wpdnr3723-a11y/WORKMODE/house/drawings/house_drawings.pdf

공 사 명 | 경산 진량 단독주택 신축공사
도 면 명 | 표지·건축개요·법규검토
도면번호 | A-000 | 축 척 | NONE

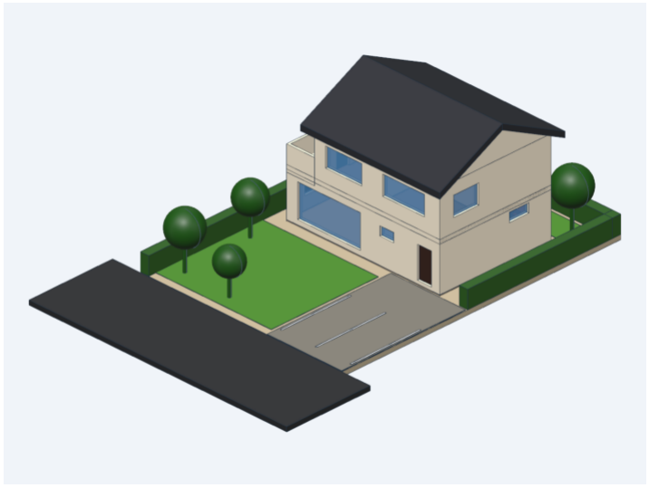
[picture p5: figure]

일 자 | 2026. 11. | 설 계 | 건축사 (미정) ※ 인허가·실시설계 검토용 초안입니다. 건축사·구조기술사의 검토와 날인 전에는 시공·제출에 쓰지 않습니다. 치수 단위 mm, 레벨 기준 GL±0 (설계 지반고).

# 경산 진량 단독주택 신축공사

# 인허가·실시설계 도서 (초안)

# 건축개요

구분 | 내용
대지위치 | 경상북도 경산시 진량읍 신제리·다문리 일원
| 경산4일반산업단지 단독주택용지 (필지번호 미정)
지역·지구 | 제1종일반주거지역, 경산4일반산업단지 지구단위계획구역
용도 | 단독주택 (제1종 근린생활시설 없음)
구조 | 철근콘크리트 벽식구조 (일부 보), 박공지붕
대지면적 | 290.00㎡
건축면적 | 82.39㎡
연면적 | 149.38㎡ (1층 82.39 / 2층 66.99)
건폐율 / 용적률 | 28.41% / 51.51%
규모 / 높이 | 지상 2층 / 8.68 m (층고 3.0 m)
주차 / 조경 | 2대 / 87.90㎡
단열 (계획 U, W/㎡K) | 외벽 0.188 / 지붕 0.120 / 바닥 0.195 / 창 1.0 이하

# 도면 목록

번호 | 도면명 | 축척
A-000 | 표지·건축개요·법규검토 | -
A-001 | 면적표·창호일람표·실내재료마감표 | -
A-101 | 배치도 | 1/100
A-201 | 1층 평면도 | 1/50
A-202 | 2층 평면도 | 1/50
A-203 | 지붕 평면도 | 1/50
A-301 | 남측 입면도 | 1/50
A-302 | 북측 입면도 | 1/50
A-303 | 동측 입면도 | 1/50
A-304 | 서측 입면도 | 1/50
A-401 | 단면도 A-A' | 1/50
A-402 | 단면도 B-B' | 1/50
A-501 | 구조단면 상세 | 1/20
S-001 | 구조 일반사항·부재일람표 | -
S-101 | 구조 평면도 | 1/100

# 법규 검토

항목 | 계획 | 기준 | 판정
건폐율 | 82.39 / 290 = 28.41% | 60% 이하 | 적합
용적률 | 149.38 / 290 = 51.51% | 180% 이하 | 적합
층수·높이 | 지상 2층, 최고높이 8.68 m | 3층 이하 | 적합
정북 일조 | 정북 인접대지경계선에서 3.0 m | 높이 10 m 이하 부분 1.5 m 이상 | 적합
접도 | 폭 6 m 도로에 14.5 m 접함 | 4 m 이상 도로에 2 m 이상 | 적합
주차 | 2대 (2.5 x 5.0 m 일반형) | 1대 이상 | 적합
조경 | 87.9 ㎡ (30%) | 경산시 건축조례 기준 | 적합
계단 | 단높이 176.5 / 단너비 260 / 너비 1000 mm | 200 이하 / 240 이상 / 600 이상 | 적합
난간 | 테라스·계단 개구부 1200 mm | 1,200 mm 이상 | 적합
인접 이격 | 서 1.5 m, 동 2.0 m, 북 3.0 m, 남 9.0 m | 0.5 m 이상 | 적합
처마 | 내밀기 0.5 m | 1 m 미만 → 건축면적 불산입 | 적합
내진 | 지상 2층 → 구조안전 확인 대상 | 내진설계 적용 | 적합
허용용도 | 단독주택 (다중주택 아님) | 단독주택·점포주택 | 적합
건축한계선 | 전면 도로 6 m (소로), 도로 이격 9.0 m | 대로 2 m / 중로 1 m | 적합
담장 | 생울타리 H1,200 | 1.2 m 이하 투시형 또는 생울타리 | 적합
옥상 설비 | 실외기 지상 설치, 지붕 위 설비 없음 | 도로에서 보이지 않게 | 적합

대지 290.00 ㎡ · 건축면적 82.39 ㎡ · 연면적 149.38 ㎡ (1층 82.39, 2층 66.99) · 층고 3.0 m

※ 기준값은 공개 자료 기준이며 해당 필지의 지구단위계획 결정도서로 확인이 필요합니다.

공 사 명 | 경산 진량 단독주택 신축공사
도 면 명 | 면적표·창호일람표·실내재료마감표
도면번호 | A-001 | 축 척 | NONE

# 면적표

층 | 바닥면적(㎡) | 용도
1층 | 82.39 | 단독주택
2층 | 66.99 | 단독주택
합계 | 149.38
층 | 실명 | 면적(㎡)
1층 | 거실 | 21.09
1층 | 주방·식당 | 21.09
1층 | 화장실 | 5.06
1층 | 현관 | 4.62
1층 | 홀 | 10.18
1층 | 다용도실 | 5.52
1층 | 계단실 | 6.47
2층 | 안방 | 15.91
2층 | 드레스룸 | 5.01
2층 | 욕실 | 5.46
2층 | 방2 | 14.10
2층 | 홀 | 11.95
2층 | 테라스 | 14.25

※ 바닥면적: 외벽 중심선 (외단열 포함 벽두께의 중심)

※ 실면적: 마감면 기준 안목치수

# 창호일람표

기호 | 층 | 위치 | 규격 W x H | 하단 | 형식·사양
W1 | 1F | 거실 | 4,500 x 2,200 | FL+100 | PVC 시스템 슬라이딩도어, 43mm 삼중 로이유리
W2 | 1F | 화장실 | 1,000 x 600 | FL+1,500 | PVC 시스템창호, 24mm 삼중 로이유리 (불투명)
D1 | 1F | 현관 | 1,000 x 2,100 | FL+0 | 단열 현관문 (방화·방범), 열관류율 1.4 이하
W3 | 1F | 주방 | 2,400 x 1,100 | FL+1,000 | PVC 시스템창호, 24mm 삼중 로이유리
W4 | 1F | 다용도실 | 1,000 x 900 | FL+1,200 | PVC 시스템창호, 24mm 삼중 로이유리
W5 | 1F | 거실 | 2,500 x 1,300 | FL+900 | PVC 시스템창호, 24mm 삼중 로이유리
W6 | 1F | 식당 | 2,000 x 1,300 | FL+900 | PVC 시스템창호, 24mm 삼중 로이유리
W7 | 1F | 계단실 | 1,400 x 600 | FL+2,000 | PVC 시스템창호, 24mm 삼중 로이유리
W8 | 2F | 안방 | 2,600 x 1,300 | FL+900 | PVC 시스템창호, 24mm 삼중 로이유리
W9 | 2F | 방2 | 3,000 x 1,300 | FL+900 | PVC 시스템창호, 24mm 삼중 로이유리
W10 | 2F | 욕실 | 1,000 x 600 | FL+1,500 | PVC 시스템창호, 24mm 삼중 로이유리 (불투명)
W11 | 2F | 홀 | 1,800 x 1,200 | FL+900 | PVC 시스템창호, 24mm 삼중 로이유리
D2 | 2F | 안방 | 900 x 2,100 | FL+0 | PVC 시스템 여닫이문, 24mm 삼중 로이유리
W12 | 2F | 안방 | 1,600 x 1,300 | FL+900 | PVC 시스템창호, 24mm 삼중 로이유리
W13 | 2F | 방2 | 1,800 x 1,300 | FL+900 | PVC 시스템창호, 24mm 삼중 로이유리
AD1 | 1·2F | 3개소 | 900 x 2,100 | FL | ABS 도어 + 목재 문틀
AD2 | 1·2F | 4개소 | 800 x 2,100 | FL | ABS 도어 (욕실·다용도: 방수형)
AD3 | 1·2F | 1개소 | 900 x 2,100 | FL | 현관 중문 (강화유리 + 알루미늄 프레임)

# 실내재료마감표

층 | 실명 | 바닥 | 걸레받이 | 벽 | 천장 | 반자높이
1F | 거실 | 강마루 THK10 | PVC 걸레받이 H80 | 실크벽지 | 석고보드 9.5 2겹 위 수성페인트 | 2,400
1F | 주방·식당 | 강마루 THK10 | PVC 걸레받이 H80 | 실크벽지 | 석고보드 9.5 2겹 위 수성페인트 | 2,400
1F | 화장실 | 포세린타일 300x300 (논슬립) | - | 포세린타일 300x600 | SMC 천장재 | 2,400
1F | 현관 | 포세린타일 600x600 | 타일 걸레받이 H100 | 실크벽지 | 석고보드 9.5 2겹 위 수성페인트 | 2,400
1F | 홀 | 강마루 THK10 | PVC 걸레받이 H80 | 실크벽지 | 석고보드 9.5 2겹 위 수성페인트 | 2,400
1F | 다용도실 | 포세린타일 300x300 | 타일 걸레받이 H100 | 수성페인트 | 석고보드 9.5 2겹 위 수성페인트 | 2,400
1F | 계단실 | 강마루 계단재 | - | 실크벽지 | 석고보드 위 수성페인트 | 2,400
2F | 안방 | 강마루 THK10 | PVC 걸레받이 H80 | 실크벽지 | 석고보드 9.5 2겹 위 수성페인트 | 2,400
2F | 드레스룸 | 강마루 THK10 | PVC 걸레받이 H80 | 실크벽지 | 석고보드 9.5 2겹 위 수성페인트 | 2,400
2F | 욕실 | 포세린타일 300x300 (논슬립) | - | 포세린타일 300x600 | SMC 천장재 | 2,400
2F | 방2 | 강마루 THK10 | PVC 걸레받이 H80 | 실크벽지 | 석고보드 9.5 2겹 위 수성페인트 | 2,400
2F | 홀 | 강마루 THK10 | PVC 걸레받이 H80 | 실크벽지 | 석고보드 9.5 2겹 위 수성페인트 | 2,400
2F | 테라스 | 합성목재 데크 (우레탄 도막방수 위) | - | 스터코 (외벽) | - | -

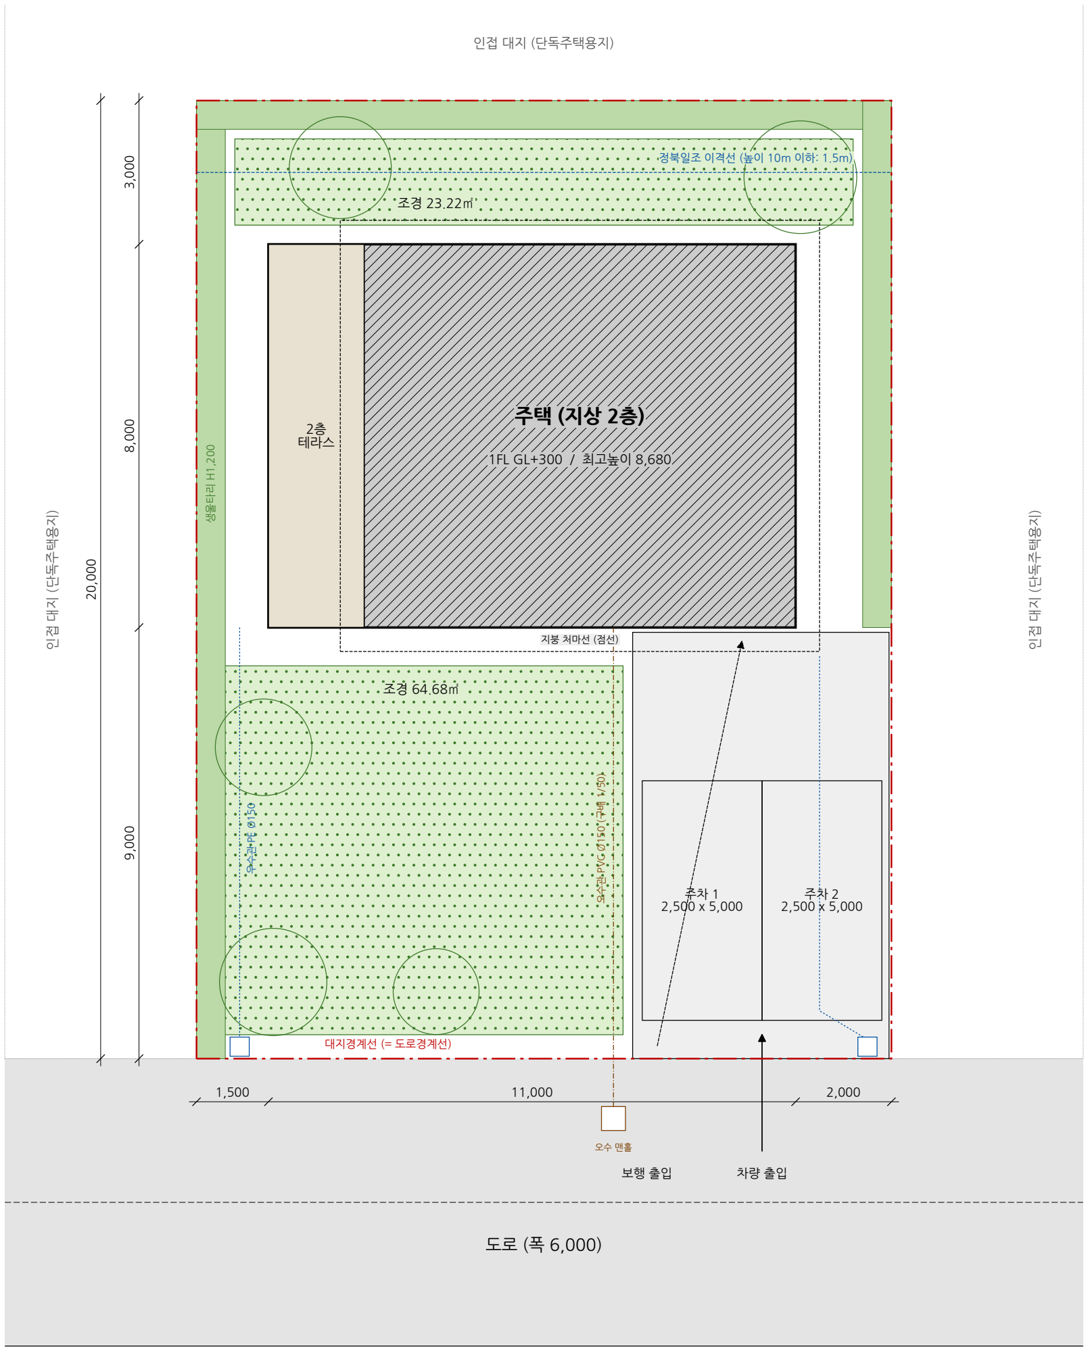
[picture p6: figure]
인접 대지 (단독주택용지); 1FL GL+300 / 최고높이 8,680; 2층 테라스; 지붕 처마선 (점선); 대지경계선 (= 도로경계선); 정북일조 이격선 (높이 10m 이하: 1.5m); 오수관 PVC Ø150 (구배 1/50); 우수관 PE Ø150; 생울타리 H1,200

14,500

공 사 명 | 경산 진량 단독주택 신축공사
도 면 명 | 배치도
도면번호 | A-101 | 축 척 | 1/100

# 배치도

SCALE 1/100
N
항목 | 내용
대지위치 | 경상북도 경산시 진량읍 신제리·다문리 일원
| 경산4일반산업단지 단독주택용지 (필지번호 미정)
지역·지구 | 제1종일반주거지역, 지구단위계획구역
대지면적 | 290.00㎡ (14,500 x 20,000)
건축면적 | 82.39㎡ (건폐율 28.41% / 60%)
연면적 | 149.38㎡ (용적률 51.51% / 180%)
규모·높이 | 지상 2층, 최고높이 8.68m
주차 | 2대 (법정 1대), 일반형 2.5 x 5.0 m
조경 | 87.90㎡ (30.3%)
이격거리 | 정북 3.0m, 서 1.5m, 동 2.0m, 남 9.0m

※ 필지 확정 후 지적측량 성과도로 대지 형상·면적·도로 폭을 다시 확인합니다.

※ 오수: 분류식 공공하수관 직접 연결 (정화조 없음, 지구 하수계획 확인).

※ 설계 지반고 GL±0 = 도로 경계 보도 상단 +150 (현황측량 후 확정).

※ 우수: 선홈통 → 우수관 → 도로측 우수 맨홀 (빗물 침투 화단 병행 검토).

# 1층 평면도

N

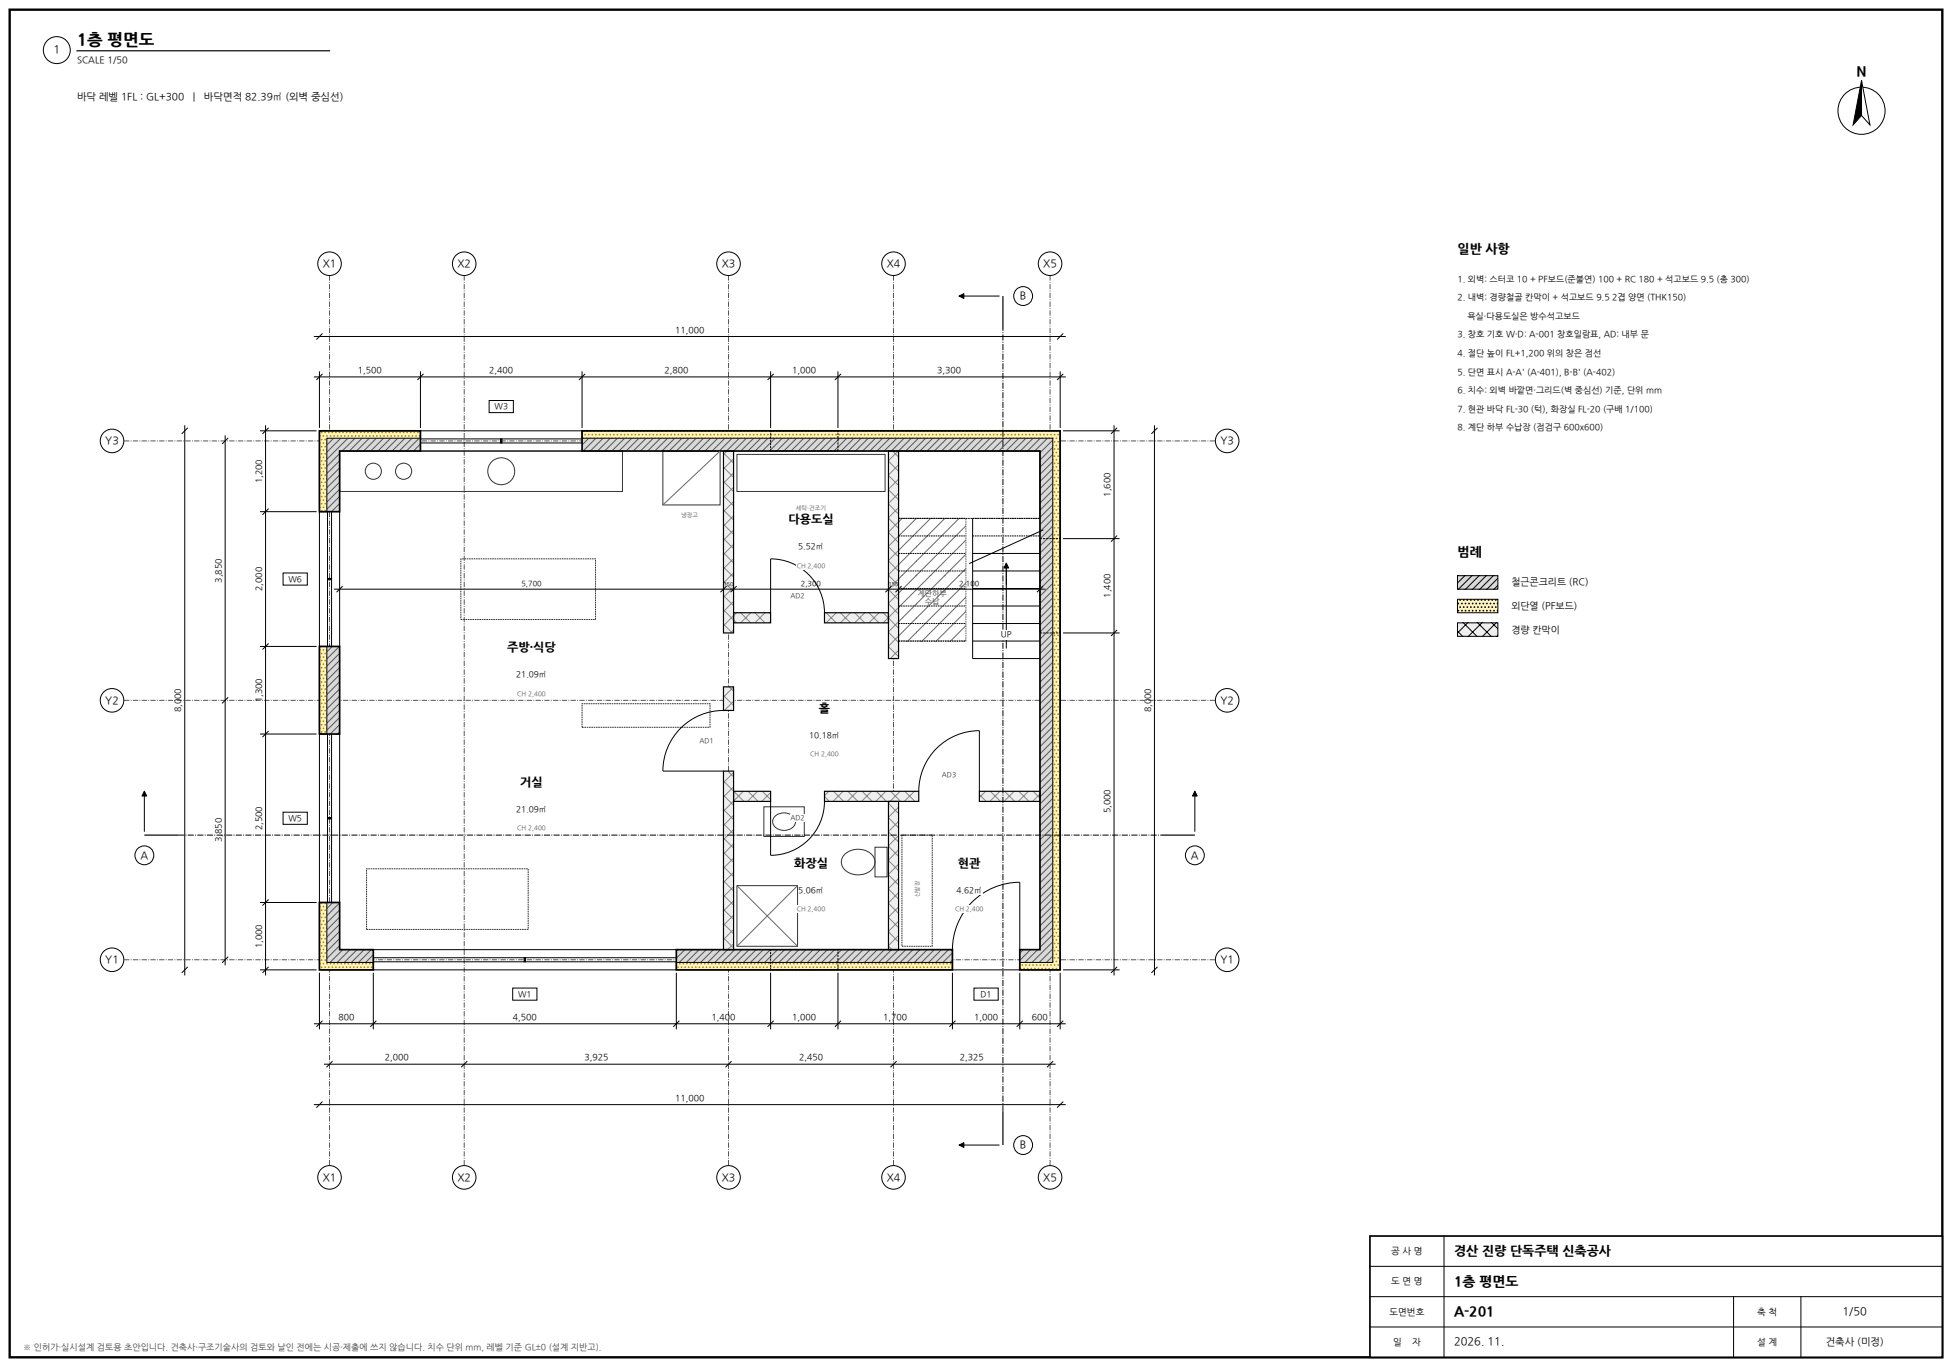
[picture p7: page 4]
계단하부; 냉장고; 세탁·건조기; 신발장; 화장실; 다용도실; 경산 진량 단독주택 신축공사; 1층 평면도; 도면번호; 철근콘크리트 (RC); 외단열 (PF보드); 경량 칸막이

바닥 레벨 1FL : GL+300 | 바닥면적 82.39㎡ (외벽 중심선)

1. 외벽: 스터코 10 + PF보드(준불연) 100 + RC 180 + 석고보드 9.5 (총 300)

2. 내벽: 경량철골 칸막이 + 석고보드 9.5 2겹 양면 (THK150)

욕실·다용도실은 방수석고보드

3. 창호 기호 W·D: A-001 창호일람표, AD: 내부 문

6. 치수: 외벽 바깥면·그리드(벽 중심선) 기준, 단위 mm

7. 현관 바닥 FL-30 (턱), 화장실 FL-20 (구배 1/100)

8. 계단 하부 수납장 (점검구 600x600)

# 2층 평면도

N

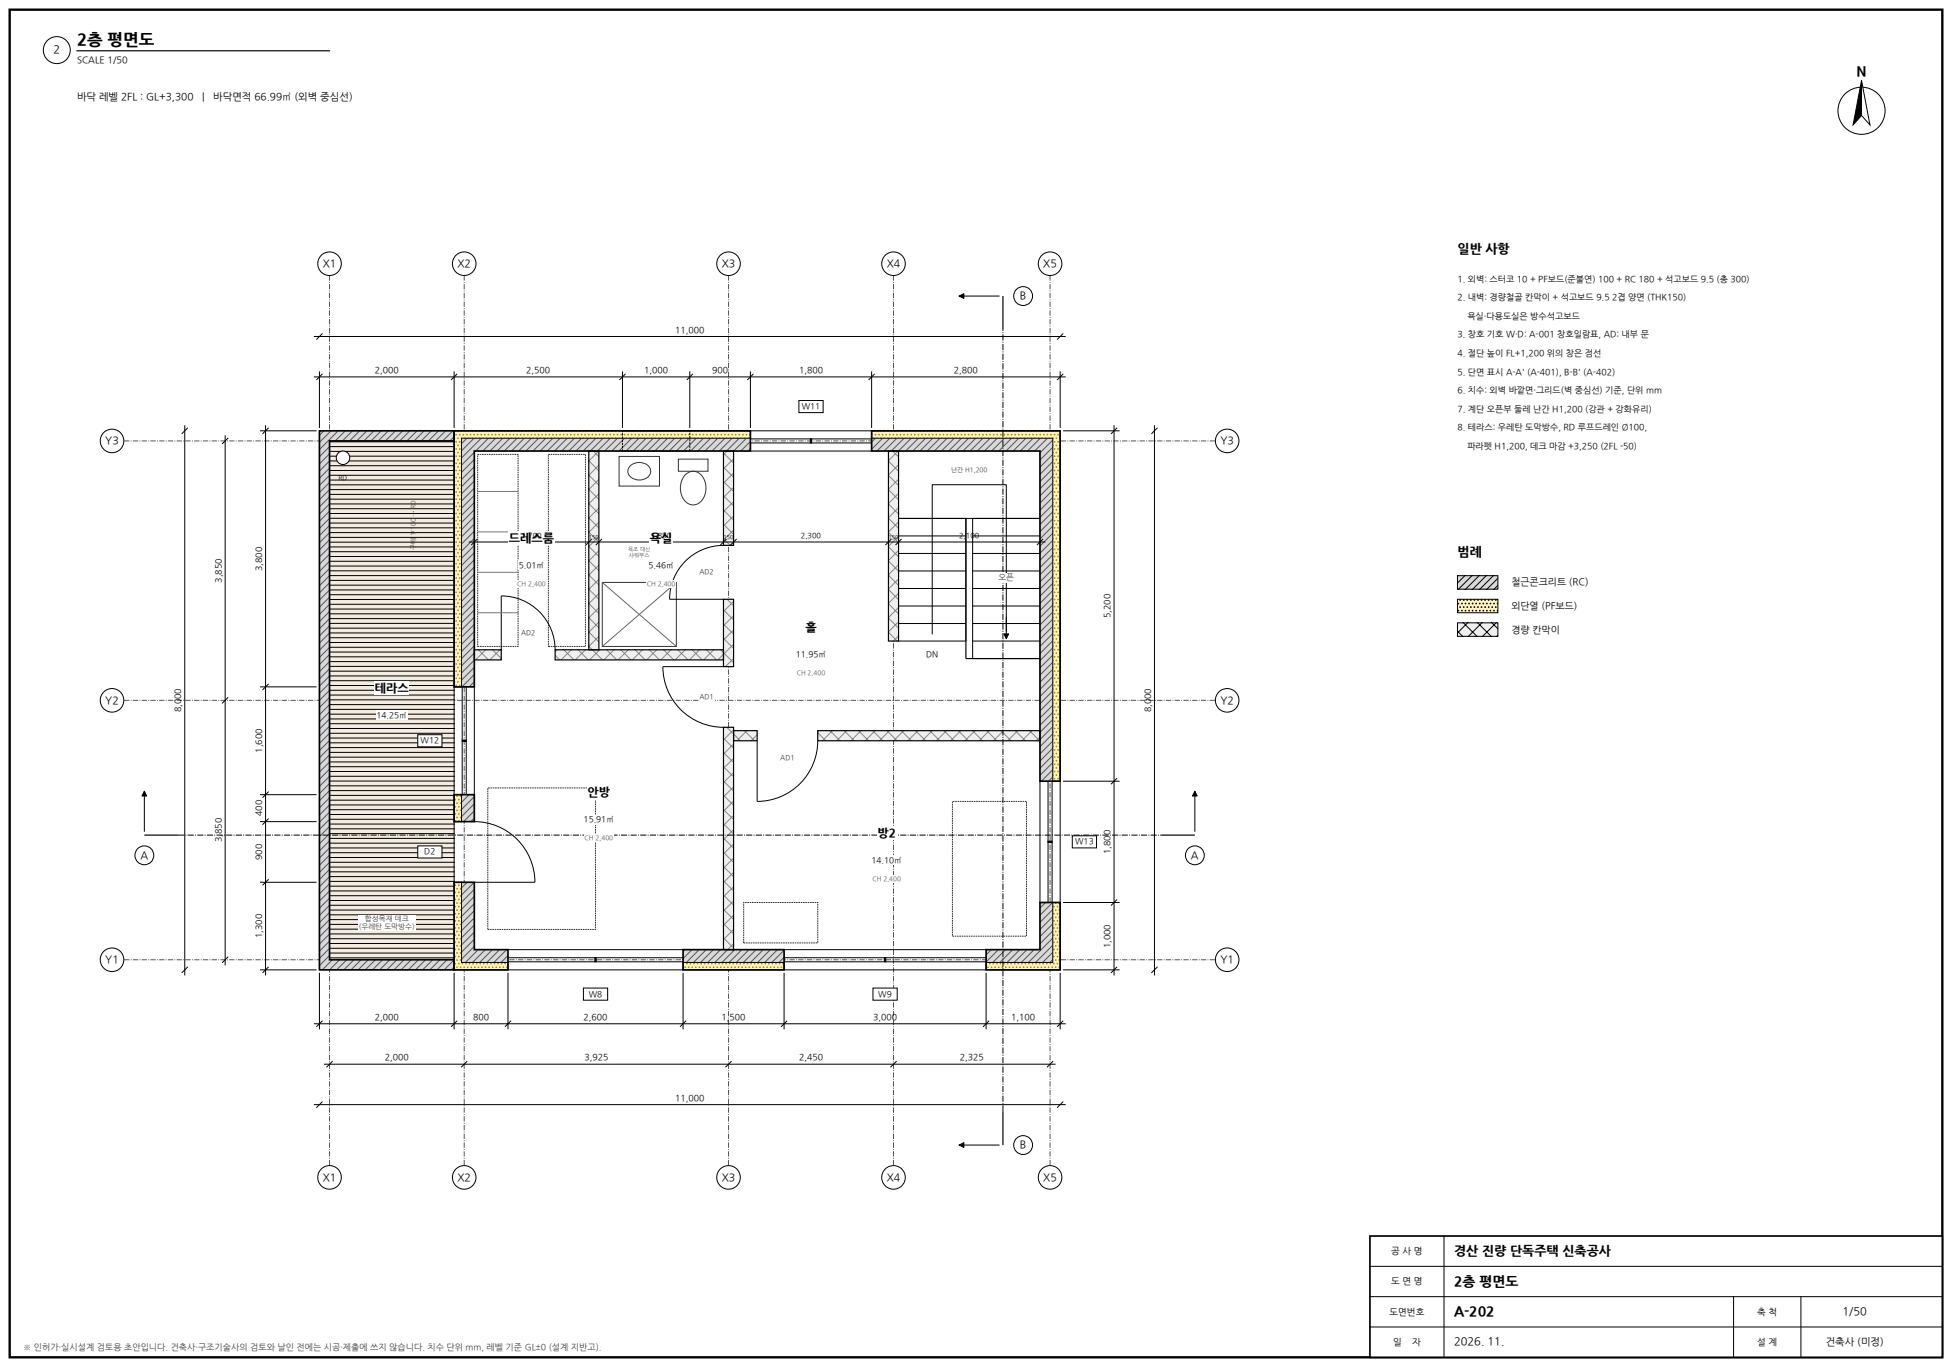
[picture p8: page 5]
합성목재 데크 (우레탄 도막방수); 욕조 대신 샤워부스; 테라스; 경산 진량 단독주택 신축공사; 2층 평면도; 도면번호; 철근콘크리트 (RC); 외단열 (PF보드); 경량 칸막이

바닥 레벨 2FL : GL+3,300 | 바닥면적 66.99㎡ (외벽 중심선)

1. 외벽: 스터코 10 + PF보드(준불연) 100 + RC 180 + 석고보드 9.5 (총 300)

2. 내벽: 경량철골 칸막이 + 석고보드 9.5 2겹 양면 (THK150)

욕실·다용도실은 방수석고보드

3. 창호 기호 W·D: A-001 창호일람표, AD: 내부 문

6. 치수: 외벽 바깥면·그리드(벽 중심선) 기준, 단위 mm

7. 계단 오픈부 둘레 난간 H1,200 (강관 + 강화유리)

8. 테라스: 우레탄 도막방수, RD 루프드레인 Ø100,

파라펫 H1,200, 데크 마감 +3,250 (2FL -50)

드레스룸 욕실 | | 난간 H1,200

# 지붕 평면도

N

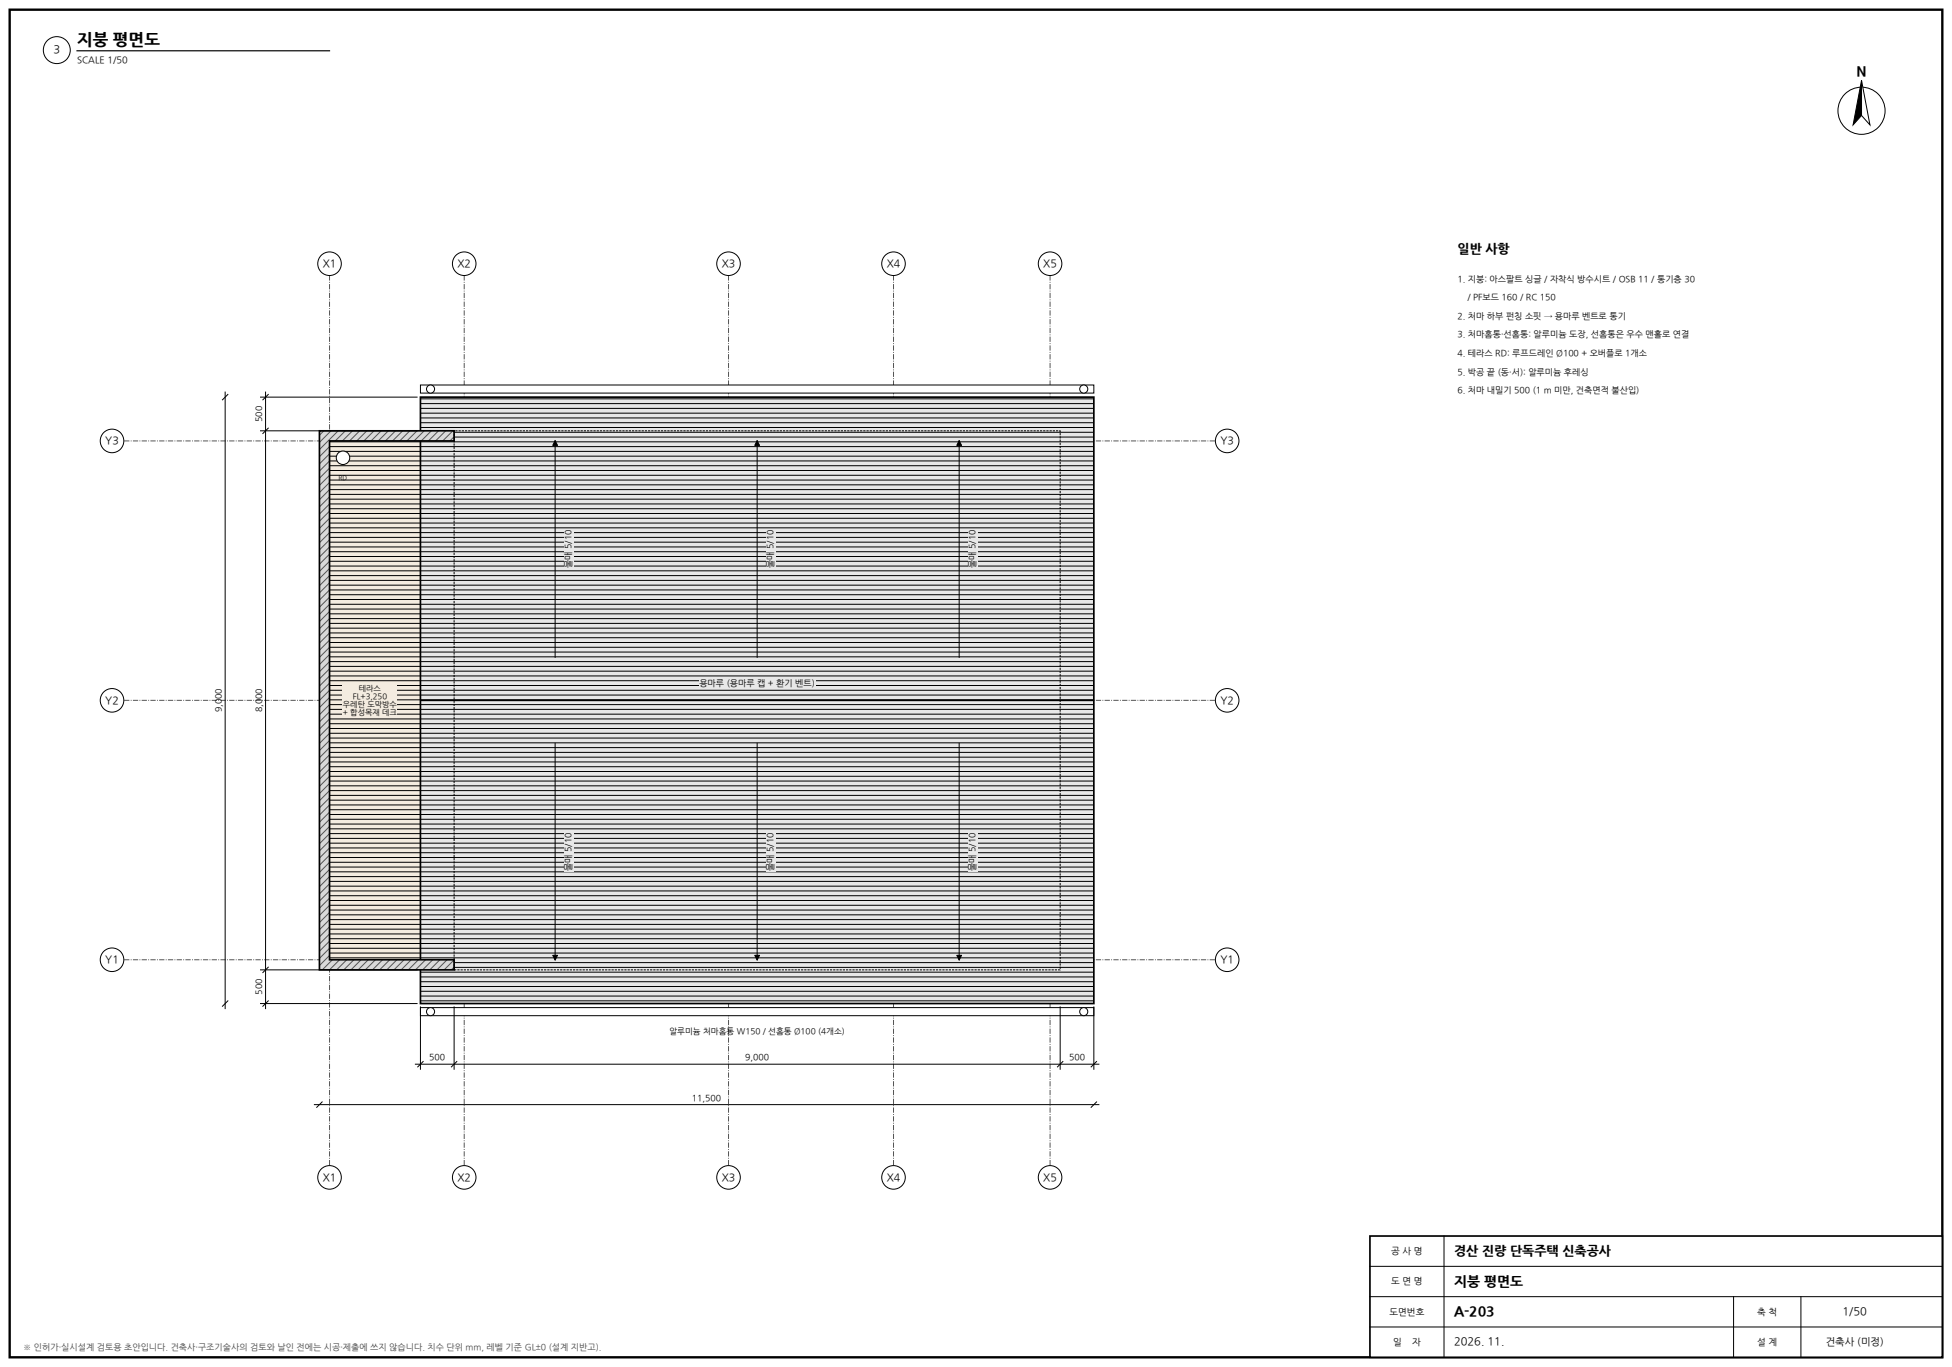
[picture p9: page 6]
테라스 FL+3,250 우레탄 도막방수 + 합성목재 데크; 경산 진량 단독주택 신축공사; 지붕 평면도; 도면번호; / PF보드 160 / RC 150

1. 지붕: 아스팔트 싱글 / 자착식 방수시트 / OSB 11 / 통기층 30

2. 처마 하부 펀칭 소핏 → 용마루 벤트로 통기

3. 처마홈통·선홈통: 알루미늄 도장, 선홈통은 우수 맨홀로 연결

4. 테라스 RD: 루프드레인 Ø100 + 오버플로 1개소

5. 박공 끝 (동·서): 알루미늄 후레싱

6. 처마 내밀기 500 (1 m 미만, 건축면적 불산입)

용마루 (용마루 캡 + 환기 벤트)

알루미늄 처마홈통 W150 / 선홈통 Ø100 (4개소)

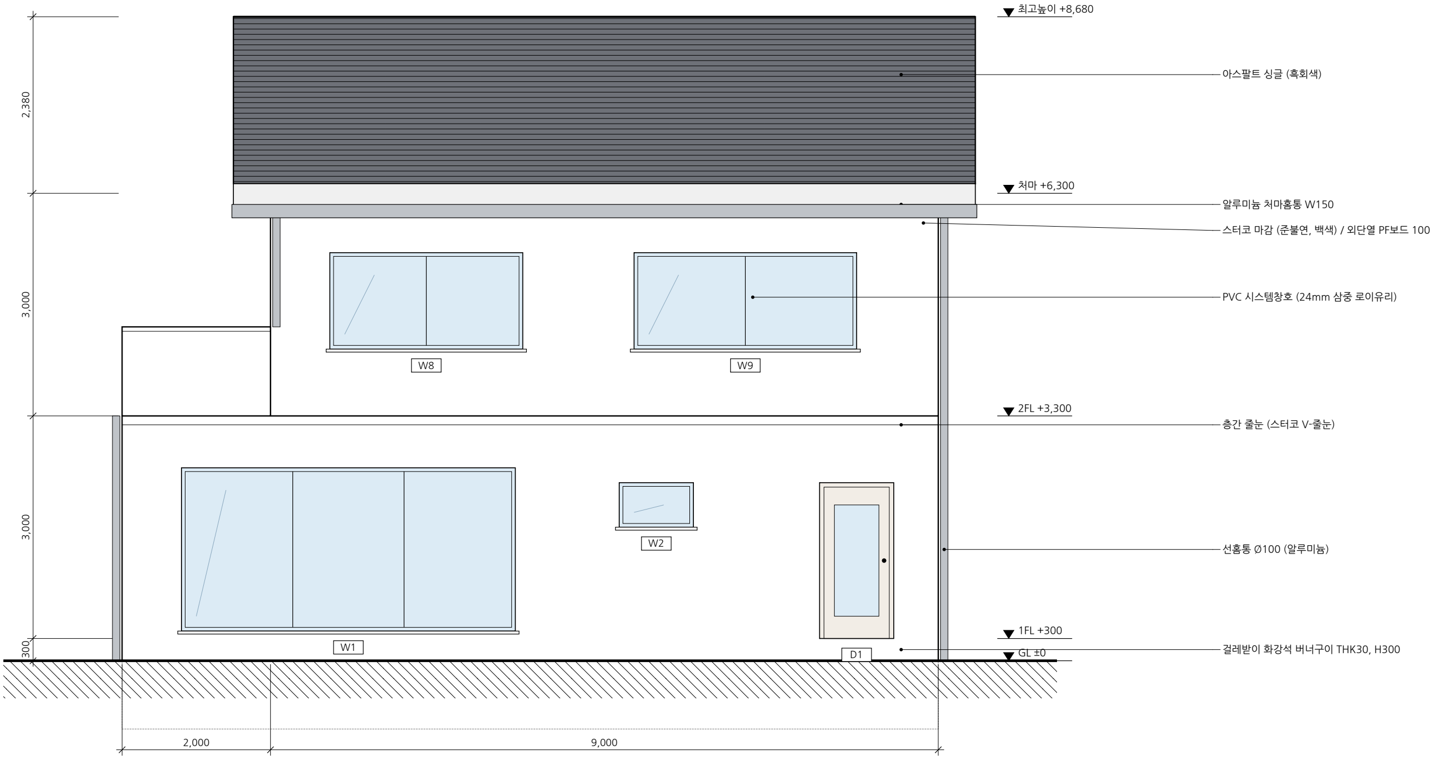
[picture p10: figure]
최고높이 +8,680; 아스팔트 싱글 (흑회색); 알루미늄 처마홈통 W150; 스터코 마감 (준불연, 백색) / 외단열 PF보드 100; PVC 시스템창호 (24mm 삼중 로이유리); 층간 줄눈 (스터코 V-줄눈); 선홈통 Ø100 (알루미늄); 걸레받이 화강석 버너구이 THK30, H300

8,680

공 사 명 | 경산 진량 단독주택 신축공사
도 면 명 | 남측 입면도
도면번호 | A-301 | 축 척 | 1/50

# 남측 입면도

## 외부 마감 사항

1. 외벽: 스터코(준불연) 백색, 하부 걸레받이 화강석 THK30 H300
2. 지붕: 아스팔트 싱글 (흑회색), 처마 하부 알루미늄 소핏
3. 창호: PVC 시스템창호 (회색 래핑), 24mm 삼중 로이유리
4. 홈통: 알루미늄 처마홈통 W150, 선홈통 Ø100
5. 테라스 파라펫: RC + 외단열, 상부 알루미늄 두겁

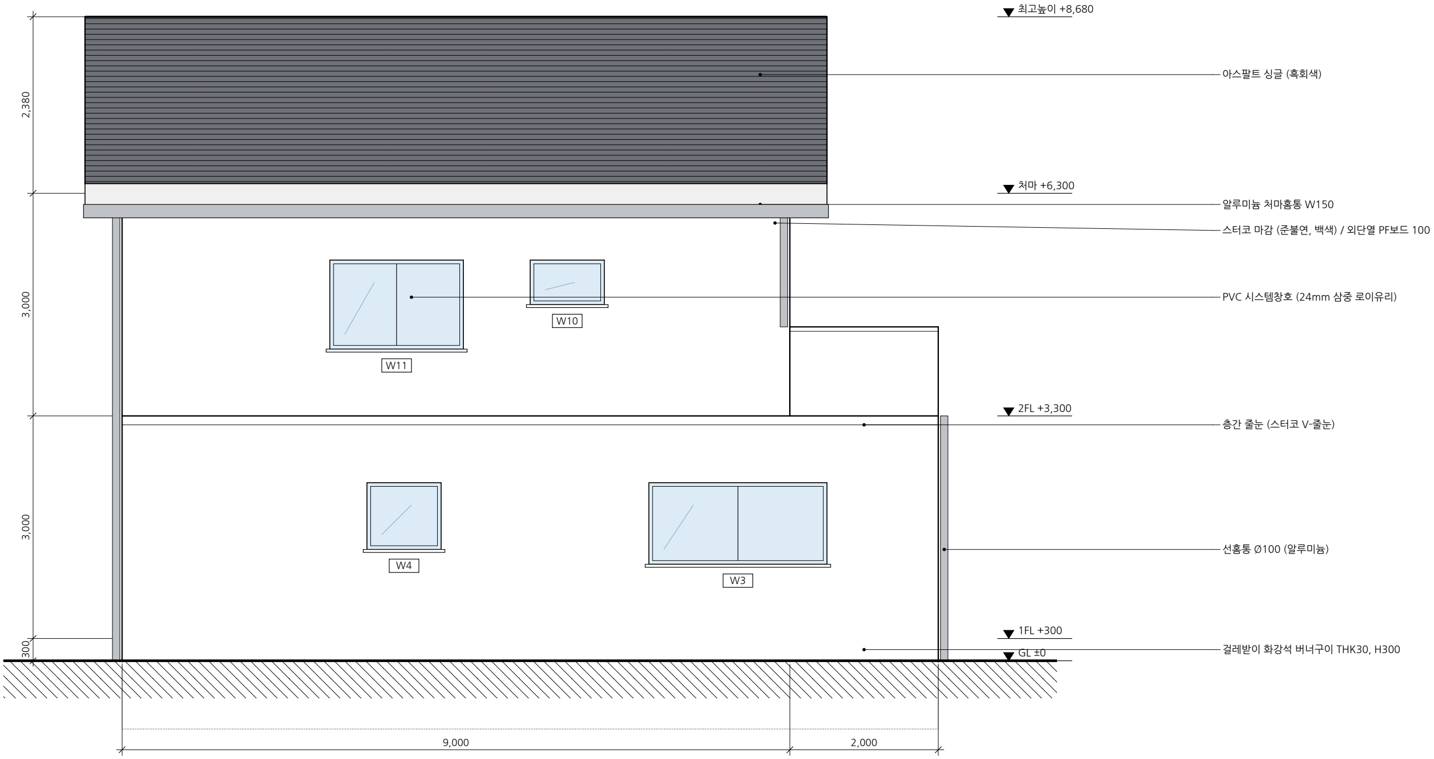
[picture p11: figure]
최고높이 +8,680; 아스팔트 싱글 (흑회색); 알루미늄 처마홈통 W150; 스터코 마감 (준불연, 백색) / 외단열 PF보드 100; PVC 시스템창호 (24mm 삼중 로이유리); 층간 줄눈 (스터코 V-줄눈); 선홈통 Ø100 (알루미늄); 걸레받이 화강석 버너구이 THK30, H300

8,680

공 사 명 | 경산 진량 단독주택 신축공사
도 면 명 | 북측 입면도
도면번호 | A-302 | 축 척 | 1/50

# 북측 입면도

## 외부 마감 사항

1. 외벽: 스터코(준불연) 백색, 하부 걸레받이 화강석 THK30 H300
2. 지붕: 아스팔트 싱글 (흑회색), 처마 하부 알루미늄 소핏
3. 창호: PVC 시스템창호 (회색 래핑), 24mm 삼중 로이유리
4. 홈통: 알루미늄 처마홈통 W150, 선홈통 Ø100
5. 테라스 파라펫: RC + 외단열, 상부 알루미늄 두겁

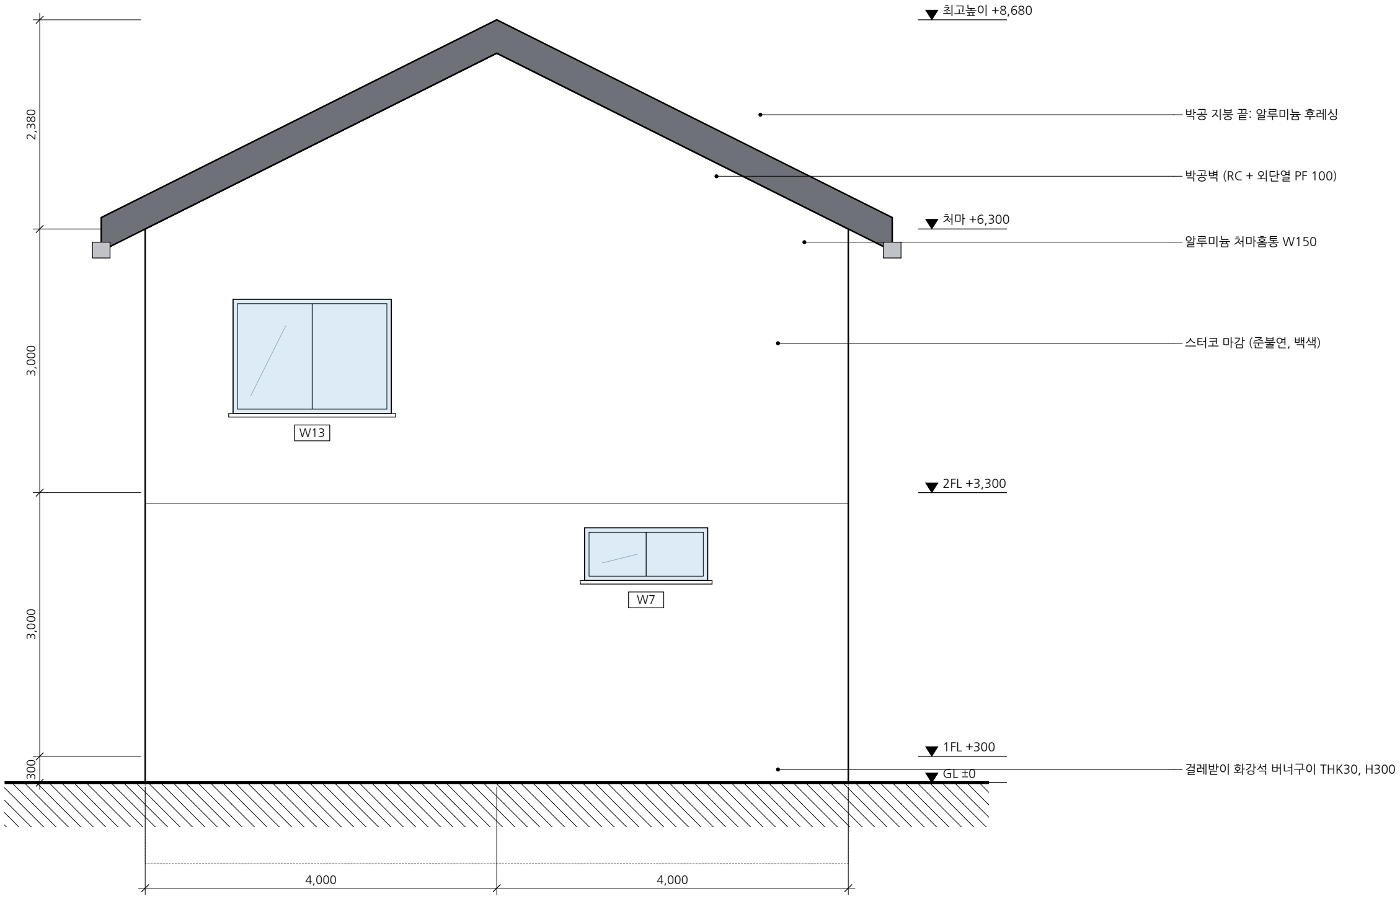
[picture p12: figure]
최고높이 +8,680; 박공 지붕 끝: 알루미늄 후레싱; 박공벽 (RC + 외단열 PF 100); 알루미늄 처마홈통 W150; 스터코 마감 (준불연, 백색); 걸레받이 화강석 버너구이 THK30, H300

8,680

공 사 명 | 경산 진량 단독주택 신축공사
도 면 명 | 동측 입면도
도면번호 | A-303 | 축 척 | 1/50

# 동측 입면도

## 외부 마감 사항

1. 외벽: 스터코(준불연) 백색, 하부 걸레받이 화강석 THK30 H300
2. 지붕: 아스팔트 싱글 (흑회색), 처마 하부 알루미늄 소핏
3. 창호: PVC 시스템창호 (회색 래핑), 24mm 삼중 로이유리
4. 홈통: 알루미늄 처마홈통 W150, 선홈통 Ø100
5. 테라스 파라펫: RC + 외단열, 상부 알루미늄 두겁

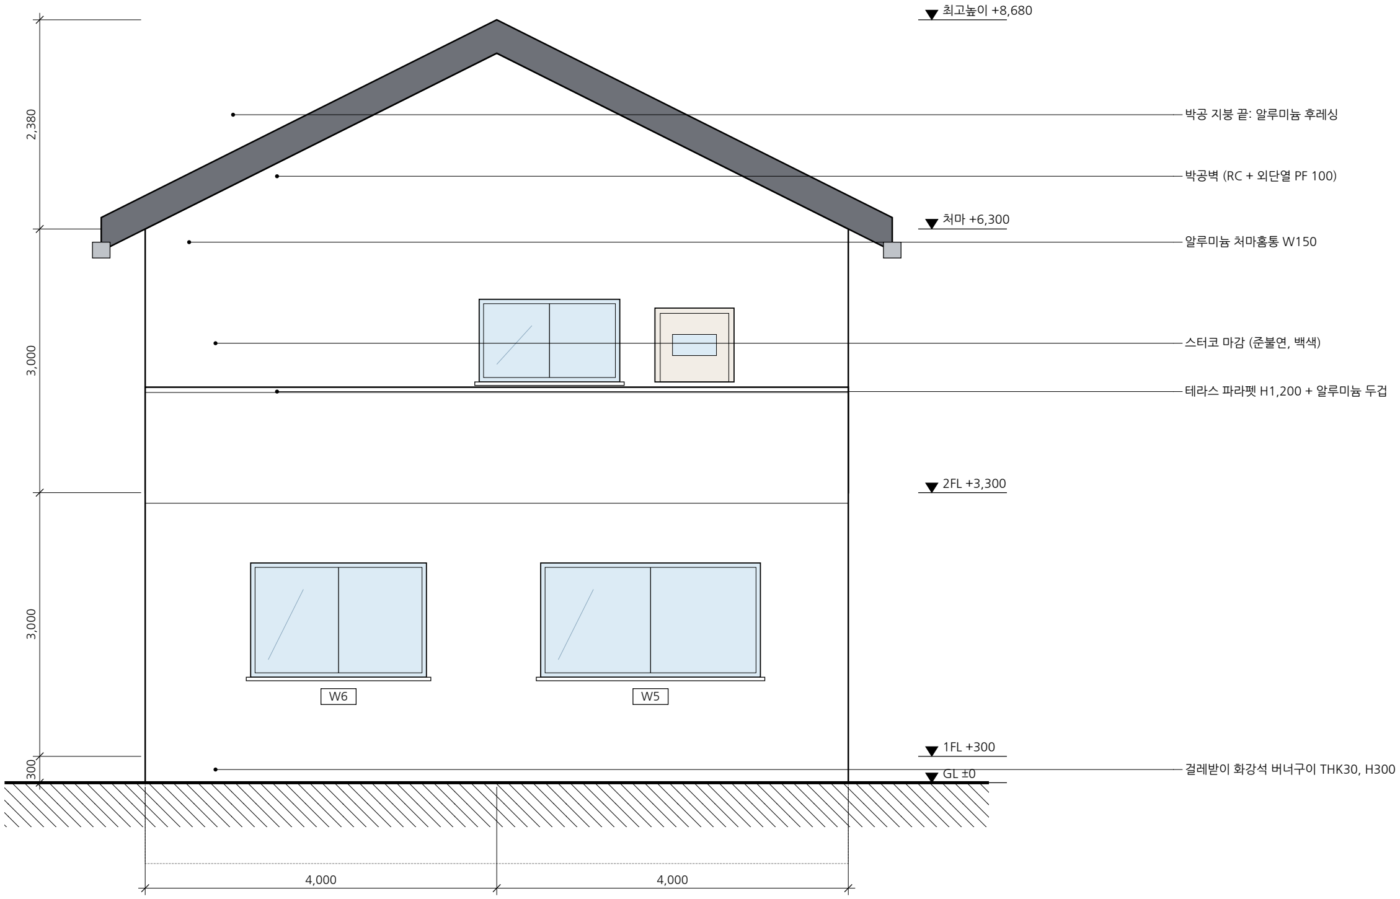
[picture p13: figure]
최고높이 +8,680; 박공 지붕 끝: 알루미늄 후레싱; 박공벽 (RC + 외단열 PF 100); 알루미늄 처마홈통 W150; 스터코 마감 (준불연, 백색); 테라스 파라펫 H1,200 + 알루미늄 두겁; 걸레받이 화강석 버너구이 THK30, H300

8,680

공 사 명 | 경산 진량 단독주택 신축공사
도 면 명 | 서측 입면도
도면번호 | A-304 | 축 척 | 1/50

# 서측 입면도

## 외부 마감 사항

1. 외벽: 스터코(준불연) 백색, 하부 걸레받이 화강석 THK30 H300
2. 지붕: 아스팔트 싱글 (흑회색), 처마 하부 알루미늄 소핏
3. 창호: PVC 시스템창호 (회색 래핑), 24mm 삼중 로이유리
4. 홈통: 알루미늄 처마홈통 W150, 선홈통 Ø100
5. 테라스 파라펫: RC + 외단열, 상부 알루미늄 두겁

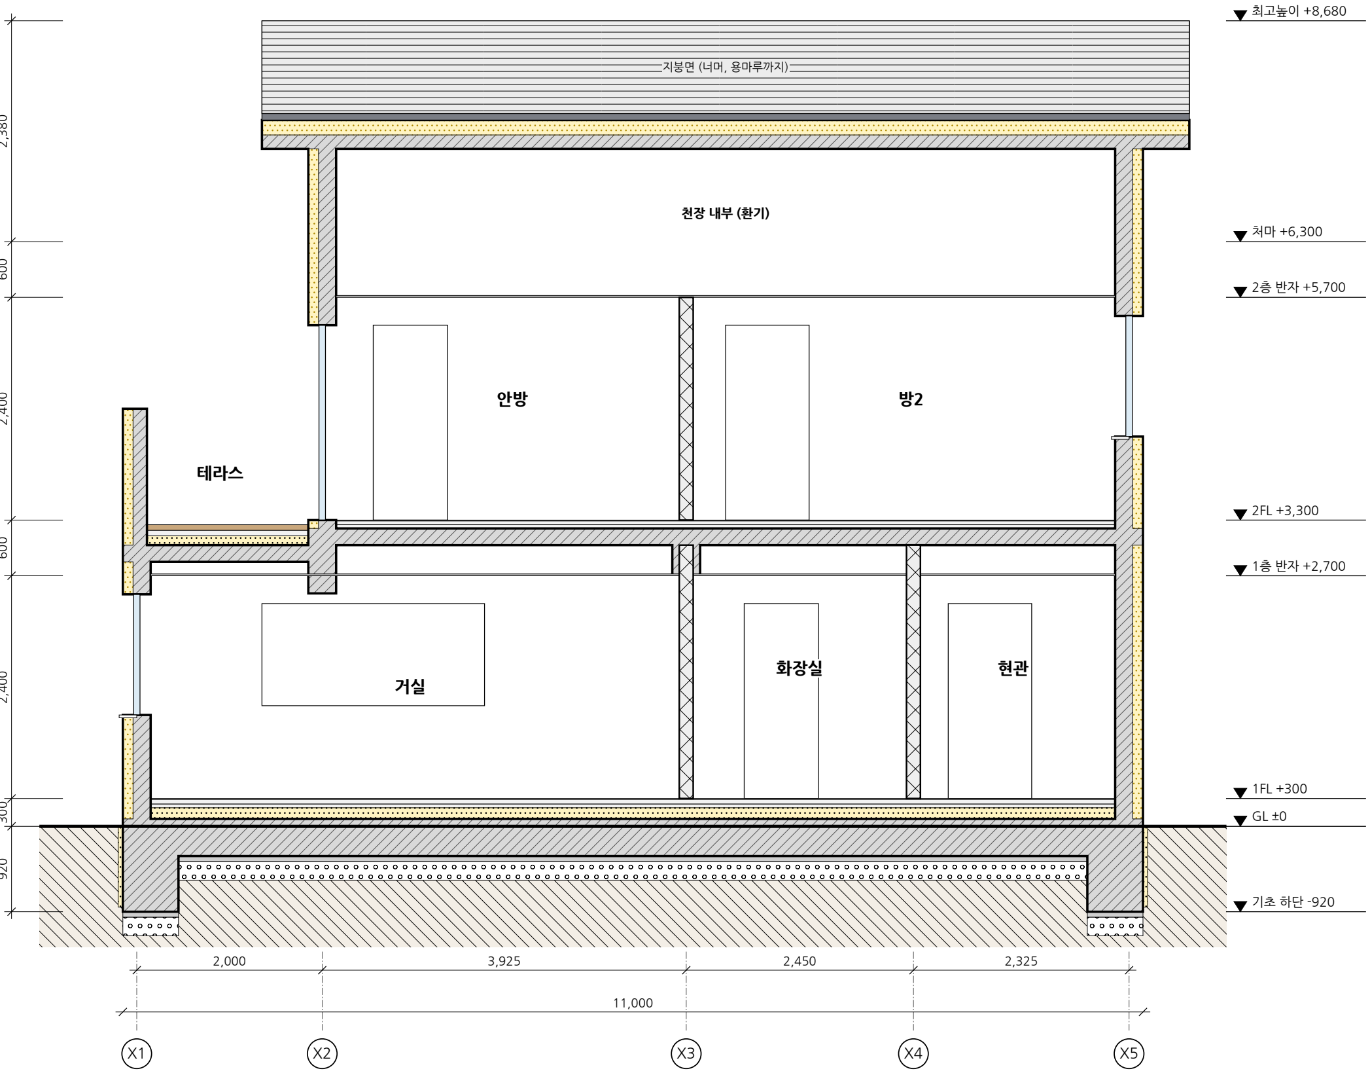
[picture p14: figure]
지붕면 (너머, 용마루까지); 화장실; 테라스; 최고높이 +8,680

920 300 2,400 600 2,400 600 2,380

8,680

공 사 명 | 경산 진량 단독주택 신축공사
도 면 명 | 단면도 A-A'
도면번호 | A-401 | 축 척 | 1/50

# 단면도 A-A'

절단 위치: 평면도 A-A' (y = 11,000 위치에서 북측을 봄)

## 일반 사항

1. 지붕: 싱글 / 방수시트 / OSB 11 / 통기층 30 / PF보드 160 / RC 150
2. 외벽: 스터코 10 / PF보드 100 / RC 180 / 석고보드 9.5
3. 1층 바닥: 강마루 10 / 미장 50 / 기포 40 / XPS 특호 120

/ PE필름 / 매트기초 400

5. 2층 바닥: 강마루 10 / 미장 40 / 기포 40 / RC 180
6. 테라스: 데크 / 보호몰탈 / 우레탄 도막방수 / PF보드 100 / RC 180
7. 기초: 매트 F1 THK400 + 외곽 기초보 FG1 (하단 GL-920)
8. 천장: 경량철골 천장틀 + 석고보드 9.5 2겹, 천장 내부 환기
9. 상세: A-501 구조단면 상세, 부재: S-001 부재일람표

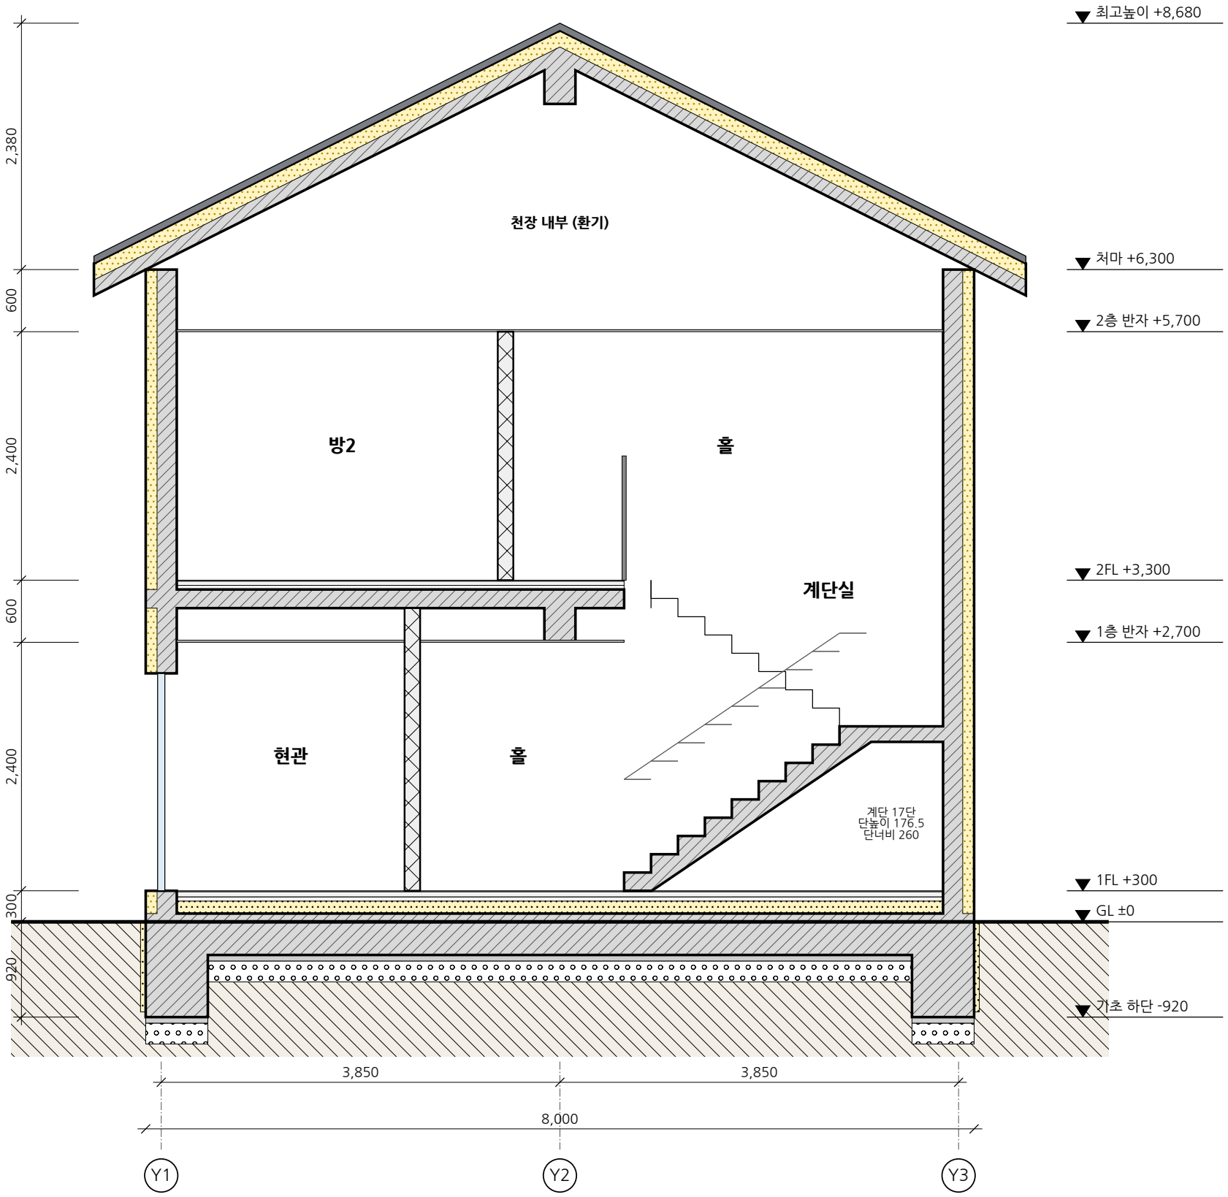
[picture p15: figure]
계단 17단 단높이 176.5 단너비 260; 계단실; 최고높이 +8,680

8,680

공 사 명 | 경산 진량 단독주택 신축공사
도 면 명 | 단면도 B-B'
도면번호 | A-402 | 축 척 | 1/50

# 단면도 B-B'

절단 위치: 평면도 B-B' (x = 11,650 위치에서 서측을 봄 (계단 절단))

## 일반 사항

1. 지붕: 싱글 / 방수시트 / OSB 11 / 통기층 30 / PF보드 160 / RC 150
2. 외벽: 스터코 10 / PF보드 100 / RC 180 / 석고보드 9.5
3. 1층 바닥: 강마루 10 / 미장 50 / 기포 40 / XPS 특호 120

/ PE필름 / 매트기초 400

5. 2층 바닥: 강마루 10 / 미장 40 / 기포 40 / RC 180
6. 테라스: 데크 / 보호몰탈 / 우레탄 도막방수 / PF보드 100 / RC 180
7. 기초: 매트 F1 THK400 + 외곽 기초보 FG1 (하단 GL-920)
8. 천장: 경량철골 천장틀 + 석고보드 9.5 2겹, 천장 내부 환기
9. 상세: A-501 구조단면 상세, 부재: S-001 부재일람표

# 상세 1 기초·외벽·1층 바닥

# 상세 2 2층 바닥·외벽

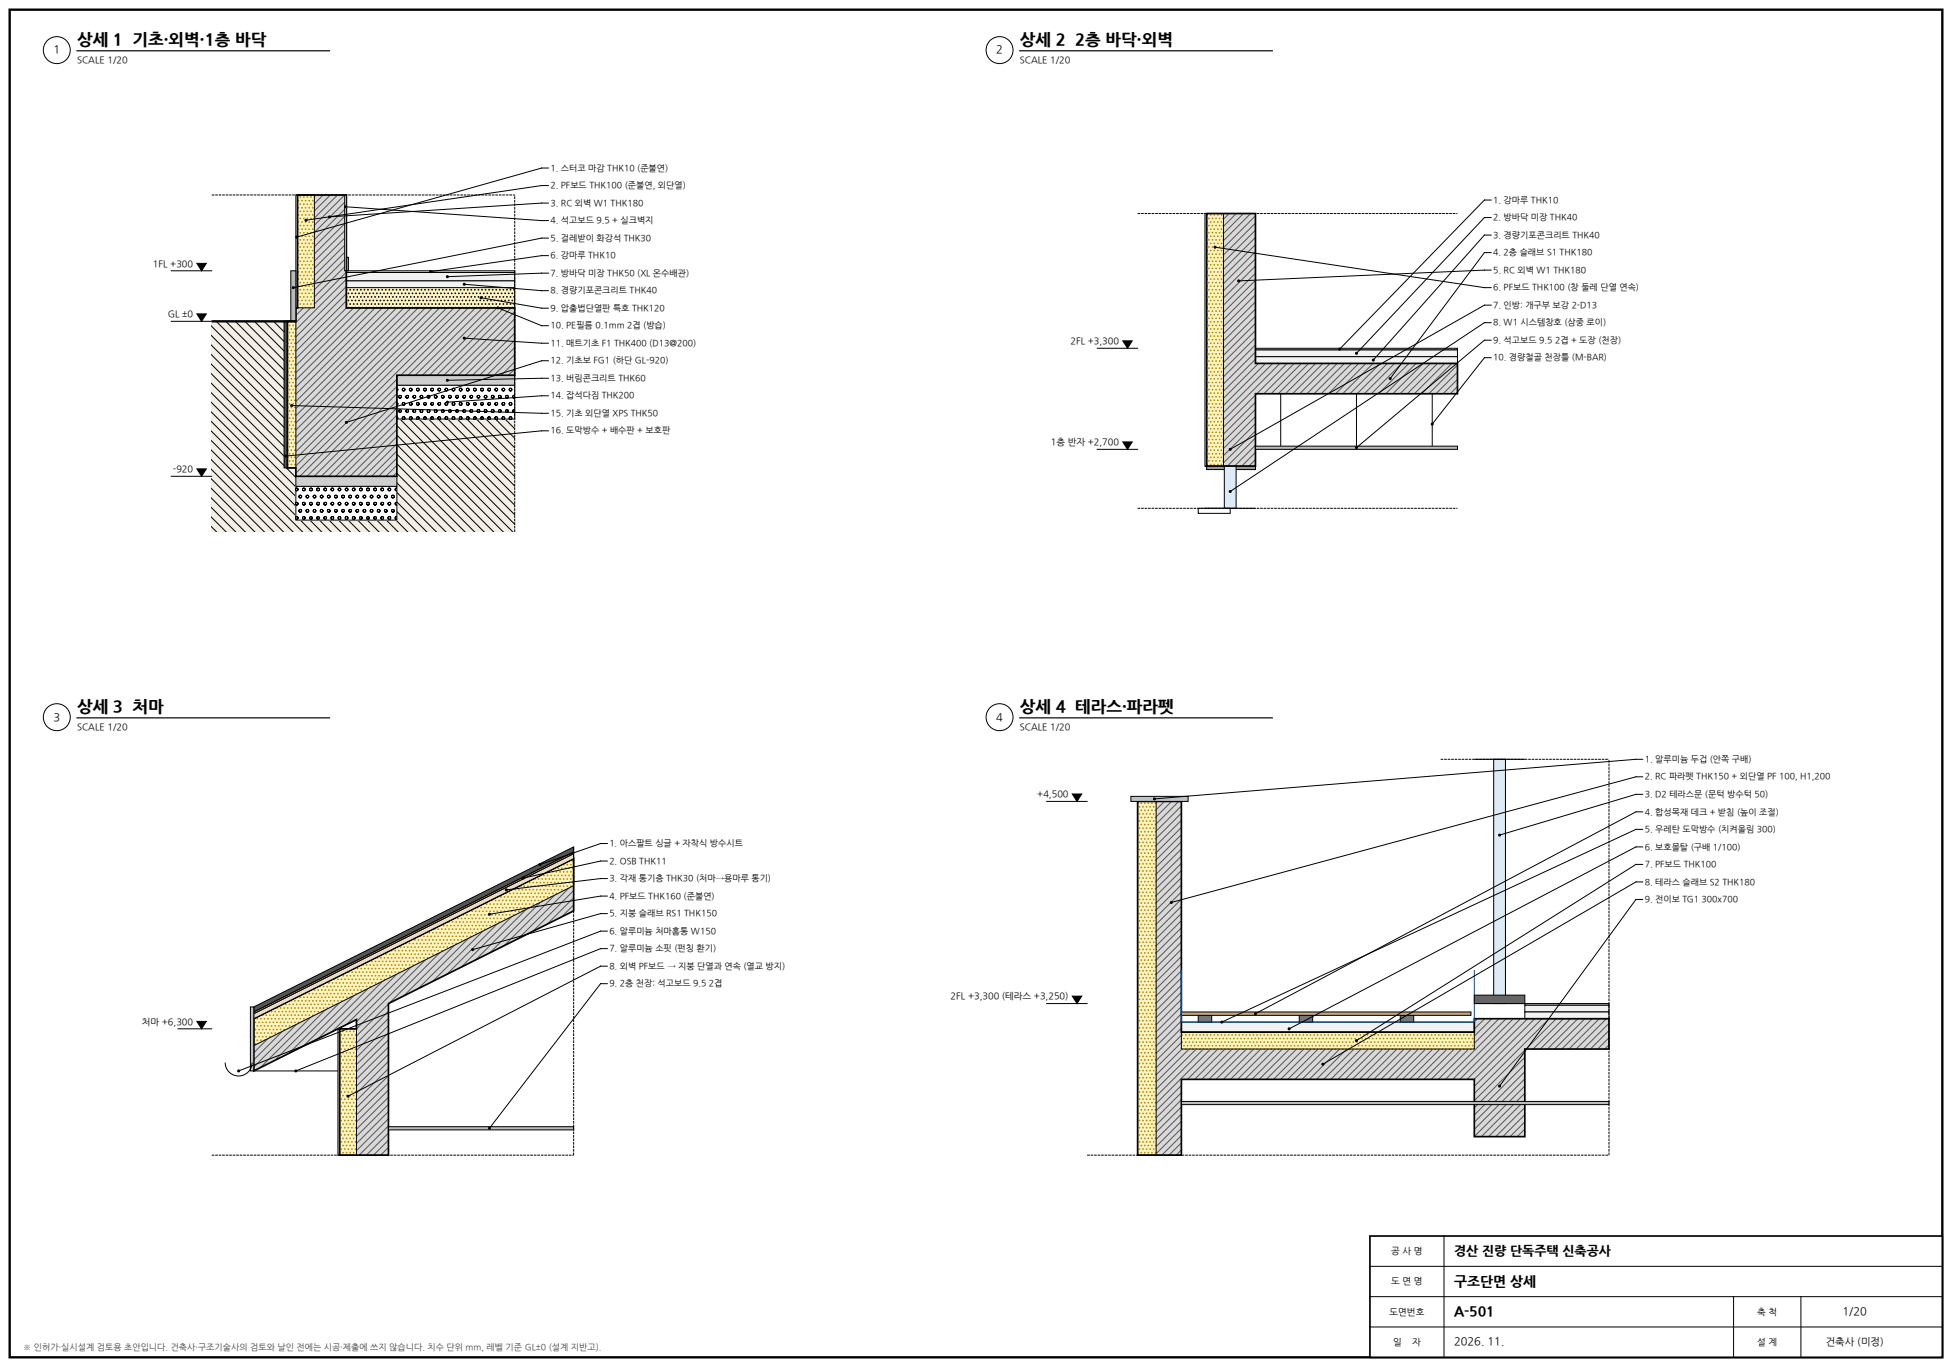
[picture p16: page 13]
3. RC 외벽 W1 THK180; 4. 석고보드 9.5 + 실크벽지; 5. 걸레받이 화강석 THK30; 6. 강마루 THK10; 8. 경량기포콘크리트 THK40; 9. 압출법단열판 특호 THK120; 10. PE필름 0.1mm 2겹 (방습); 11. 매트기초 F1 THK400 (D13@200); 13. 버림콘크리트 THK60; 14. 잡석다짐 THK200; 1. 강마루 THK10; 2. 방바닥 미장 THK40; 3. 경량기포콘크리트 THK40; 4. 2층 슬래브 S1 THK180; 5. RC 외벽 W1 THK180; 2. OSB THK11; 4. PF보드 THK160 (준불연); 5. 지붕 슬래브 RS1 THK150; 6. 알루미늄 처마홈통 W150; 9. 2층 천장: 석고보드 9.5 2겹; 2FL +3,300 (테라스 +3,250); 6. 보호몰탈 (구배 1/100); 7. PF보드 THK100; 8. 테라스 슬래브 S2 THK180; 9. 전이보 TG1 300x700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

1. 스터코 마감 THK10 (준불연)

2. PF보드 THK100 (준불연, 외단열)

7. 방바닥 미장 THK50 (XL 온수배관)

6. PF보드 THK100 (창 둘레 단열 연속)

7. 인방: 개구부 보강 2-D13

8. W1 시스템창호 (삼중 로이)

9. 석고보드 9.5 2겹 + 도장 (천장)

12. 기초보 FG1 (하단 GL-920)

10. 경량철골 천장틀 (M-BAR)

15. 기초 외단열 XPS THK50

16. 도막방수 + 배수판 + 보호판

1. 알루미늄 두겁 (안쪽 구배)

2. RC 파라펫 THK150 + 외단열 PF 100, H1,200

3. D2 테라스문 (문턱 방수턱 50)

4. 합성목재 데크 + 받침 (높이 조절)

5. 우레탄 도막방수 (치켜올림 300)

1. 아스팔트 싱글 + 자착식 방수시트

3. 각재 통기층 THK30 (처마→용마루 통기)

7. 알루미늄 소핏 (펀칭 환기)

8. 외벽 PF보드 → 지붕 단열과 연속 (열교 방지)

공 사 명 | 경산 진량 단독주택 신축공사
도 면 명 | 구조 일반사항·부재일람표
도면번호 | S-001 | 축 척 | NONE

# 구조 일반사항

1. 설계기준: 건축구조기준 (KDS 41), 콘크리트구조 설계기준 (KDS 14 20)
2. 재료: 콘크리트 fck = 24 MPa (기초·구조체), 철근 SD400 (D10~D22), 이음·정착은 KDS 14 20 52
3. 하중: 고정하중은 실제 구성으로 산정, 활하중 주거 2.0 kN/㎡, 지붕 1.0 kN/㎡ (KDS 41 10 15)
4. 적설·풍하중: 경산시 지역 기준값 적용 (KDS 41 12 00) — 구조계산서에서 확정
5. 내진: 2층 이상 건축물 → 구조안전 확인 대상 (건축법 시행령 제32조), 내진등급 II
6. 지반: 허용지내력 fe ≥ 150 kN/㎡ 가정 — 지반조사(평판재하시험) 후 기초 확정
7. 피복두께: 흙에 접하는 기초 75, 흙에 접하는 벽 50, 실내 슬래브·벽 20, 보 40
8. 개구부 보강: 벽·슬래브 개구부 둘레 2-D13, 모서리 사선보강 2-D13 (L=1,000)
9. 타설 순서: 매트기초 → 1층 벽 → 2층 슬래브·보 → 2층 벽 → 지붕, 이음은 전단력이 작은 곳
10. 본 도면의 부재 크기·배근은 예비 산정값이며, 구조계산서와 구조기술사 검토로 확정한다.

# 부재일람표

부호 | 부재 | 크기 | 배근 | 비고
F1 | 매트기초 | THK400 | 상·하단 D13@200 양방향 | 피복 상 50 / 하 75
FG1 | 외곽 기초보 | 600 x 1,000 (매트 포함) | 상 4-D19, 하 4-D19, 늑근 D10@200 | 동결심도 이하 GL-920
W1 | 외벽 (내력벽) | THK180 | 수직 D10@200, 수평 D10@250 복배근 | 개구부 보강 2-D13
S1 | 2층 바닥 슬래브 | THK180 | 단변 D10@200, 장변 D10@250 상·하단 | 2방향 슬래브
S2 | 테라스 슬래브 | THK180 (FL-450) | 단변 D10@200, 장변 D10@250 상·하단 | 단차 지지
RS1 | 지붕 슬래브 | THK150 (경사 5/10) | D10@200 양방향 상·하단 | 처마 캔틸레버 500
G1 | 큰보 (Y2열) | 300 x 500 | 상 3-D19, 하 4-D19, 늑근 D10@150 | 연속보
B1 | 작은보 (X3열) | 300 x 500 | 상 3-D16, 하 3-D19, 늑근 D10@150 | G1 교차
TG1 | 전이보 (X2열) | 300 x 700 | 상 4-D22, 하 5-D22, 늑근 D10@150 | 2층 외벽 지지
RB1 | 용마루보 | 300 x 400 | 상 3-D16, 하 3-D16, 늑근 D10@200 | 박공벽 지지

# 하중표 (kN/㎡, 추정)

부위 | 고정하중 | 활하중
지붕 (경사) | 5.4 | 1.0
2층 바닥 | 6.2 | 2.0
테라스 | 7.0 | 3.0
계단 | 6.5 | 3.0

※ 고정하중은 마감 구성으로 추정한 값이며 구조계산서에서 확정합니다.

1

# 기초 구조평면도

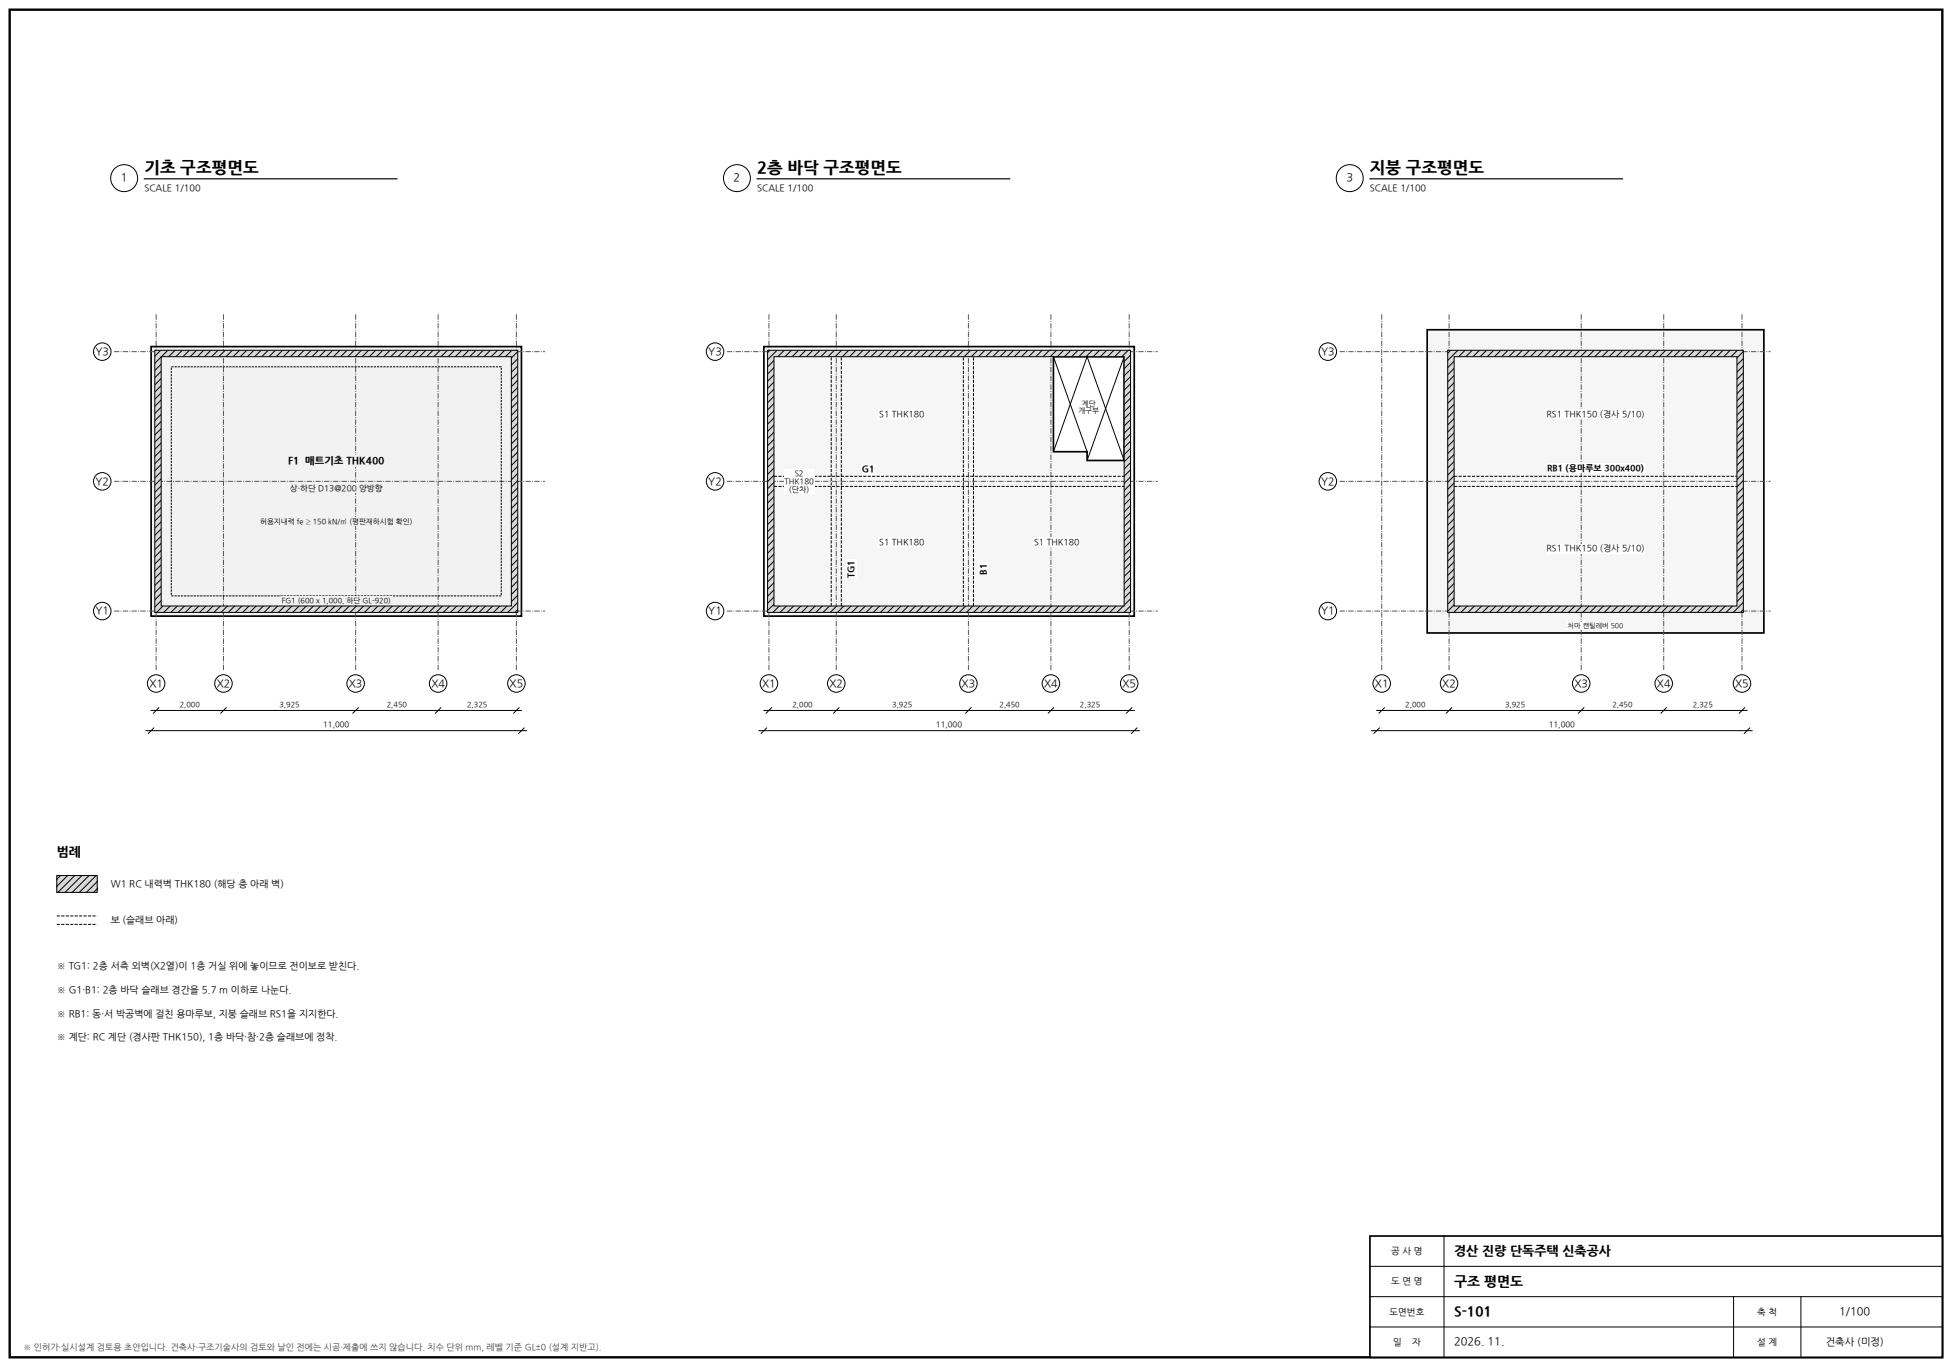
[picture p17: page 15]
F1 매트기초 THK400; 상·하단 D13@200 양방향; 계단 개구부; S1 THK180; S2 THK180 (단차); RB1 (용마루보 300x400); RS1 THK150 (경사 5/10); 처마 캔틸레버 500; 경산 진량 단독주택 신축공사; 구조 평면도; 도면번호; SCALE 1/100; 2층 바닥 구조평면도; 지붕 구조평면도; 보 (슬래브 아래)

허용지내력 fe ≥ 150 kN/㎡ (평판재하시험 확인)

W1 RC 내력벽 THK180 (해당 층 아래 벽)

※ TG1: 2층 서측 외벽(X2열)이 1층 거실 위에 놓이므로 전이보로 받친다.

※ G1·B1: 2층 바닥 슬래브 경간을 5.7 m 이하로 나눈다.

※ RB1: 동·서 박공벽에 걸친 용마루보, 지붕 슬래브 RS1을 지지한다.

※ 계단: RC 계단 (경사판 THK150), 1층 바닥·참·2층 슬래브에 정착.
