wpdnr3723-a11y/WORKMODE/house/images/floor2.png

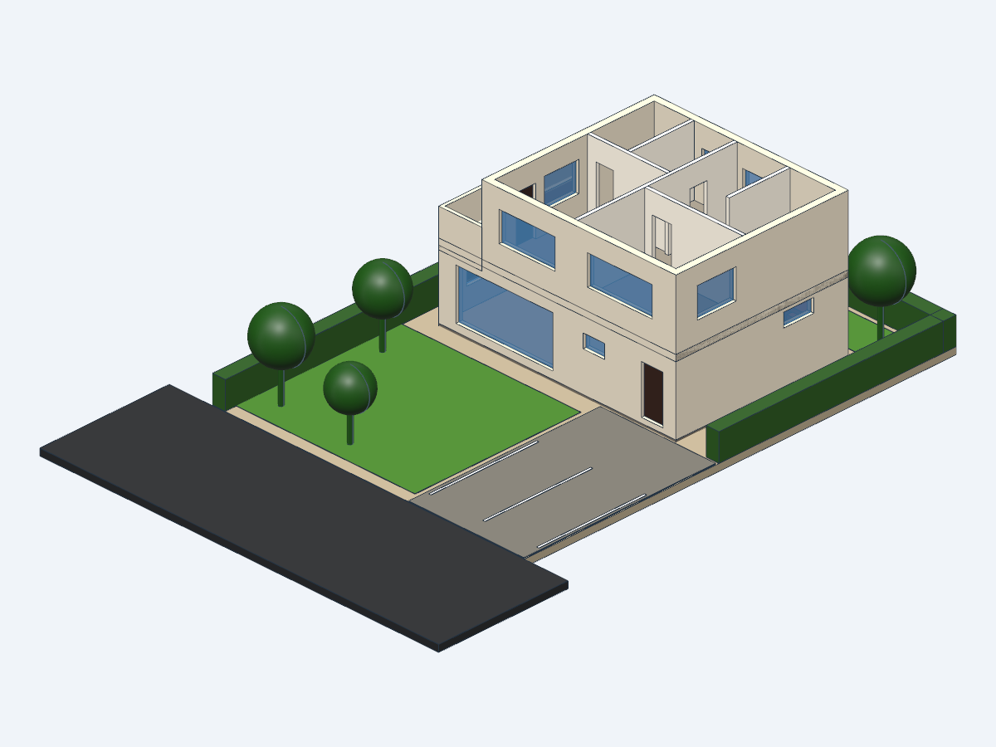
house/images/floor2.png
