wpdnr3723-a11y/WORKMODE/house/images/site_plan.png

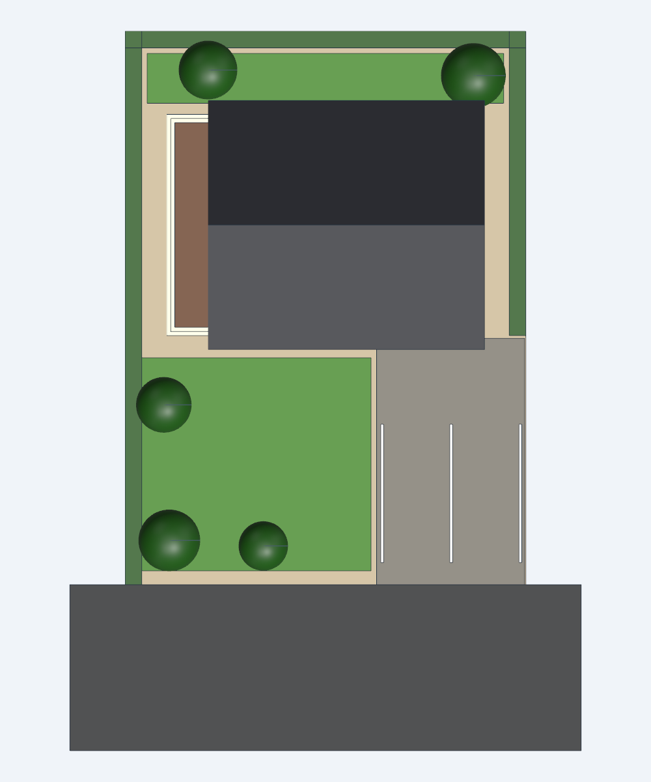
house/images/site_plan.png
