wpdnr3723-a11y/WORKMODE/house/exports/house.step

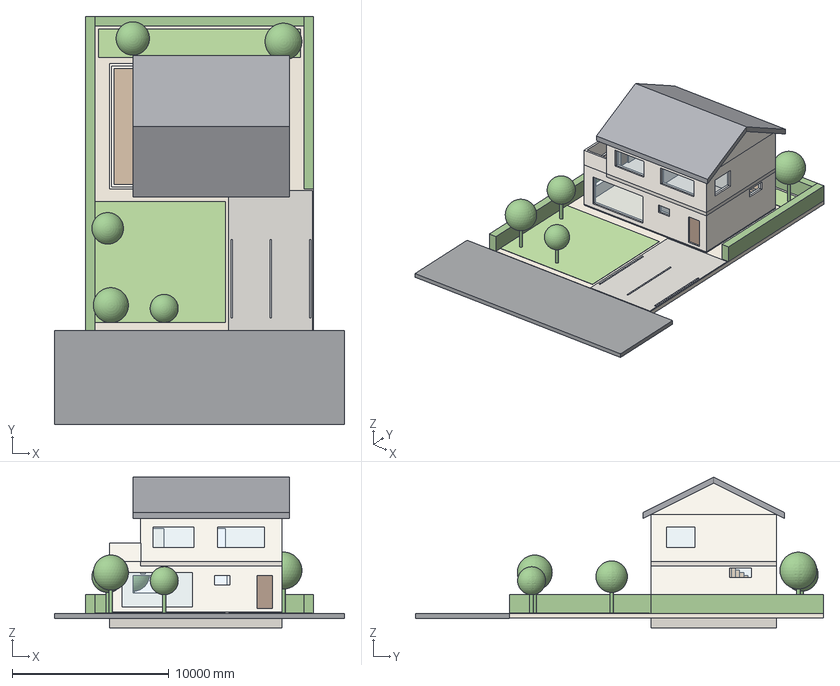
[picture p20: CAD file, 2026-11-11]
house/exports/house.step
18500.0 x 26000.0 x 9600.0 mm
lot_290m2
road_6m
garden
north_garden
parking_pave
foundation_F1_FG1
floor_1f_buildup
slab_S1
slab_S2_terrace
terrace_deck
walls_1f
walls_2f
terrace_parapet_1200
