wpdnr3723-a11y/WORKMODE/house/drawings/house_drawings_A3.pdf

도면 목록 | PROJECT TITLE 경산 진량 대구 침산동 단독주택 현대미술관 신축공사 신축계획안
번호 | 도면명 | 축척

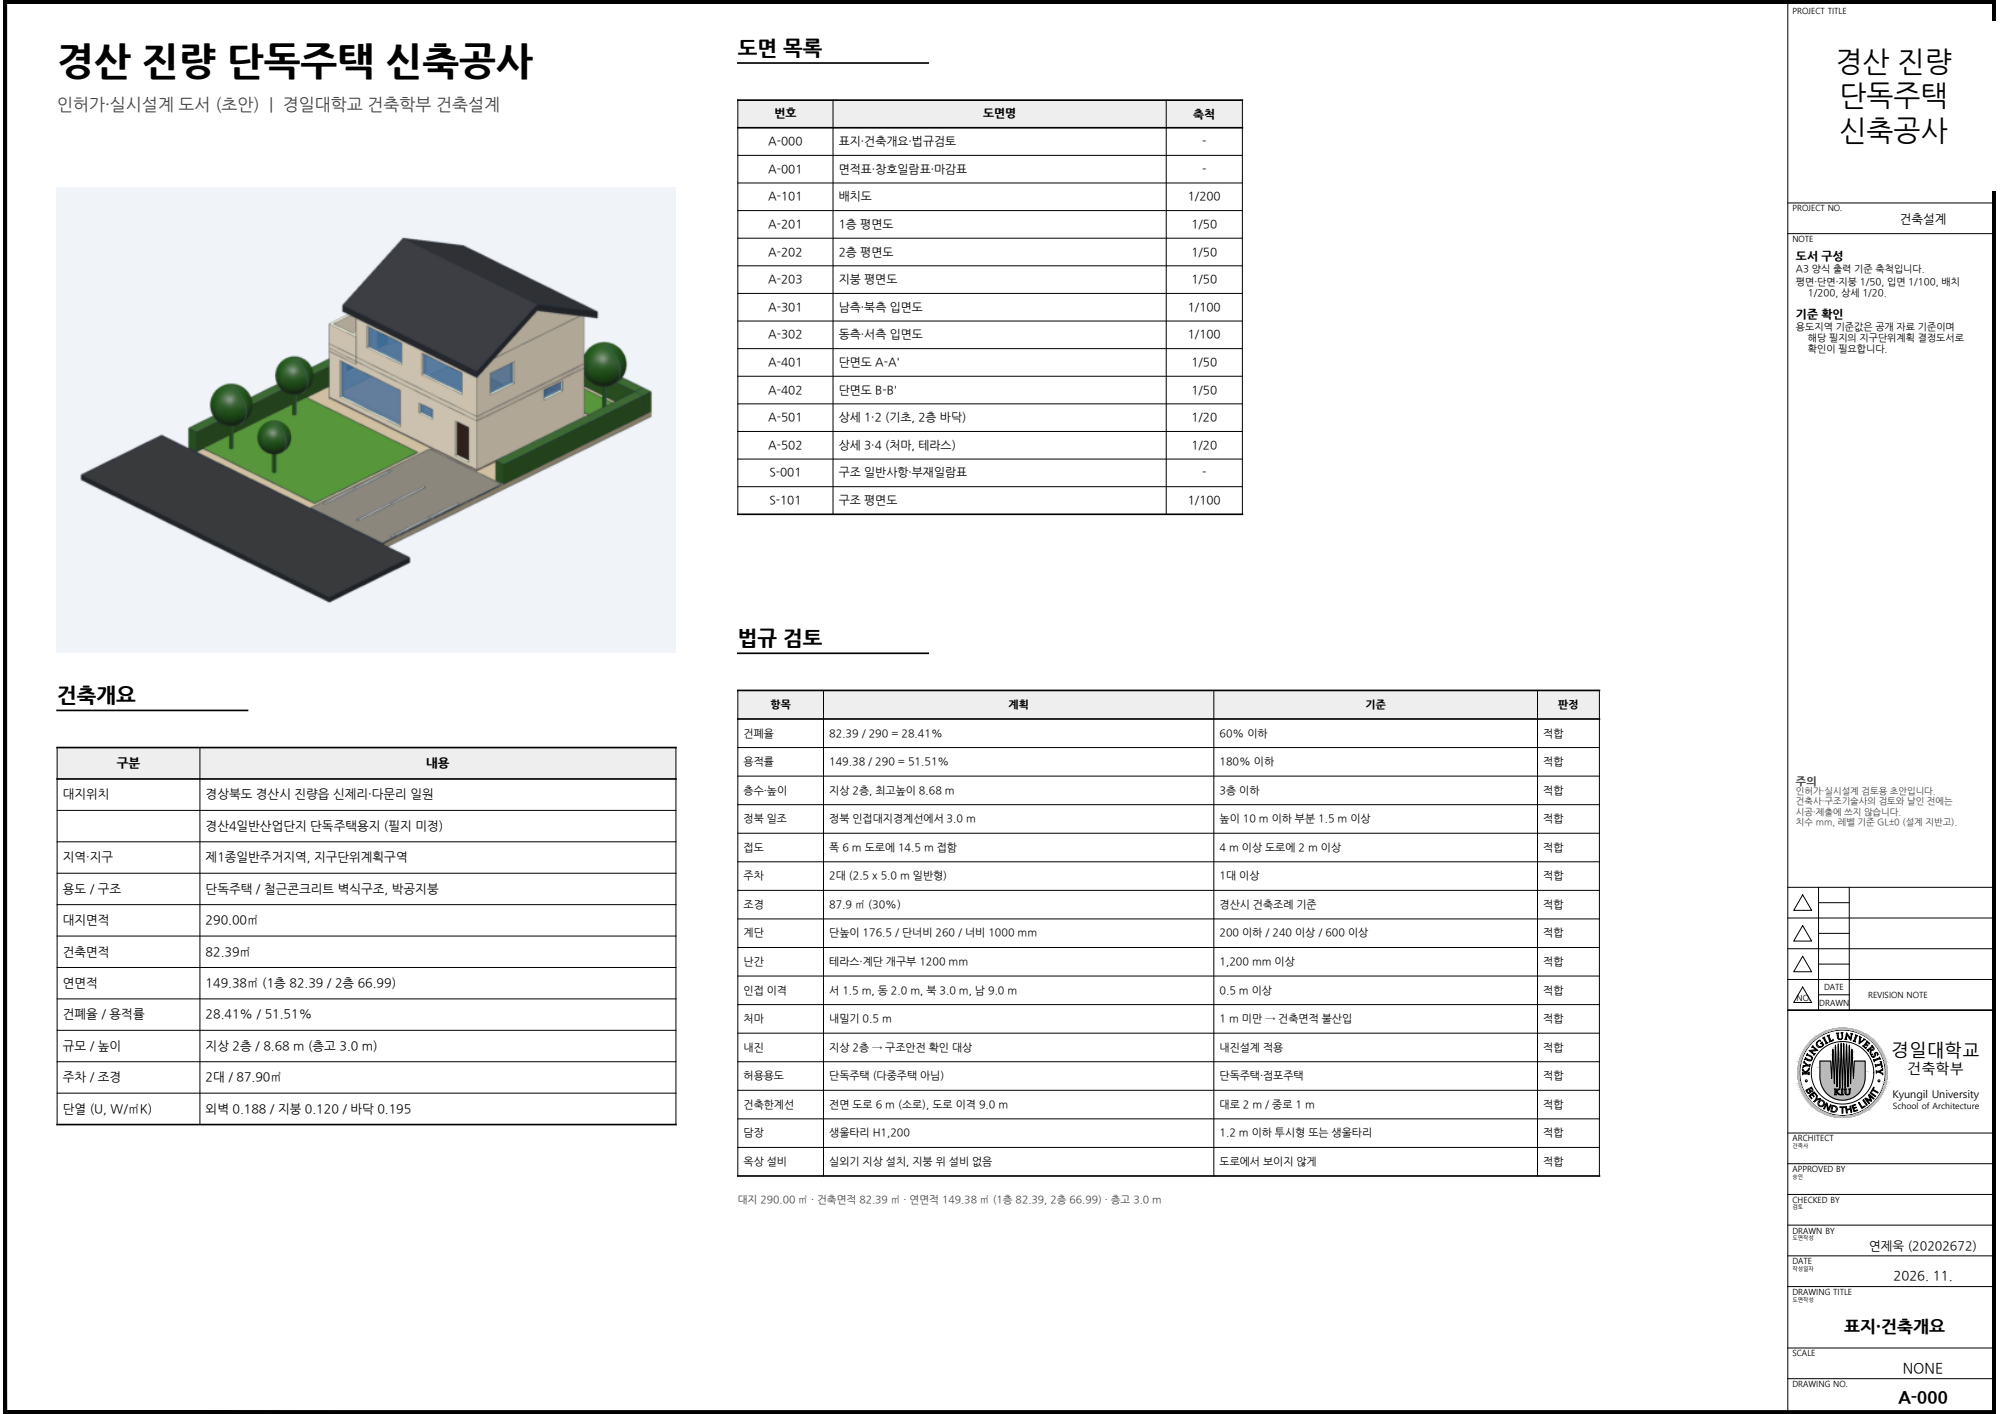
[picture p21: page 1]
ARCHITECT; DATE DRAWN; REVISION NOTE; 경일대학교; 작성일자; 도면작성; 건축사; 건축학부; Kyungil University; 건축설계; 연제욱 (20202672); 표지·건축개요; NONE A-000; 건축개요; 대지위치; 경상북도 경산시 진량읍 신제리·다문리 일원; 용적률; 지상 2층, 최고높이 8.68 m; 지상 2층 → 구조안전 확인 대상; 내진설계 적용; 허용용도; 단독주택 (다중주택 아님); 단독주택·점포주택; 건축한계선

경산 진량 단독주택 신축공사

인허가·실시설계 도서 (초안) | 경일대학교 건축학부 건축설계

A-000 | 표지·건축개요·법규검토 | -

A-001 | 면적표·창호일람표·마감표 | -

A-101 | 배치도 | 1/200

NOTE PROJECT NO.

A-201 | 1층 평면도 | 1/50

A-202 | 2층 평면도 | 1/50

A3 양식 출력 기준 축척입니다.
용도지역 기준값은 공개 자료 기준이며
해당 필지의 지구단위계획 결정도서로
확인이 필요합니다.

A-203 | 지붕 평면도 | 1/50

A-301 | 남측·북측 입면도 | 1/100

A-302 | 동측·서측 입면도 | 1/100

A-401 | 단면도 A-A' | 1/50

A-402 | 단면도 B-B' | 1/50

A-502 | 상세 3·4 (처마, 테라스) | 1/20

S-001 | 구조 일반사항·부재일람표 | -

S-101 | 구조 평면도 | 1/100

건폐율 | 82.39 / 290 = 28.41% | 60% 이하 | 적합

인허가·실시설계 검토용 초안입니다.
건축사·구조기술사의 검토와 날인 전에는
시공·제출에 쓰지 않습니다.
치수 mm, 레벨 기준 GL±0 (설계 지반고).

경산4일반산업단지 단독주택용지 (필지 미정)

정북 일조 | 정북 인접대지경계선에서 3.0 m | 높이 10 m 이하 부분 1.5 m 이상 | 적합

지역·지구 | 제1종일반주거지역, 지구단위계획구역

접도 | 폭 6 m 도로에 14.5 m 접함 | 4 m 이상 도로에 2 m 이상 | 적합

주차 | 2대 (2.5 x 5.0 m 일반형) | 1대 이상 | 적합

용도 / 구조 | 단독주택 / 철근콘크리트 벽식구조, 박공지붕

조경 | 87.9 ㎡ (30%) | 경산시 건축조례 기준 | 적합

대지면적 | 290.00㎡

계단 | 단높이 176.5 / 단너비 260 / 너비 1000 mm | 200 이하 / 240 이상 / 600 이상 | 적합

건축면적 | 82.39㎡

난간 | 테라스·계단 개구부 1200 mm | 1,200 mm 이상 | 적합

연면적 | 149.38㎡ (1층 82.39 / 2층 66.99)

건폐율 / 용적률 | 28.41% / 51.51%

처마 | 내밀기 0.5 m | 1 m 미만 → 건축면적 불산입 | 적합

DRAWN BY DRAWING TITLE DATE APPROVED BY CHECKED BY

School of Architecture 도면작성

담장 | 생울타리 H1,200 | 1.2 m 이하 투시형 또는 생울타리 | 적합

옥상 설비 | 실외기 지상 설치, 지붕 위 설비 없음 | 도로에서 보이지 않게 | 적합

대지 290.00 ㎡ · 건축면적 82.39 ㎡ · 연면적 149.38 ㎡ (1층 82.39, 2층 66.99) · 층고 3.0 m

DRAWING NO. SCALE

# 신축계획안

# 신축공사

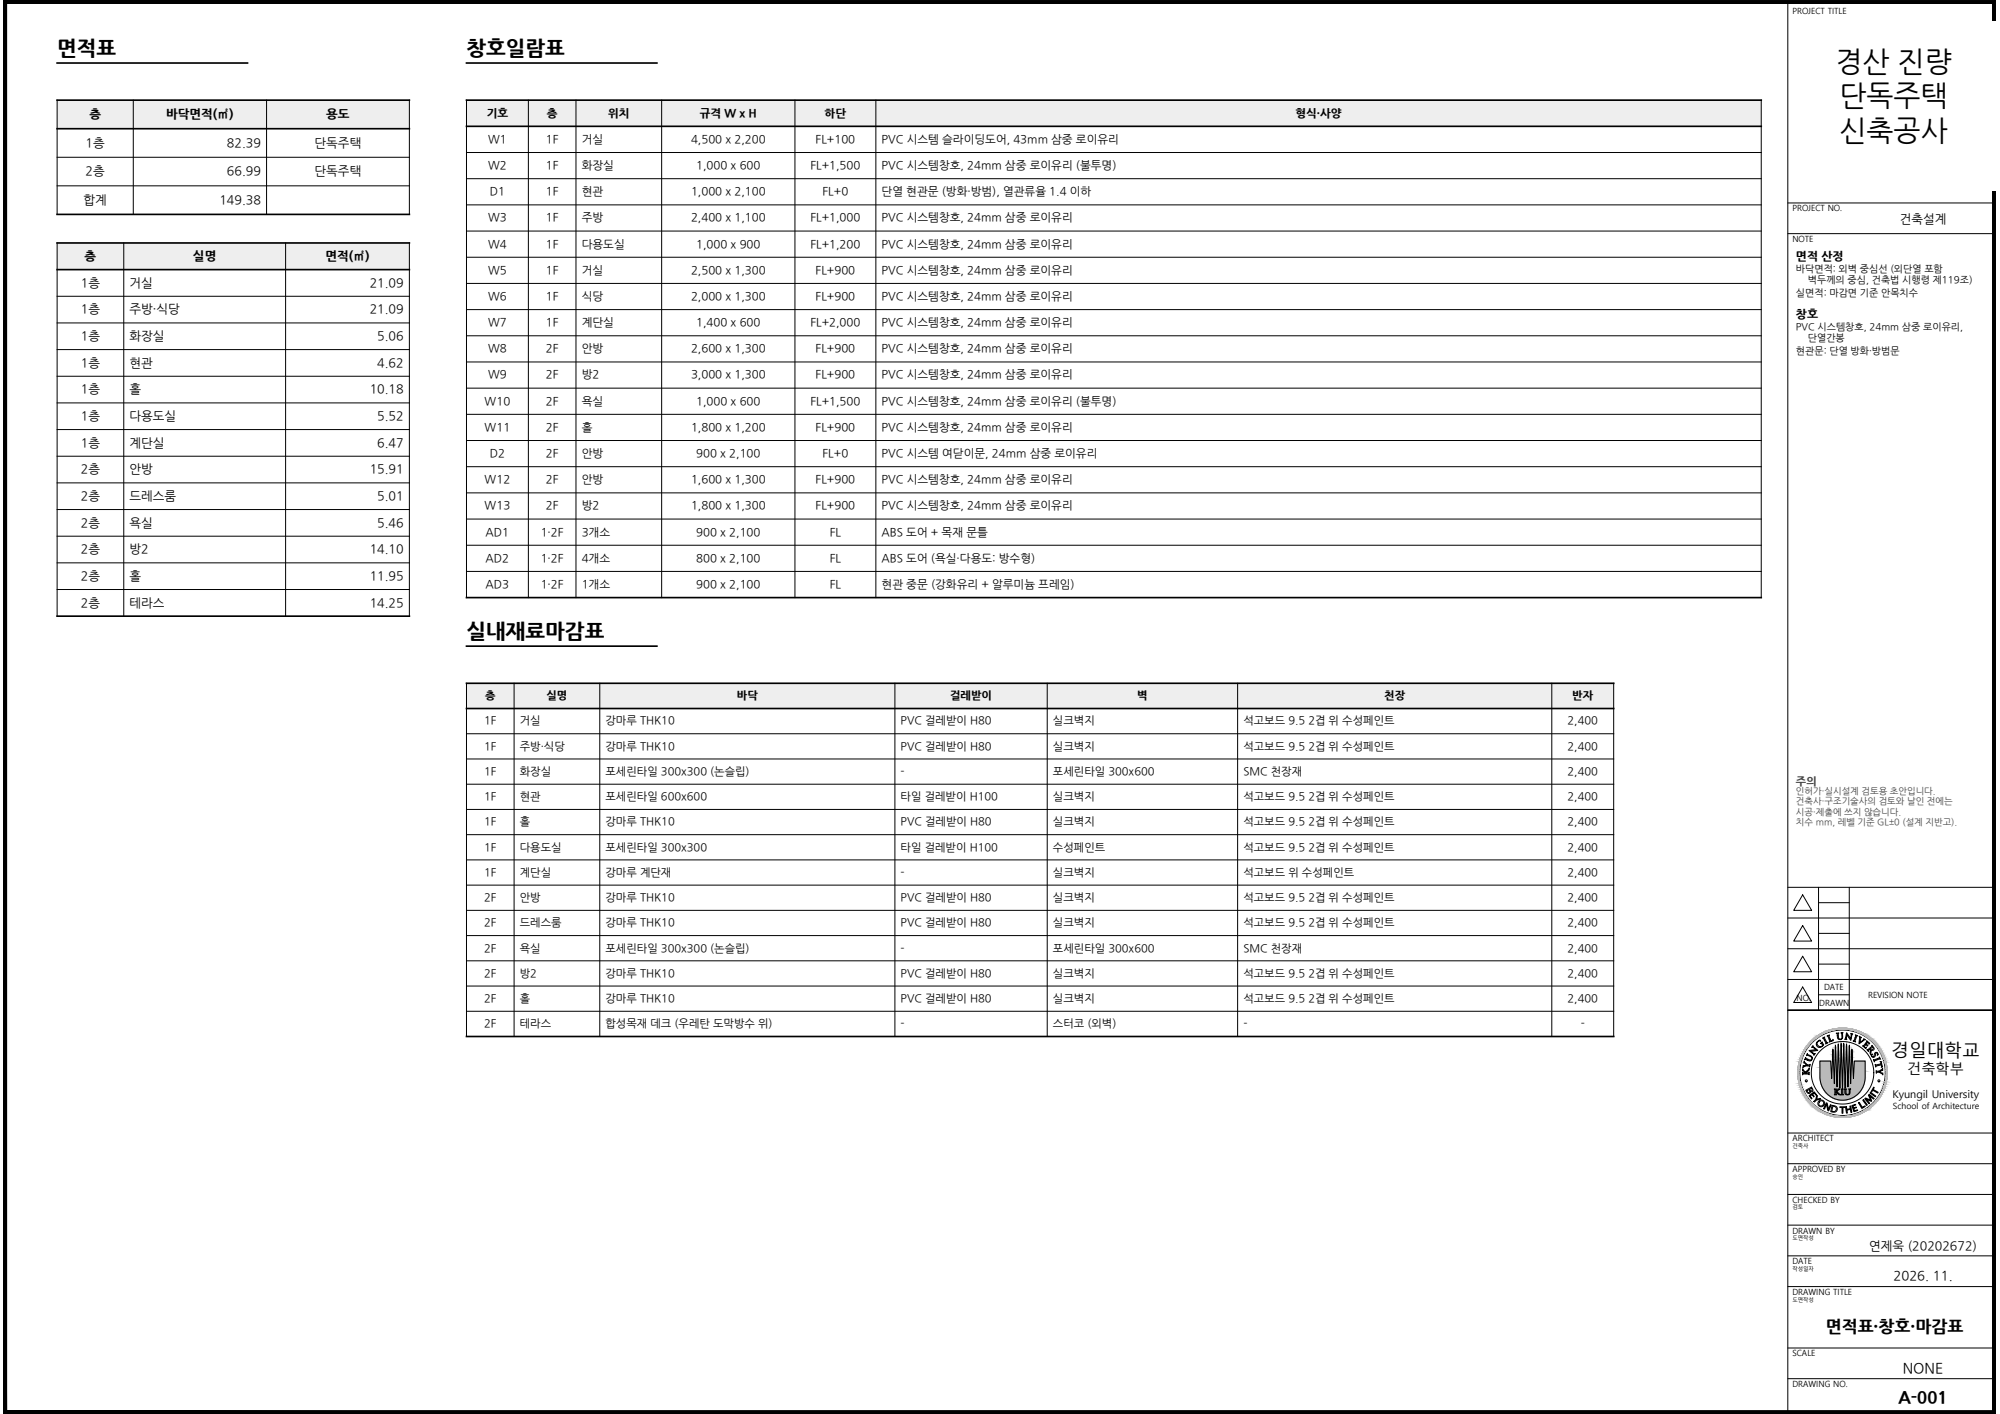
[picture p22: page 2]
ARCHITECT; 경일대학교; 작성일자; 건축사; 건축학부; Kyungil University; 건축설계; 연제욱 (20202672); NONE A-001; 면적표; 바닥면적(㎡); 단독주택; 창호일람표; PVC 시스템 슬라이딩도어, 43mm 삼중 로이유리; PVC 시스템창호, 24mm 삼중 로이유리; 실내재료마감표; 테라스; 합성목재 데크 (우레탄 도막방수 위); 스터코 (외벽)

2층 | 66.99 | 단독주택

W2 | 1F | 화장실 | 1,000 x 600 | FL+1,500 | PVC 시스템창호, 24mm 삼중 로이유리 (불투명)

D1 | 1F | 현관 | 1,000 x 2,100 | FL+0 | 단열 현관문 (방화·방범), 열관류율 1.4 이하

NOTE PROJECT NO.

W4 | 1F | 다용도실 | 1,000 x 900 | FL+1,200 | PVC 시스템창호, 24mm 삼중 로이유리

바닥면적: 외벽 중심선 (외단열 포함
벽두께의 중심, 건축법 시행령 제119조)
실면적: 마감면 기준 안목치수
PVC 시스템창호, 24mm 삼중 로이유리,
단열간봉
현관문: 단열 방화·방범문

W5 | 1F | 거실 | 2,500 x 1,300 | FL+900 | PVC 시스템창호, 24mm 삼중 로이유리

W6 | 1F | 식당 | 2,000 x 1,300 | FL+900 | PVC 시스템창호, 24mm 삼중 로이유리

W7 | 1F | 계단실 | 1,400 x 600 | FL+2,000 | PVC 시스템창호, 24mm 삼중 로이유리

1층 | 화장실 | 5.06

W8 | 2F | 안방 | 2,600 x 1,300 | FL+900 | PVC 시스템창호, 24mm 삼중 로이유리

W9 | 2F | 방2 | 3,000 x 1,300 | FL+900 | PVC 시스템창호, 24mm 삼중 로이유리

W10 | 2F | 욕실 | 1,000 x 600 | FL+1,500 | PVC 시스템창호, 24mm 삼중 로이유리 (불투명)

1층 | 다용도실 | 5.52

W11 | 2F | 홀 | 1,800 x 1,200 | FL+900 | PVC 시스템창호, 24mm 삼중 로이유리

1층 | 계단실 | 6.47

D2 | 2F | 안방 | 900 x 2,100 | FL+0 | PVC 시스템 여닫이문, 24mm 삼중 로이유리

W12 | 2F | 안방 | 1,600 x 1,300 | FL+900 | PVC 시스템창호, 24mm 삼중 로이유리

2층 | 드레스룸 | 5.01

W13 | 2F | 방2 | 1,800 x 1,300 | FL+900 | PVC 시스템창호, 24mm 삼중 로이유리

AD1 | 1·2F | 3개소 | 900 x 2,100 | FL | ABS 도어 + 목재 문틀

AD2 | 1·2F | 4개소 | 800 x 2,100 | FL | ABS 도어 (욕실·다용도: 방수형)

AD3 | 1·2F | 1개소 | 900 x 2,100 | FL | 현관 중문 (강화유리 + 알루미늄 프레임)

2층 | 테라스 | 14.25

층 | 실명 | 바닥 | 걸레받이 | 벽 | 천장 | 반자

1F | 거실 | 강마루 THK10 | PVC 걸레받이 H80 | 실크벽지 | 석고보드 9.5 2겹 위 수성페인트 | 2,400

1F | 주방·식당 | 강마루 THK10 | PVC 걸레받이 H80 | 실크벽지 | 석고보드 9.5 2겹 위 수성페인트 | 2,400

1F | 화장실 | 포세린타일 300x300 (논슬립) | - | 포세린타일 300x600 | SMC 천장재 | 2,400

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

1F | 현관 | 포세린타일 600x600 | 타일 걸레받이 H100 | 실크벽지 | 석고보드 9.5 2겹 위 수성페인트 | 2,400

1F | 홀 | 강마루 THK10 | PVC 걸레받이 H80 | 실크벽지 | 석고보드 9.5 2겹 위 수성페인트 | 2,400

1F | 다용도실 | 포세린타일 300x300 | 타일 걸레받이 H100 | 수성페인트 | 석고보드 9.5 2겹 위 수성페인트 | 2,400

1F | 계단실 | 강마루 계단재 | - | 실크벽지 | 석고보드 위 수성페인트 | 2,400

2F | 안방 | 강마루 THK10 | PVC 걸레받이 H80 | 실크벽지 | 석고보드 9.5 2겹 위 수성페인트 | 2,400

2F | 드레스룸 | 강마루 THK10 | PVC 걸레받이 H80 | 실크벽지 | 석고보드 9.5 2겹 위 수성페인트 | 2,400

2F | 욕실 | 포세린타일 300x300 (논슬립) | - | 포세린타일 300x600 | SMC 천장재 | 2,400

2F | 방2 | 강마루 THK10 | PVC 걸레받이 H80 | 실크벽지 | 석고보드 9.5 2겹 위 수성페인트 | 2,400

NO. | DATE DRAWN | REVISION NOTE

2F | 홀 | 강마루 THK10 | PVC 걸레받이 H80 | 실크벽지 | 석고보드 9.5 2겹 위 수성페인트 | 2,400

DRAWN BY DRAWING TITLE DATE APPROVED BY CHECKED BY

School of Architecture 도면작성

면적표·창호·마감표

# 신축공사 신축계획안

### 건축설계

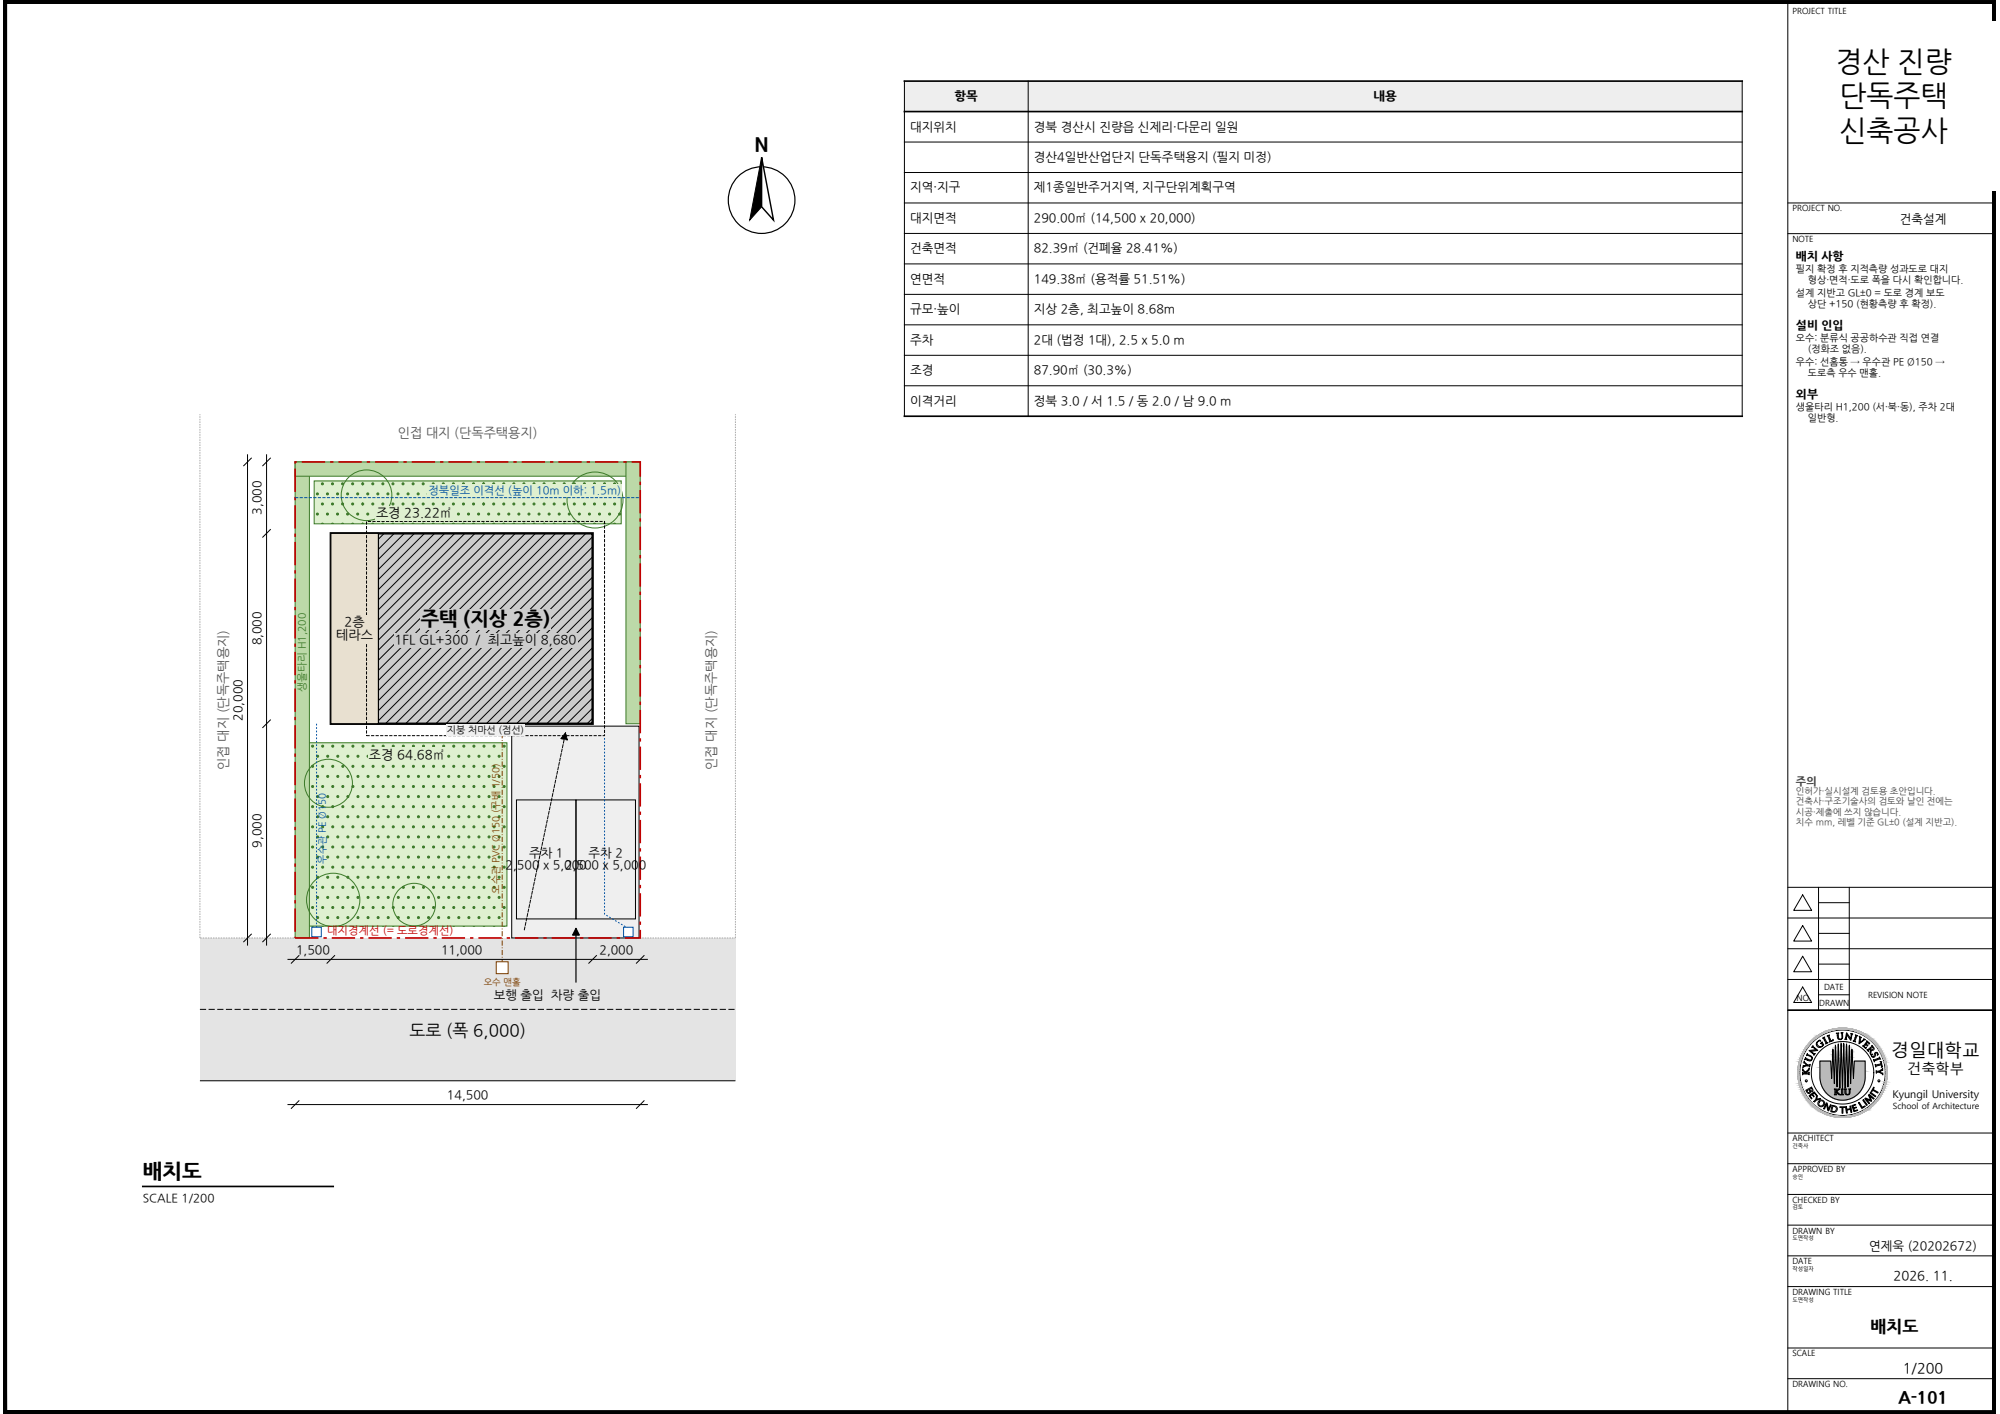
[picture p23: page 3]
ARCHITECT; DATE DRAWN; REVISION NOTE; 경일대학교; 작성일자; 건축사; 건축학부; Kyungil University; 1FL GL+300 / 최고높이 8,680; 층 테라스; 대지경계선 (= 도로경계선; 우수관 PE Ø150; 생울타리 H1,200; 연제욱 (20202672); 배치도; SCALE 1/200; 대지면적; → 우수관 PE Ø150

대지위치 | 경북 경산시 진량읍 신제리 ·다문리 일원

경산 4일반산업단지 단독주택용지 (필지 미정 )

지역 ·지구 | 제 1종일반주거지역, 지구단위계획구역

NOTE PROJECT NO.

건축면적 | 82.39 ㎡ (건폐율 28.41%)

설계 지반고 GL±0 = 도로 경계 보도
상단 +150 (현황측량
오수: 분류식 공공하수관 직접 연결 (정화조 없음).

연면적 | 149.38 ㎡ (용적률 51.51%)

후 지적측량 성과도로 대지
·도로 폭을 다시 확인합니다.

규모 ·높이 | 지상 2 층, 최고높이 8.68m

우수: 선홈통
도로측 우수 맨홀.
생울타리 H1,200 (
일반형.

이격거리 | 정북 3.0 / 서 1.5 / 동 2.0 / 남 9.0 m

인접 대지 (단독주택용지

정북일조 이격선 (높이 10m 이하: 1.5m)

보행 출입 차량 출입 오수관 PVC Ø¹⁵⁰ ⁽구배 ¹/50⁾

인접 대지 (단독주택용지)

지붕 처마선 (점선

인허가
·구조기술사의 검토와 날인 전에는
건축사
치수 mm, 레벨 기준 GL±0 (설계 지반고).

·실시설계 검토용 초안입니다.

·제출에 쓰지 않습니다.

DRAWN BY DRAWING TITLE DATE APPROVED BY CHECKED BY

School of Architecture 도면작성

# 신축계획안

1,500 | 2,400 | 2,800 | 1,000 | 3,300

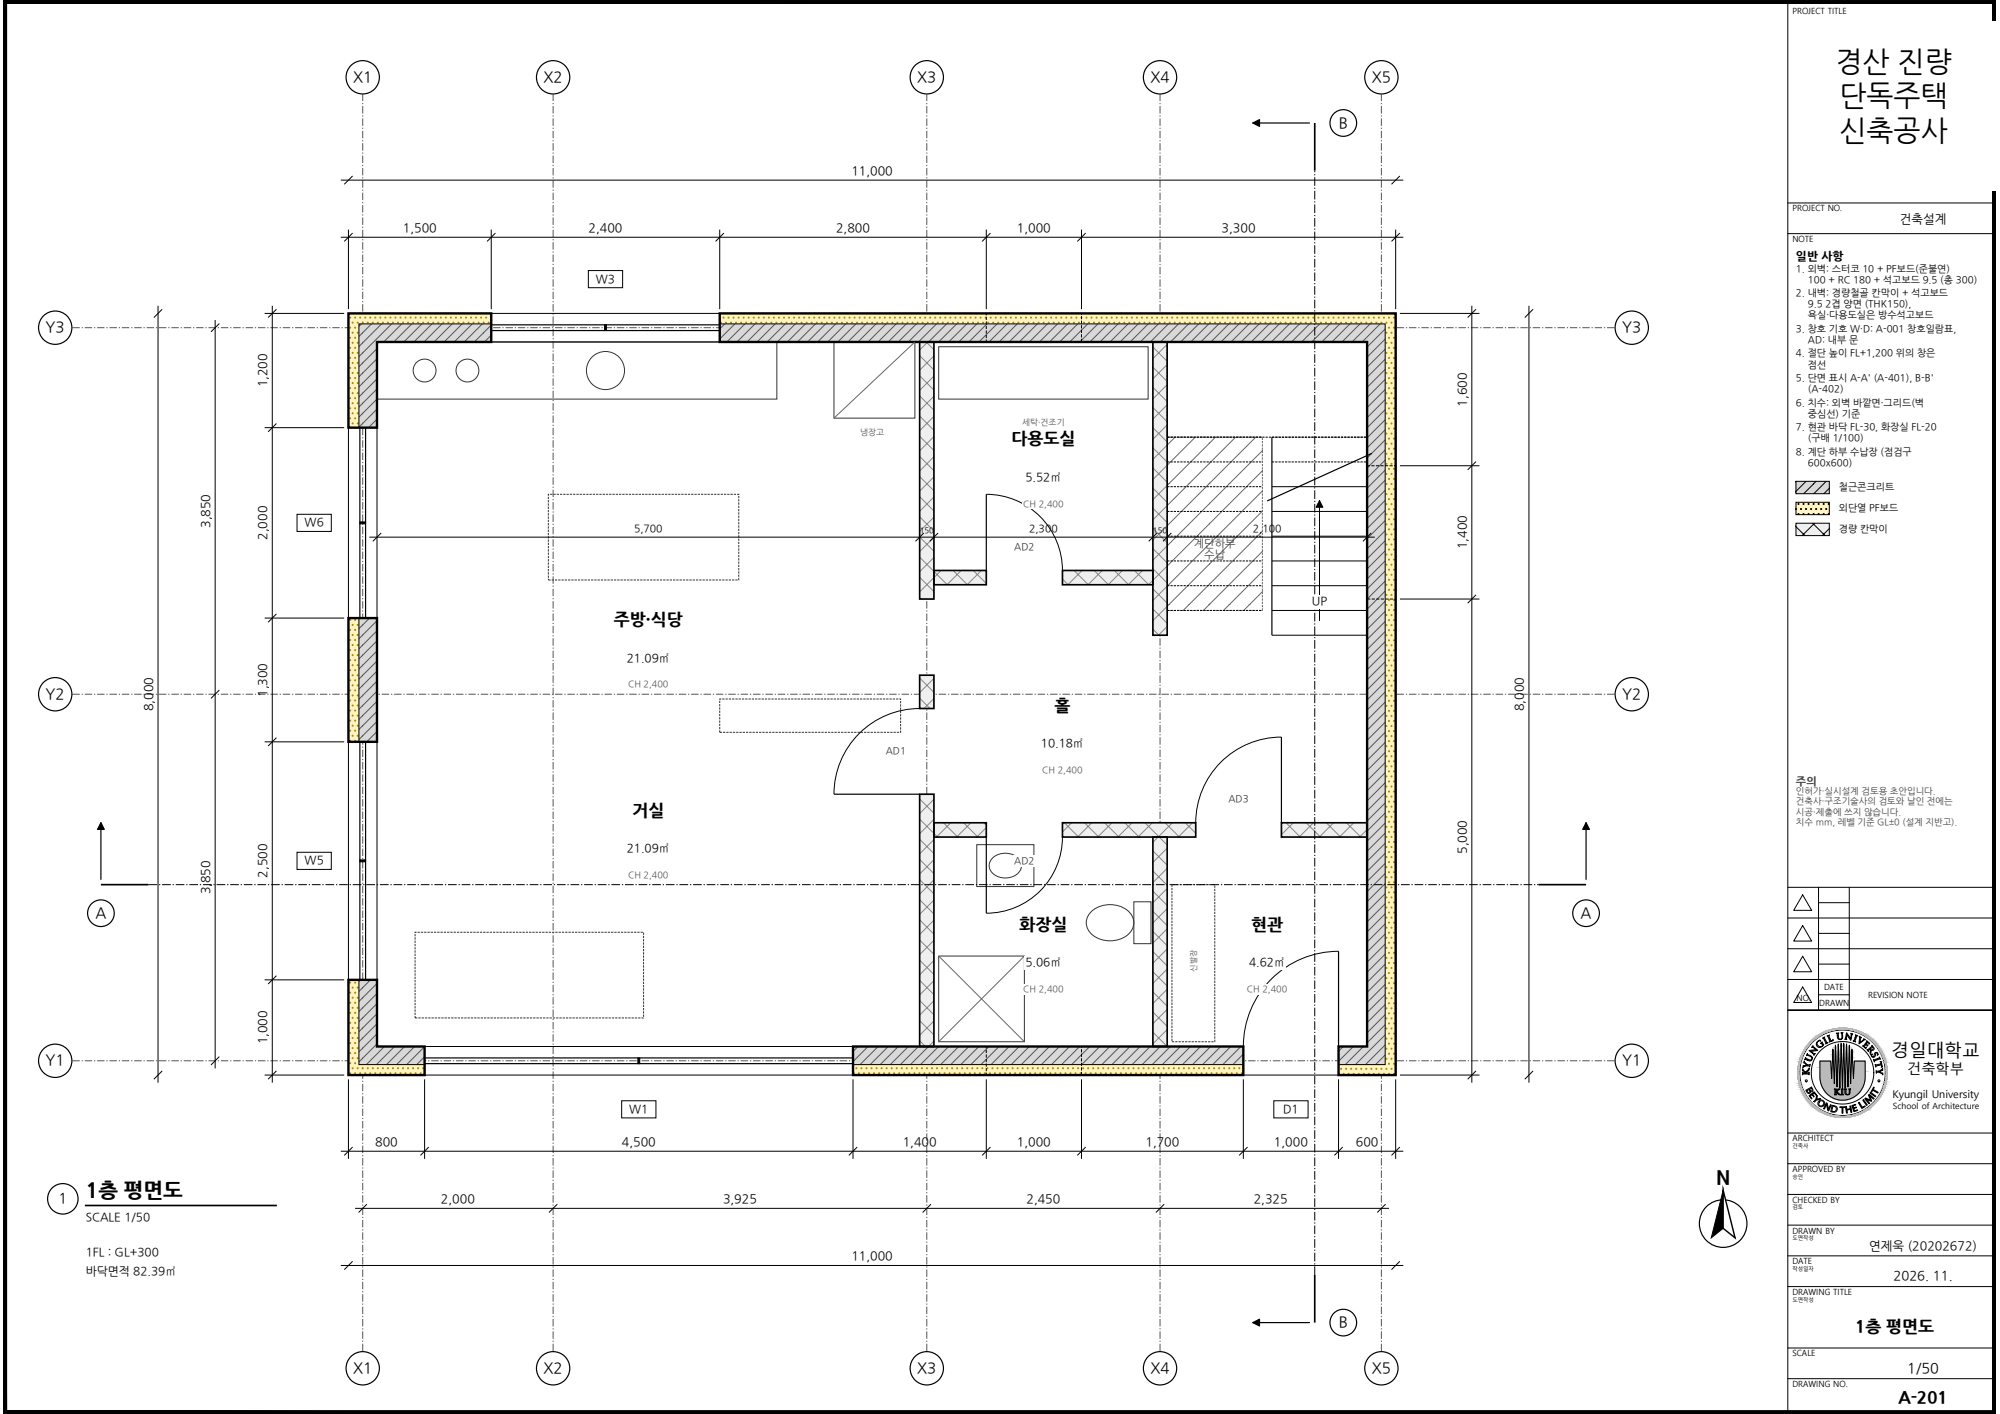
[picture p24: page 4]
ARCHITECT; DATE DRAWN; REVISION NOTE; 경일대학교; 작성일자; 건축사; 건축학부; Kyungil University; 계단하부; 냉장고; ·건조기; 신발장; 화장실; 다용도실; 신축공사; 건축설계; 연제욱 (20202672); 층 평면도; 1층 평면도; SCALE 1/50; 바닥면적 82.39; (준불연; 겹 양면 (THK150), ·다용도실은 방수석고보드; ·그리드; 철근콘크리트; 외단열 PF보드; 경량 칸막이

NOTE PROJECT NO.

1. 외벽: 스터코 10 + PF보드
100 + RC 180 + 석고보드 9.5 (
2. 내벽: 경량철골 칸막이 + 석고보드
3. 창호 기호 W·D: A-001 창호일람표
6. 치수: 외벽 바깥면
중심선) 기준
7. 현관 바닥 FL-30, 화장실 FL-20 (구배 1/100)

8. 계단 하부 수납장 (점검구

인허가
·구조기술사의 검토와 날인 전에는
건축사
치수 mm, 레벨 기준 GL±0 (설계 지반고).

·실시설계 검토용 초안입니다.

·제출에 쓰지 않습니다.

DRAWN BY DRAWING TITLE DATE APPROVED BY CHECKED BY

School of Architecture 도면작성

# 신축계획안

2,000 | 2,500 | 1,000 | 900 | 1,800 | 2,800

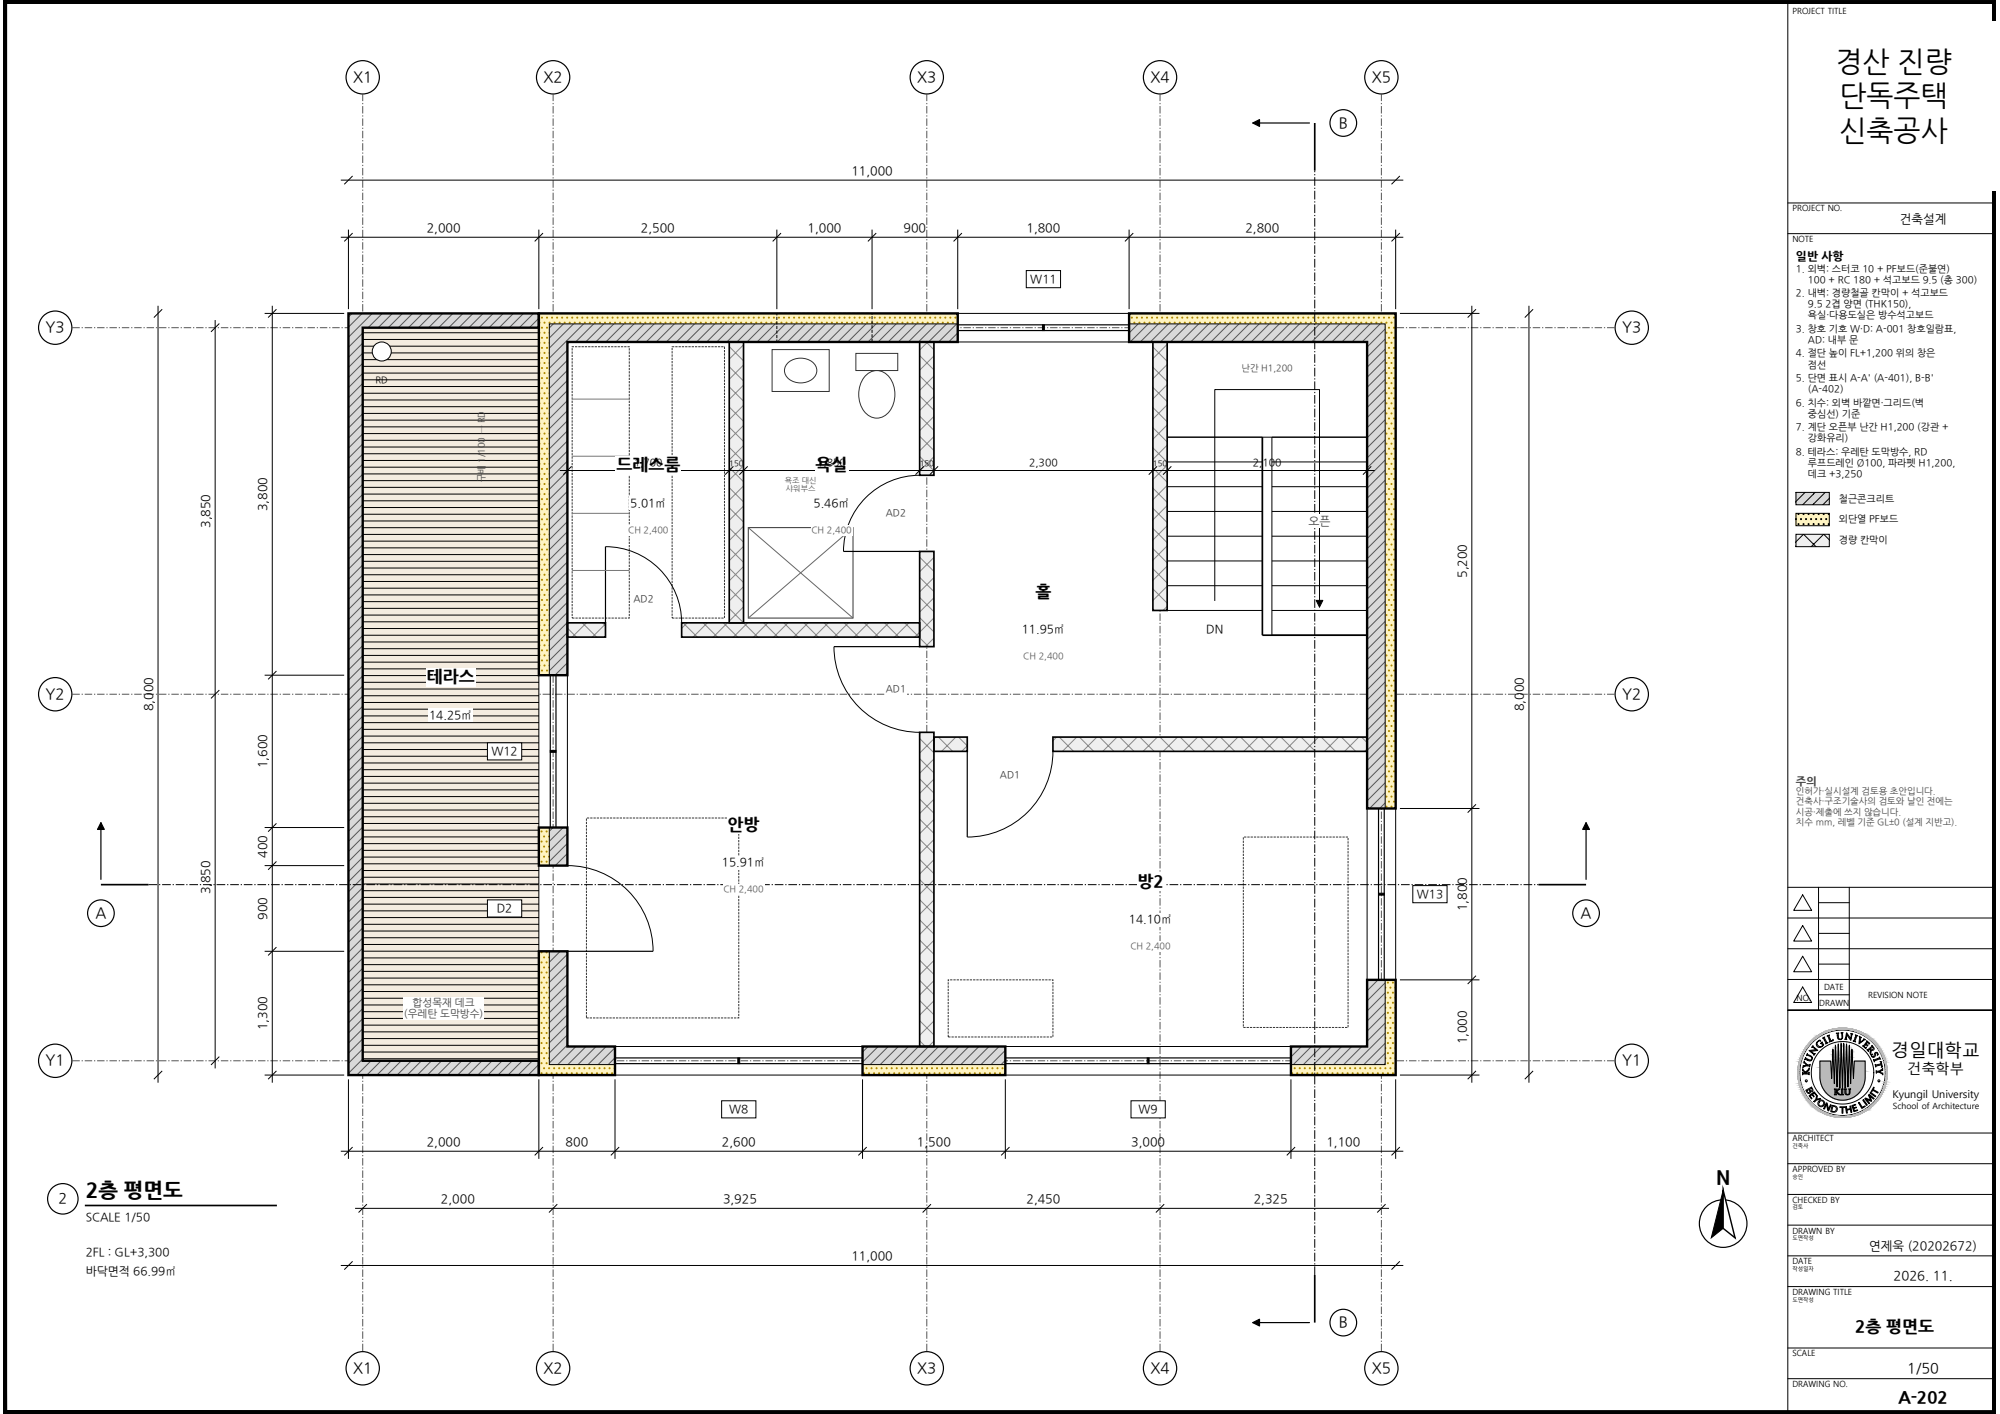
[picture p25: page 5]
ARCHITECT; DATE DRAWN; REVISION NOTE; 경일대학교; 작성일자; 건축사; 건축학부; Kyungil University; 합성목재 데크 (우레탄 도막방수; 욕조 대신 샤워부스; 드레스룸; 테라스; 신축공사; 건축설계; 연제욱 (20202672); 층 평면도; 2층 평면도; SCALE 1/50; 바닥면적 66.99; (준불연; 겹 양면 (THK150), ·다용도실은 방수석고보드; ·그리드; 철근콘크리트; 외단열 PF보드; 경량 칸막이

NOTE PROJECT NO.

1. 외벽: 스터코 10 + PF보드
100 + RC 180 + 석고보드 9.5 (
2. 내벽: 경량철골 칸막이 + 석고보드
3. 창호 기호 W·D: A-001 창호일람표
6. 치수: 외벽 바깥면
중심선) 기준
7. 계단 오픈부 난간 H1,200 (강관 +
강화유리
8. 테라스: 우레탄 도막방수, RD
루프드레인 Ø100, 파라펫 H1,200,

인허가
·구조기술사의 검토와 날인 전에는
건축사
치수 mm, 레벨 기준 GL±0 (설계 지반고).

·실시설계 검토용 초안입니다.

·제출에 쓰지 않습니다.

DRAWN BY DRAWING TITLE DATE APPROVED BY CHECKED BY

School of Architecture 도면작성

# 신축계획안

# 신축공사

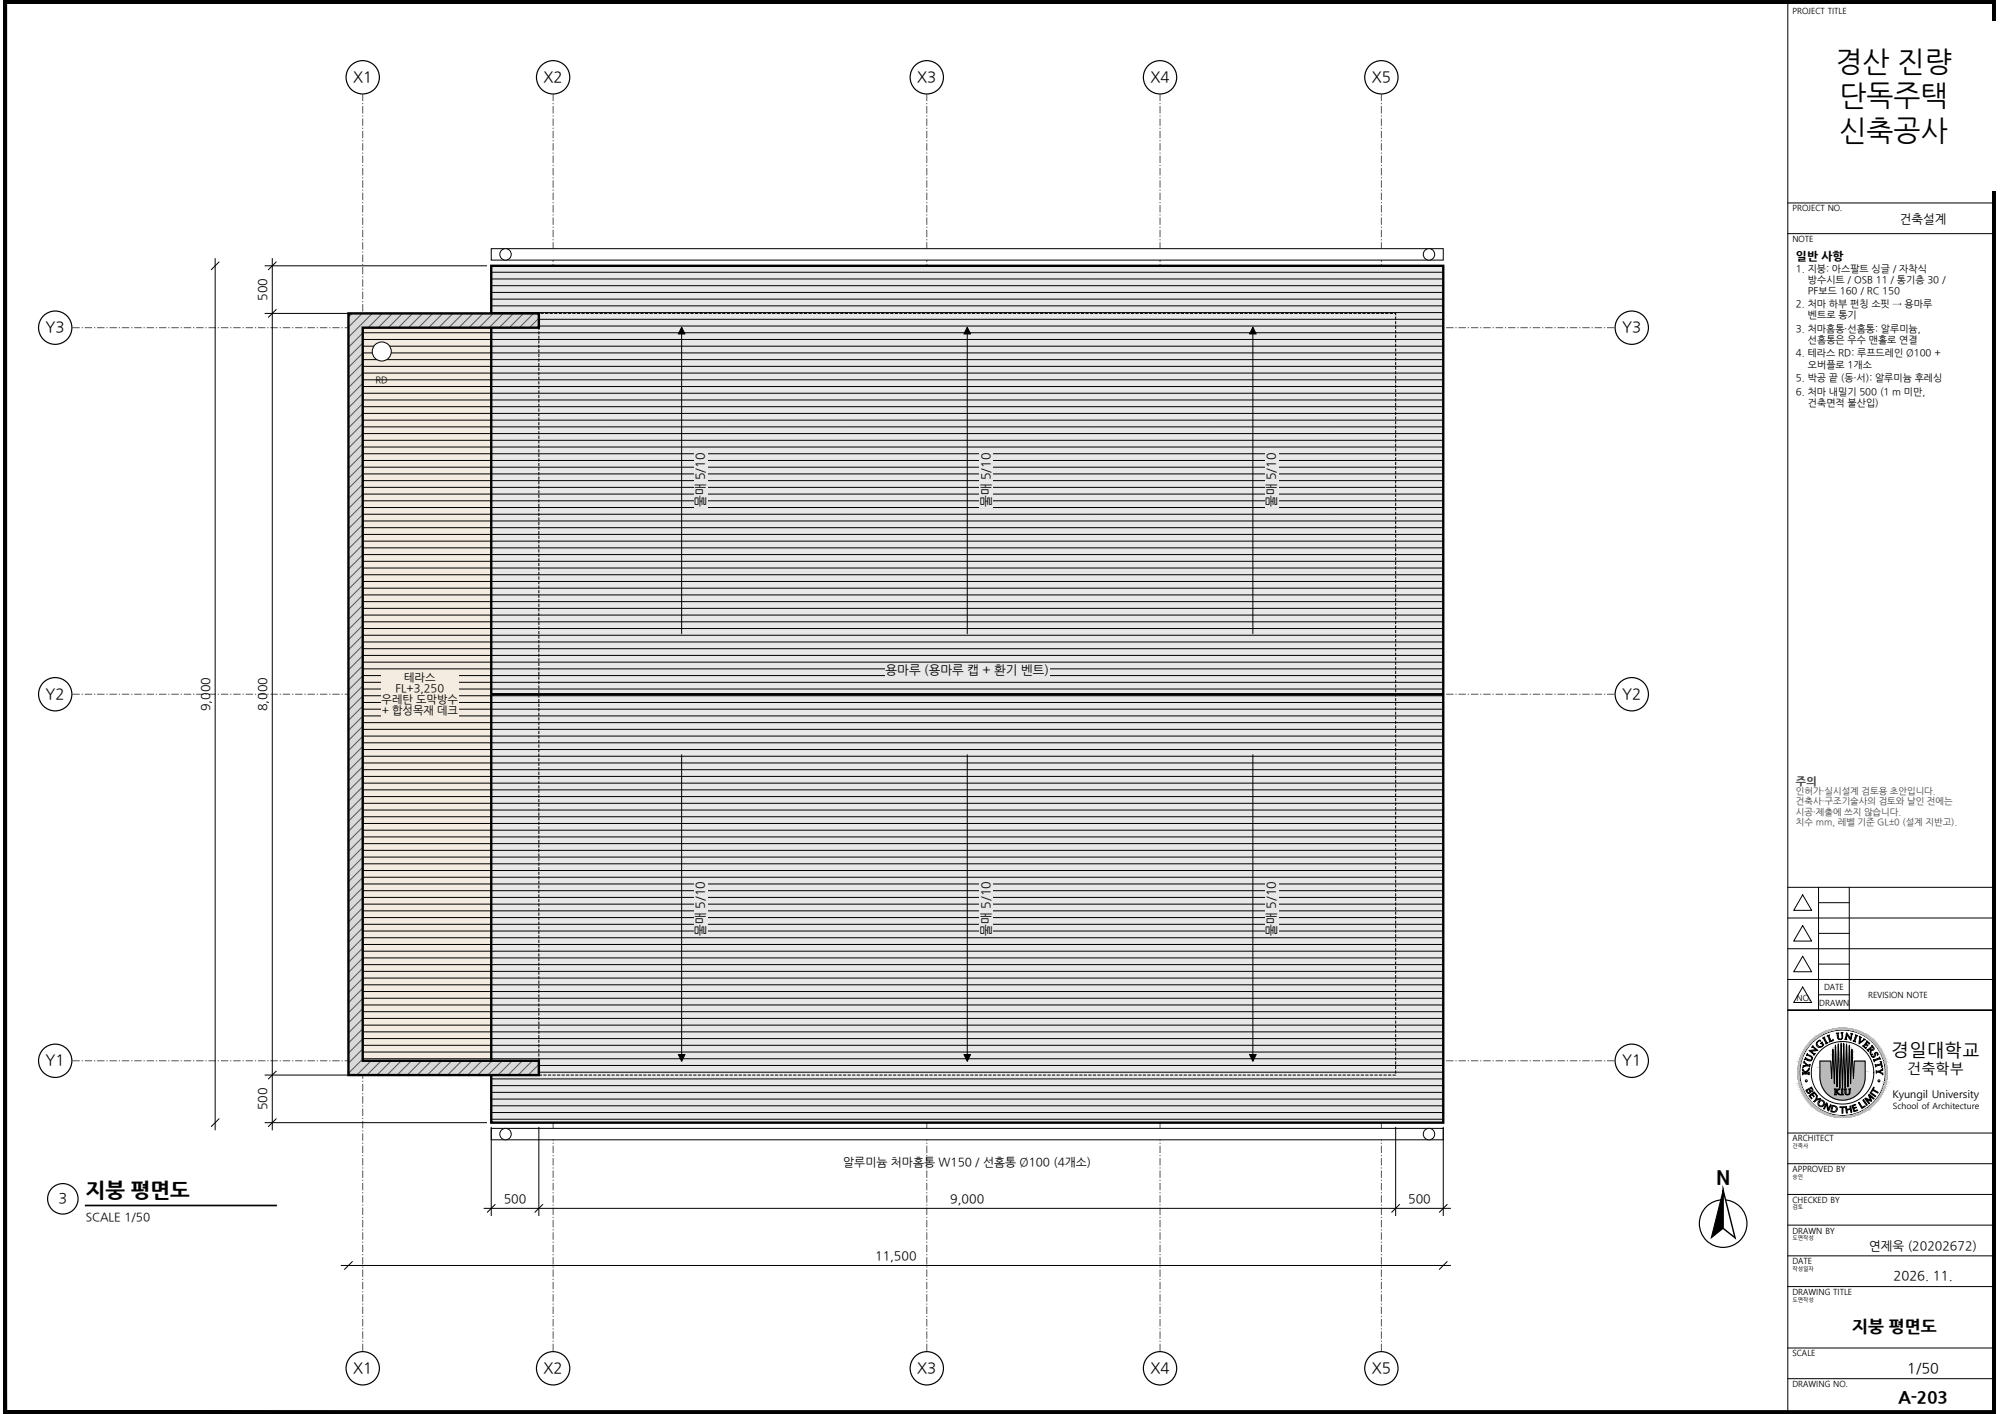
[picture p26: page 6]
ARCHITECT; DATE DRAWN; REVISION NOTE; 경일대학교; 작성일자; 건축사; 건축학부; Kyungil University; 용마루 (용마루; 테라스 FL+3,250 우레탄 도막방수 + 합성목재 데크; 건축설계; 연제욱 (20202672); 지붕 평면도; SCALE 1/50; → 용마루; ·선홈통: 알루미늄; 서): 알루미늄 후레싱 ,

NOTE PROJECT NO.

1. 지붕: 아스팔트 싱글 / 자착식
방수시트 / OSB 11 / 통기층 30 /
PF보드 160 / RC 150
벤트로 통기
3. 처마홈통
선홈통은 우수 맨홀로 연결
4. 테라스 RD: 루프드레인 Ø100 + 오버플로 1개소

6. 처마 내밀기 500 (1 m 미만
건축면적 불산입

인허가
·구조기술사의 검토와 날인 전에는
건축사
치수 mm, 레벨 기준 GL±0 (설계 지반고).

·실시설계 검토용 초안입니다.

·제출에 쓰지 않습니다.

DRAWN BY DRAWING TITLE DATE APPROVED BY CHECKED BY

School of Architecture 도면작성

알루미늄 처마홈통 W150 / 선홈통 Ø100 (4개소

# 신축계획안

## 최고높이 +8,680

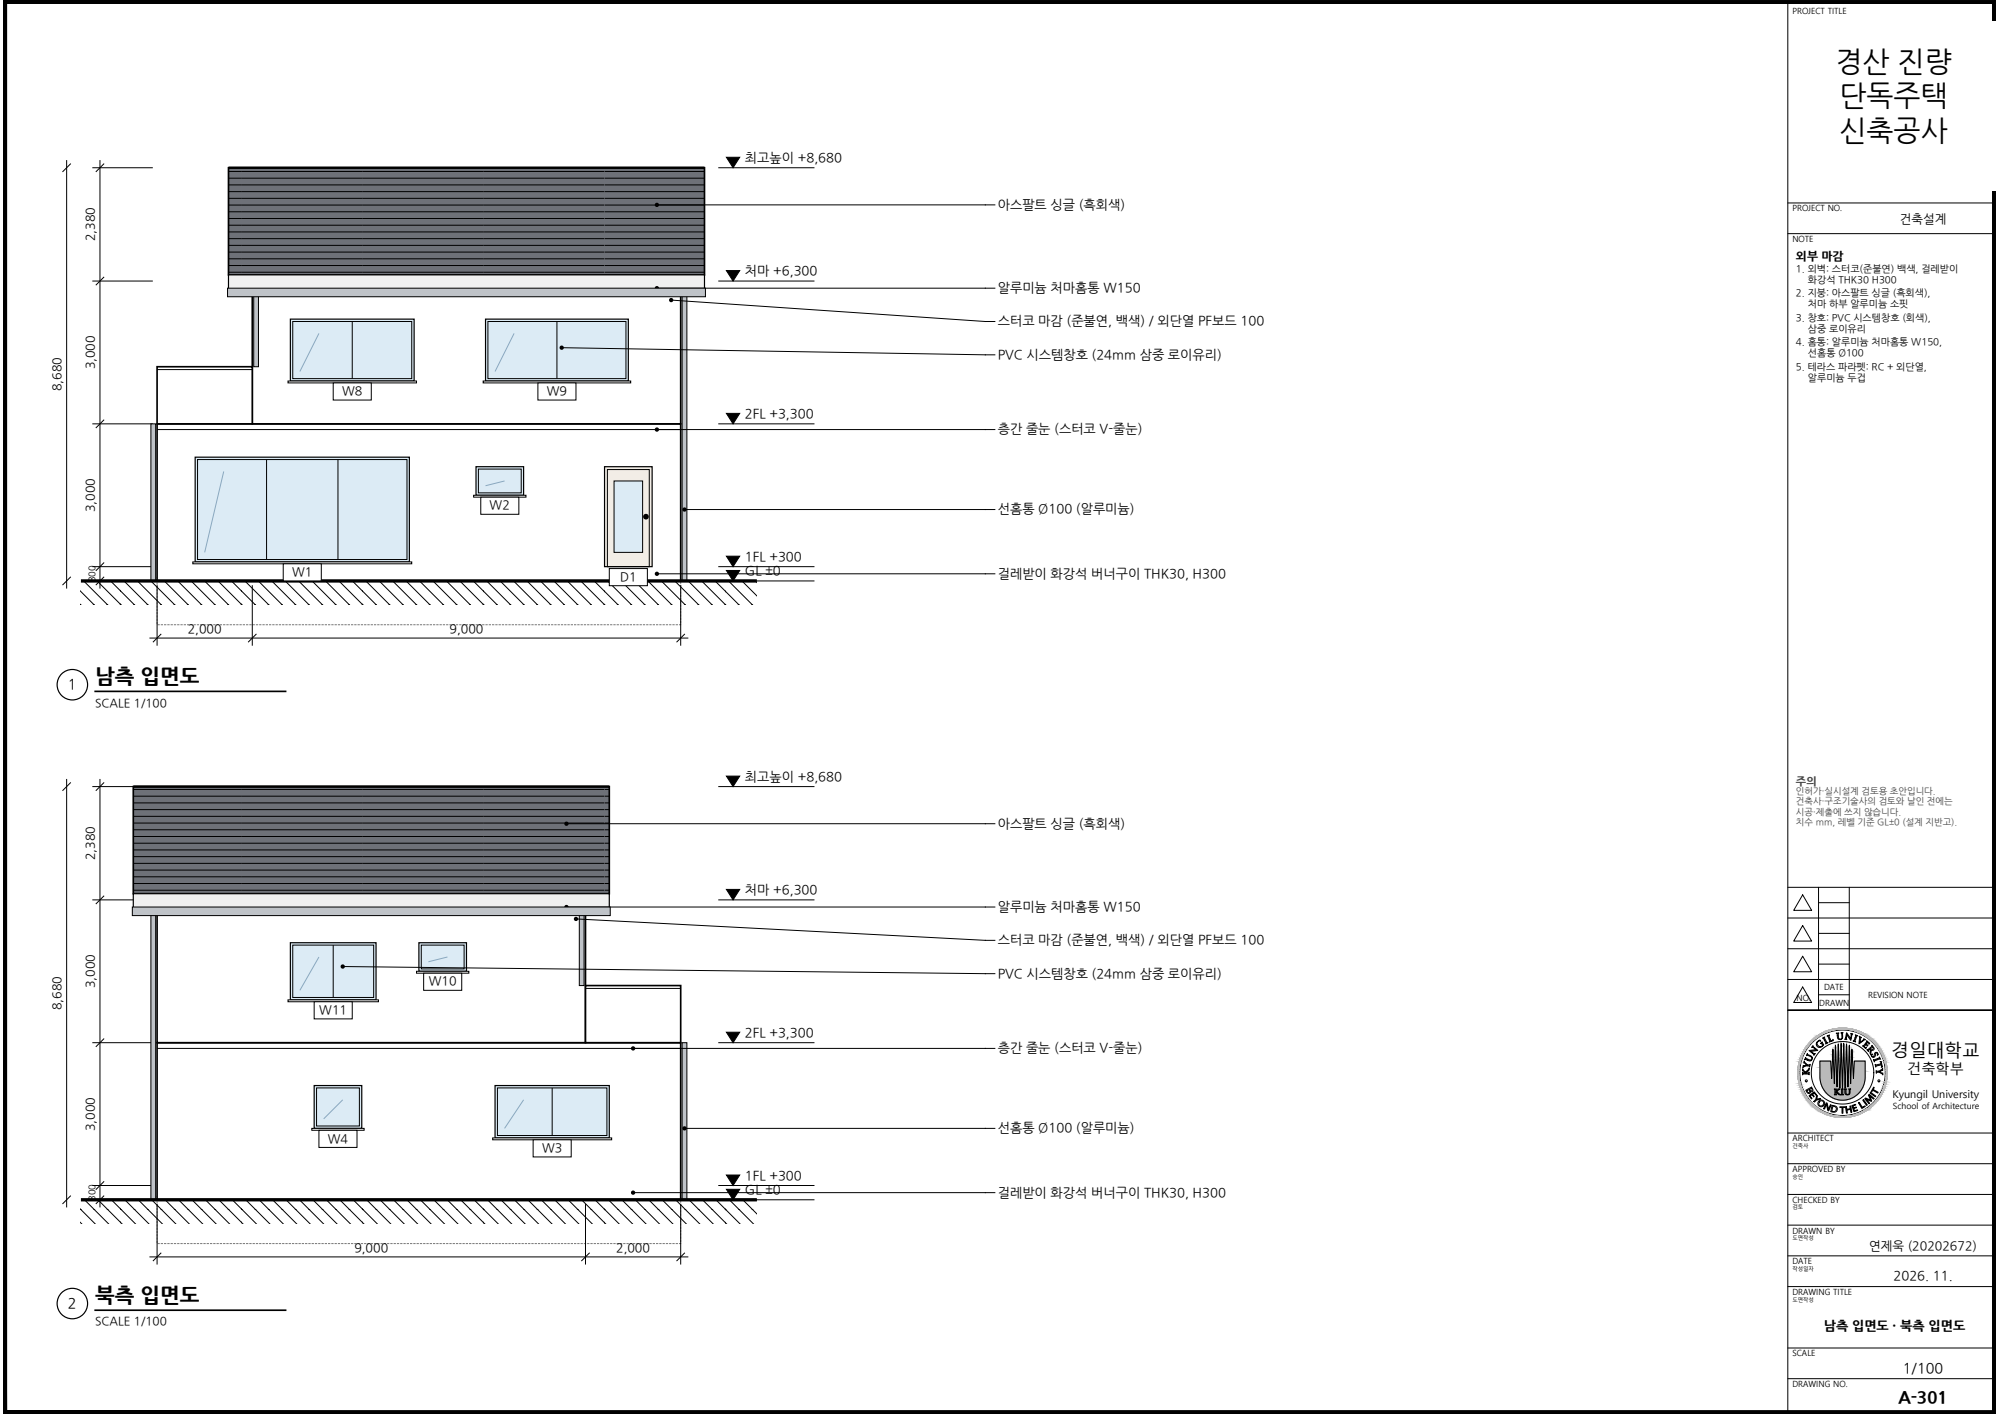
[picture p27: page 7]
ARCHITECT; DATE DRAWN; REVISION NOTE; 경일대학교; 작성일자; 건축사; 건축학부; Kyungil University; 알루미늄 처마홈통 W150; 선홈통 Ø100 (알루미늄; 걸레받이 화강석; 버너구이 THK30, H300; 최고높이 +8,680; 신축공사; 건축설계; 연제욱 (20202672); 남측 입면도; SCALE 1/100; 북측 입면도

아스팔트 싱글 (흑회색

NOTE PROJECT NO.

1. 외벽: 스터코
화강석 THK30 H300
2. 지붕: 아스팔트 싱글 (흑회색),
처마 하부 알루미늄
3. 창호: PVC 시스템창호 (회색),
삼중 로이유리
4. 홈통: 알루미늄 처마홈통 W150,
선홈통 Ø100
5. 테라스 파라펫: RC + 외단열
알루미늄

(준불연) 백색, 걸레받이

스터코 마감 (준불연, 백색) / 외단열 PF보드 100

PVC 시스템창호 (24mm 삼중 로이유리

층간 줄눈 (스터코 V-줄눈

인허가
·구조기술사의 검토와 날인 전에는
건축사
치수 mm, 레벨 기준 GL±0 (설계 지반고).

·실시설계 검토용 초안입니다.

·제출에 쓰지 않습니다.

DRAWN BY DRAWING TITLE DATE APPROVED BY CHECKED BY

School of Architecture 도면작성

남측 입면도 · 북측 입면도

# 신축계획안

## 최고높이 +8,680

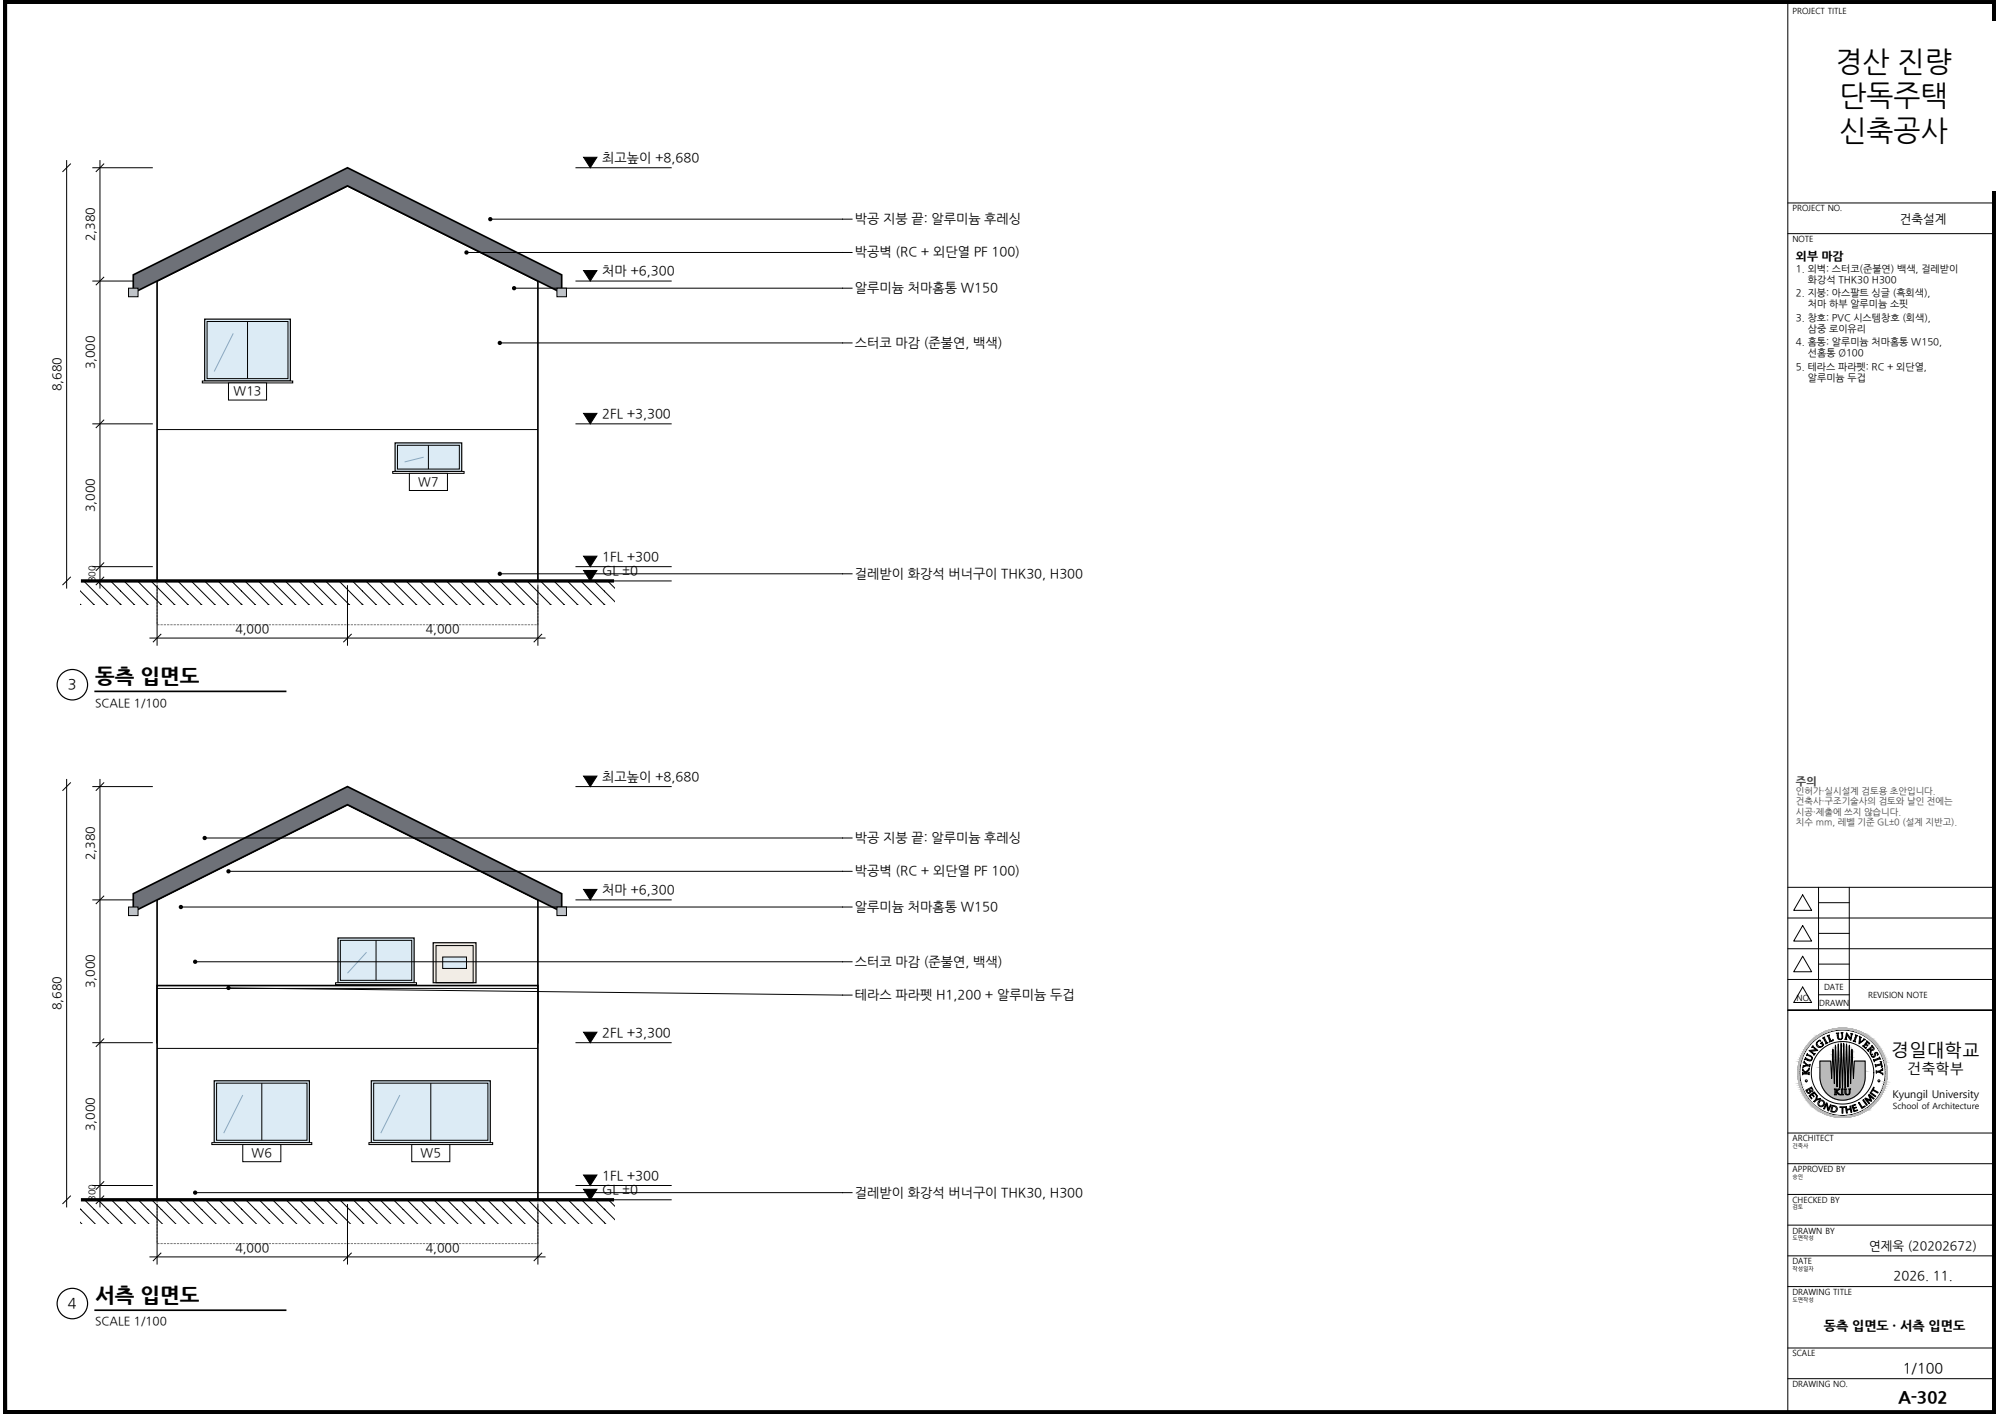
[picture p28: page 8]
ARCHITECT; DATE DRAWN; REVISION NOTE; 경일대학교; 작성일자; 건축사; 건축학부; Kyungil University; 끝: 알루미늄 후레싱; 알루미늄 처마홈통 W150; 걸레받이 화강석; 버너구이 THK30, H300; 최고높이 +8,680; 신축공사; 건축설계; 연제욱 (20202672); 동측 입면도; SCALE 1/100; 서측 입면도

NOTE PROJECT NO.

박공벽 (RC + 외단열 PF 100)

1. 외벽: 스터코
화강석 THK30 H300
2. 지붕: 아스팔트 싱글 (흑회색),
처마 하부 알루미늄
3. 창호: PVC 시스템창호 (회색),
삼중 로이유리
4. 홈통: 알루미늄 처마홈통 W150,
선홈통 Ø100
5. 테라스 파라펫: RC + 외단열
알루미늄

(준불연) 백색, 걸레받이

스터코 마감 (준불연, 백색

인허가
·구조기술사의 검토와 날인 전에는
건축사
치수 mm, 레벨 기준 GL±0 (설계 지반고).

·실시설계 검토용 초안입니다.

·제출에 쓰지 않습니다.

테라스 파라펫 H1,200 + 알루미늄

DRAWN BY DRAWING TITLE DATE APPROVED BY CHECKED BY

School of Architecture 도면작성

동측 입면도 · 서측 입면도

# 신축계획안

## 천장 내부 (환기

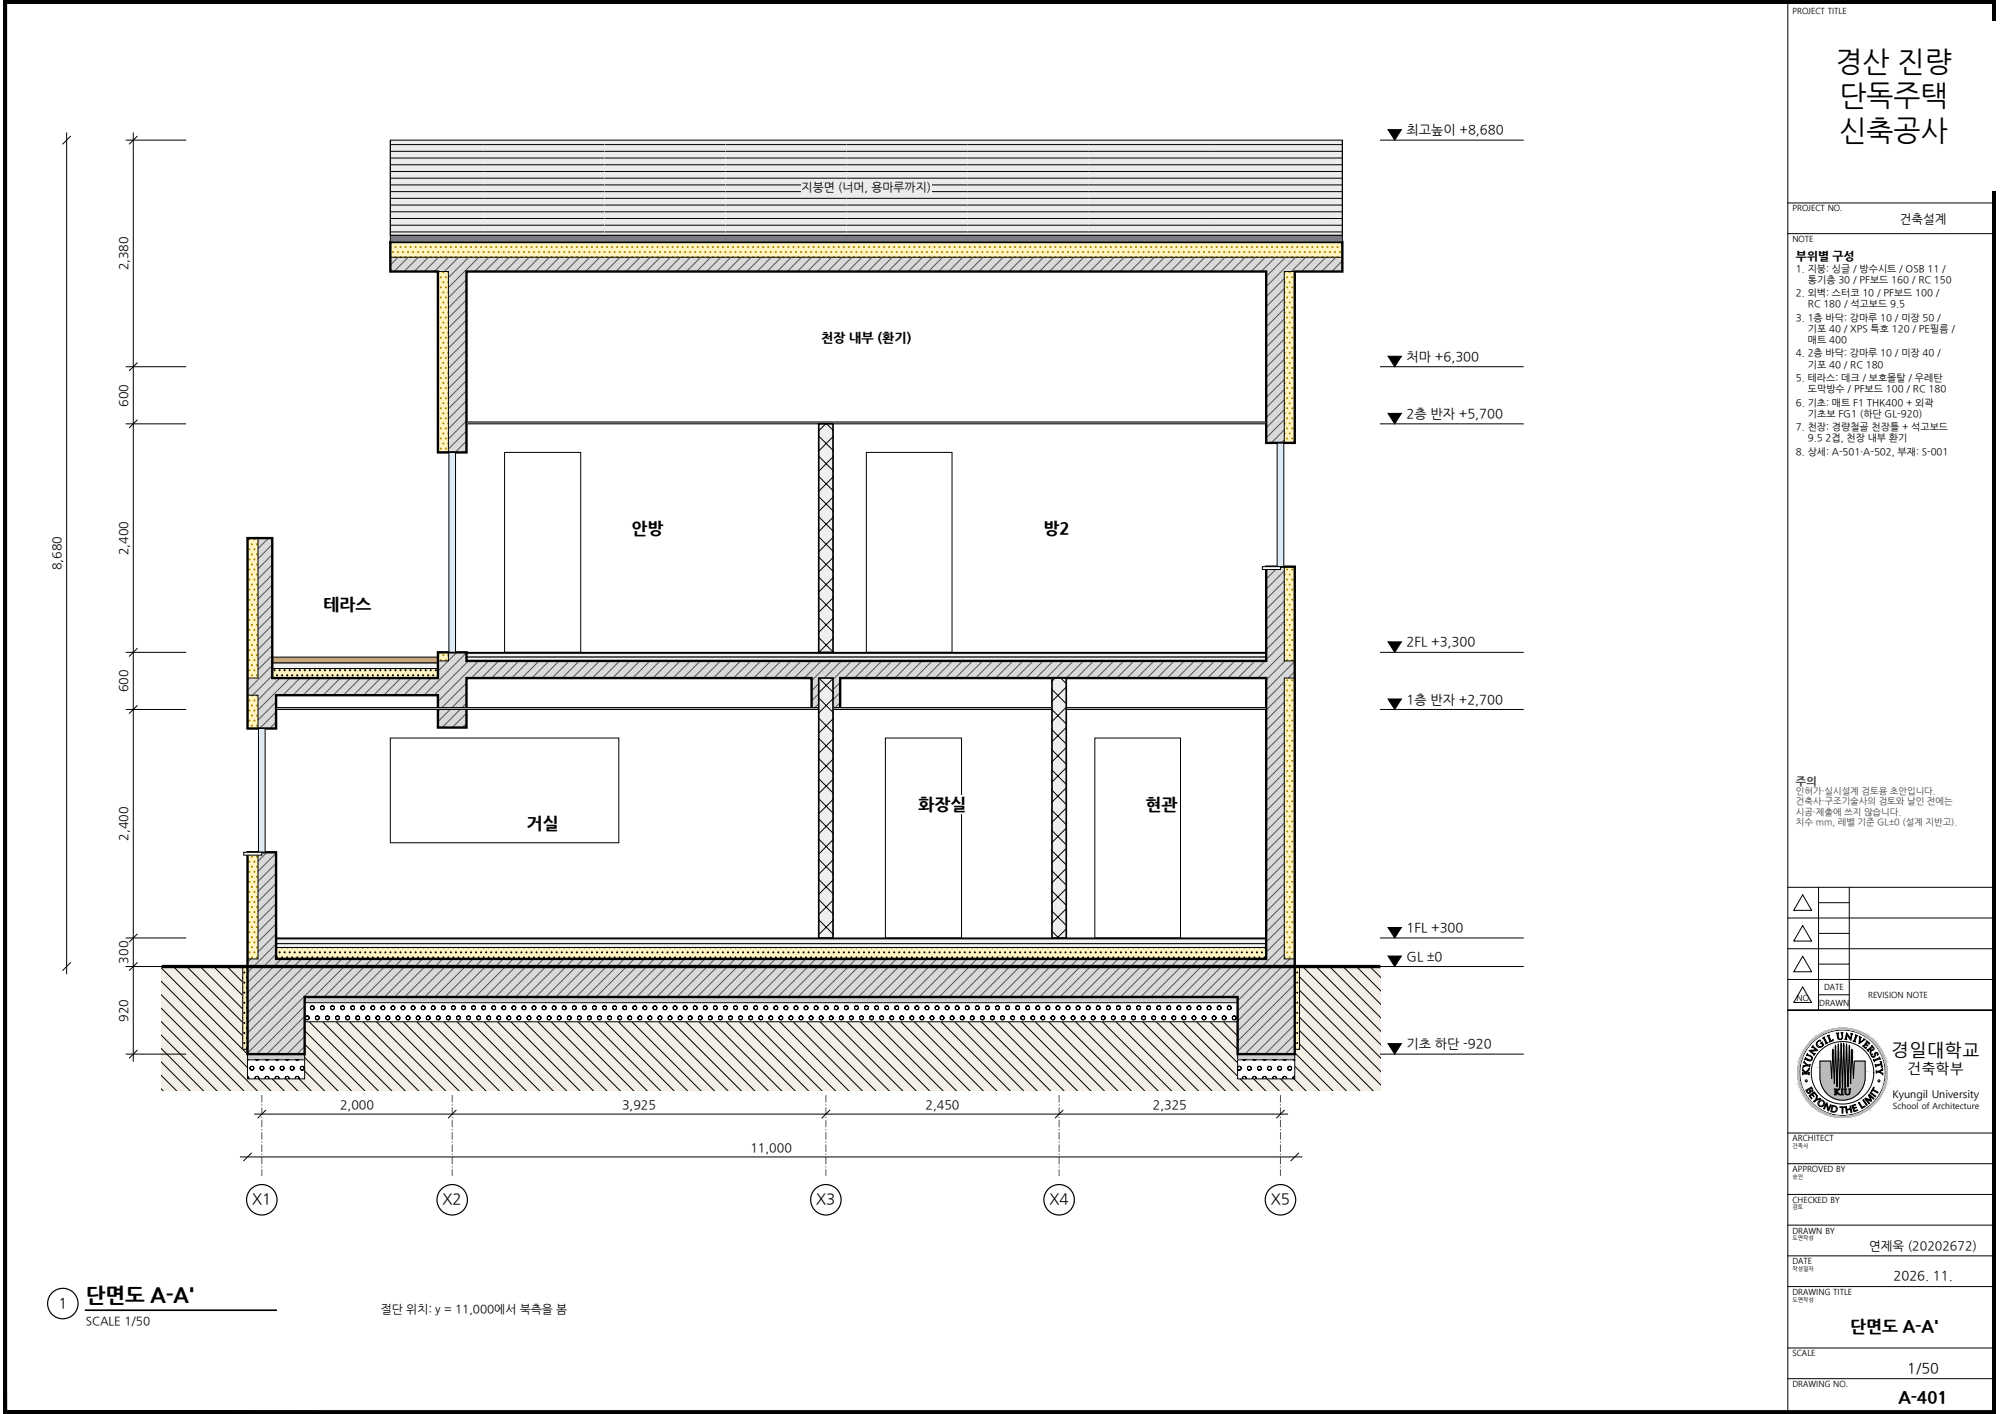
[picture p29: page 9]
ARCHITECT; DATE DRAWN; REVISION NOTE; 경일대학교; 작성일자; 건축사; 건축학부; Kyungil University; 지붕면 (; 머, 용마루; 화장실; 테라스; 최고높이 +8,680; 신축공사; 건축설계; 연제욱 (20202672); 단면도 A-A'; SCALE 1/50

NOTE PROJECT NO.

부위별 구성
1. 지붕: 싱글 / 방수시트 / OSB 11 /
통기층 30 / PF보드 160 / RC 150
2. 외벽: 스터코 10 / PF보드 100 /
RC 180 / 석고보드 9.5
기포 40 / XPS
5. 테라스: 데크 / 보호몰탈 / 우레탄
도막방수 / PF보드 100 / RC 180
6. 기초: 매트 F1 THK400 +
기초보 FG1 (하단 GL-920)
7. 천장: 경량철골 천장틀 + 석고보드

층 바닥: 강마루 10 / 미장 50 /

층 바닥: 강마루 10 / 미장 40 /

인허가
·구조기술사의 검토와 날인 전에는
건축사
치수 mm, 레벨 기준 GL±0 (설계 지반고).

·실시설계 검토용 초안입니다.

·제출에 쓰지 않습니다.

DRAWN BY DRAWING TITLE DATE APPROVED BY CHECKED BY

School of Architecture 도면작성

절단 위치: y = 11,000에서 북측을

# 신축계획안

## 천장 내부 (환기

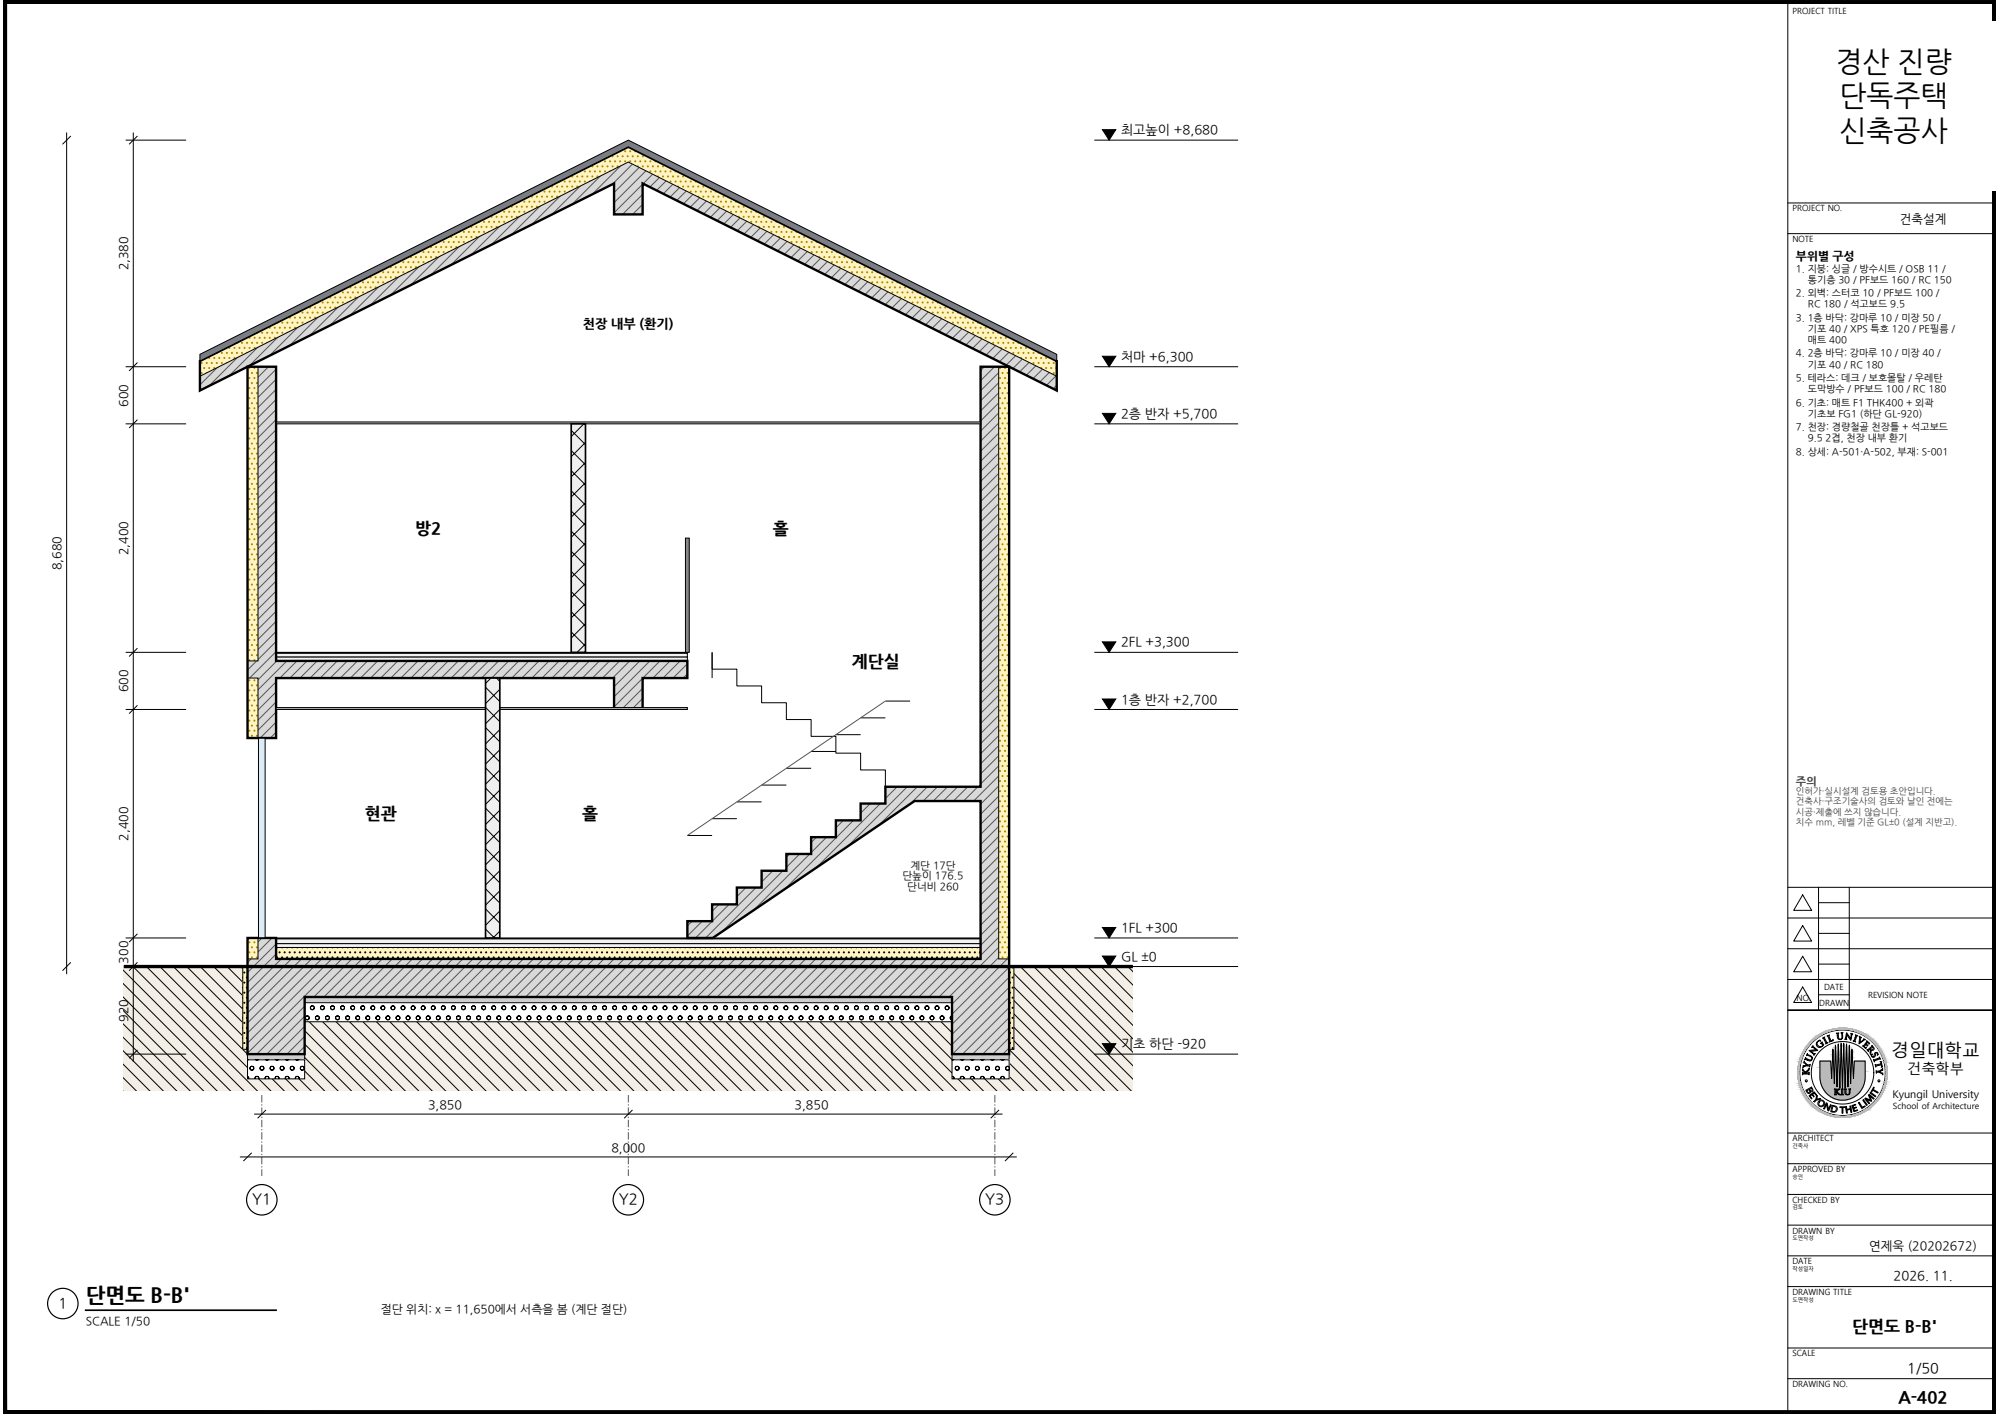
[picture p30: page 10]
ARCHITECT; DATE DRAWN; REVISION NOTE; 경일대학교; 작성일자; 건축사; 건축학부; Kyungil University; 단 단높이 176.5 단너비 260; 계단실; 최고높이 +8,680; 신축공사; 건축설계; 연제욱 (20202672); 단면도 B-B'; SCALE 1/50

NOTE PROJECT NO.

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

층 바닥: 강마루 10 / 미장 50 /

층 바닥: 강마루 10 / 미장 40 /

인허가
·구조기술사의 검토와 날인 전에는
건축사
치수 mm, 레벨 기준 GL±0 (설계 지반고).

·실시설계 검토용 초안입니다.

·제출에 쓰지 않습니다.

DRAWN BY DRAWING TITLE DATE APPROVED BY CHECKED BY

School of Architecture 도면작성

절단 위치: x = 11,650에서 서측을

# 신축계획안

1FL +300

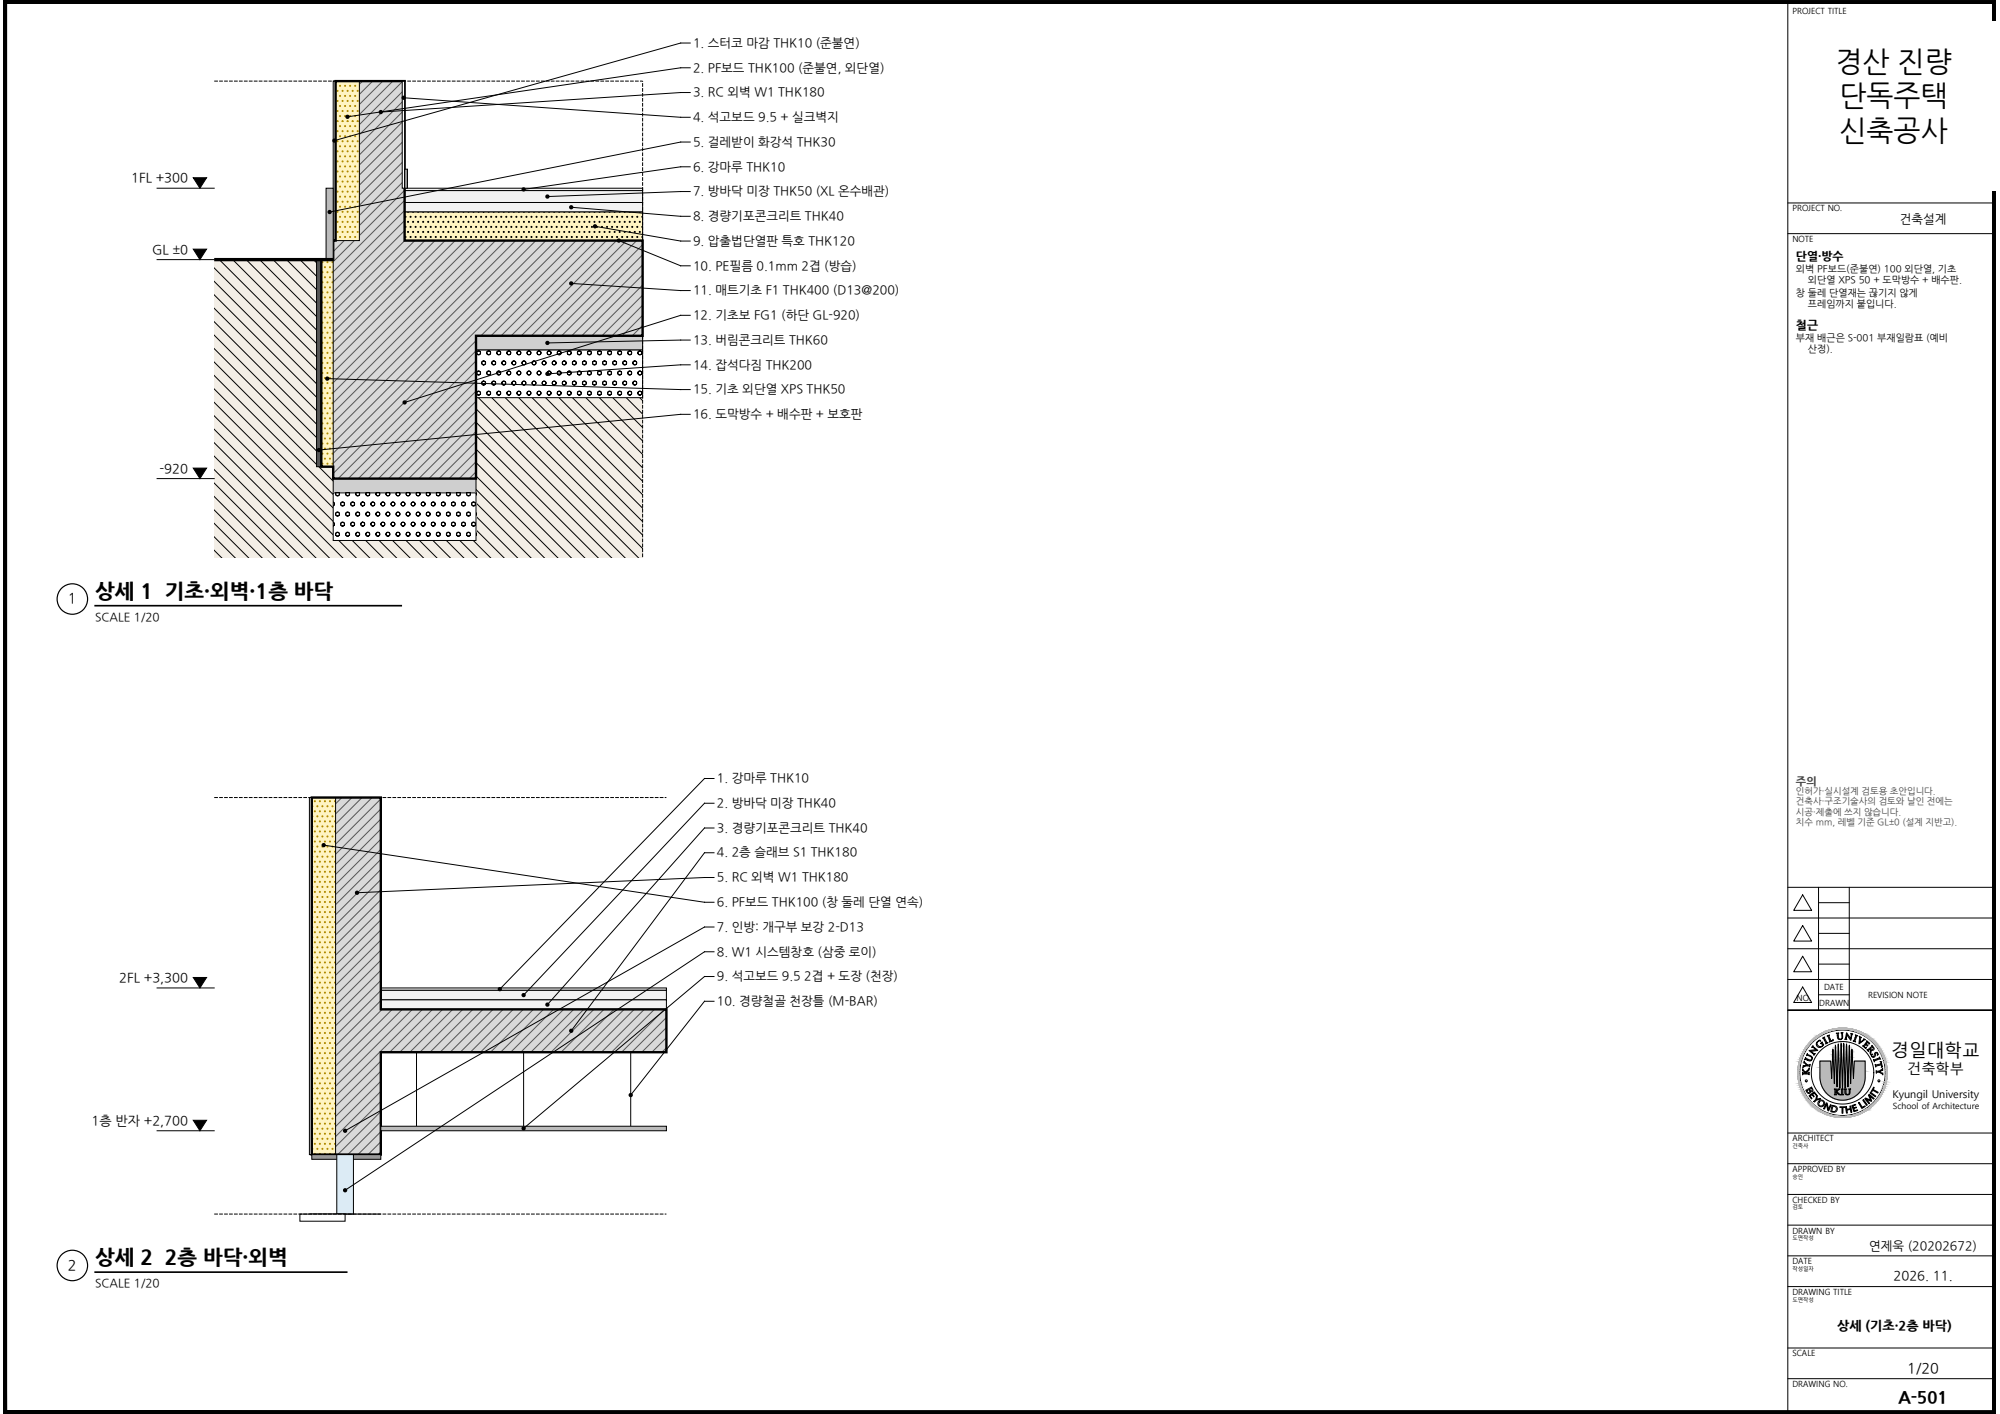
[picture p31: page 11]
ARCHITECT; DATE DRAWN; REVISION NOTE; 경일대학교; 작성일자; 건축사; 건축학부; Kyungil University; 3. RC 외벽 W1 THK180; 4. 석고보드 9.5 + 실크벽지; 5. 걸레받이 화강석 THK30; 6. 강마루 THK10; 온수배관; 8. 경량기포콘크리트 THK40; 압출법단열; 호 THK120; 11. 매트기초 F1 THK400 (D13@200); 13. 버림콘크리트 THK60; 잡석다; 짐 THK200; 16. 도막방수 + 배수; 1. 강마루 THK10; 2. 방바닥 미장 THK40; 3. 경량기포콘크리트 THK40; 슬래브 S1 THK180; 5. RC 외벽 W1 THK180; 6. PF보드 THK100 (; 9. 석고보드 9.5 2; 신축공사; 건축설계; 연제욱 (20202672); SCALE 1/20; 붙입니다.

1. 스터코 마감 THK10 (준불연

2. PF보드 THK100 (준불연, 외단열

7. 방바닥 미장 THK50 (XL

NOTE PROJECT NO.

외벽 PF보드
외단열 XPS 50 + 도막방수 + 배수

(준불연) 100 외단열, 기초

판. 창 둘레 단열재는 끊기지 않게

프레임
부재 배근은 S-001 부재일람표 (

12. 기초보 FG1 (하단 GL-920)

15. 기초 외단열 XPS THK50

인허가
·구조기술사의 검토와 날인 전에는
건축사
치수 mm, 레벨 기준 GL±0 (설계 지반고).

·실시설계 검토용 초안입니다.

·제출에 쓰지 않습니다.

7. 인방: 개구부 보강 2-D13

8. W1 시스템창호 (삼중 로이

10. 경량철골 천장틀 (M-BAR)

DRAWN BY DRAWING TITLE DATE APPROVED BY CHECKED BY

School of Architecture 도면작성

# 신축계획안

처마 +6,300

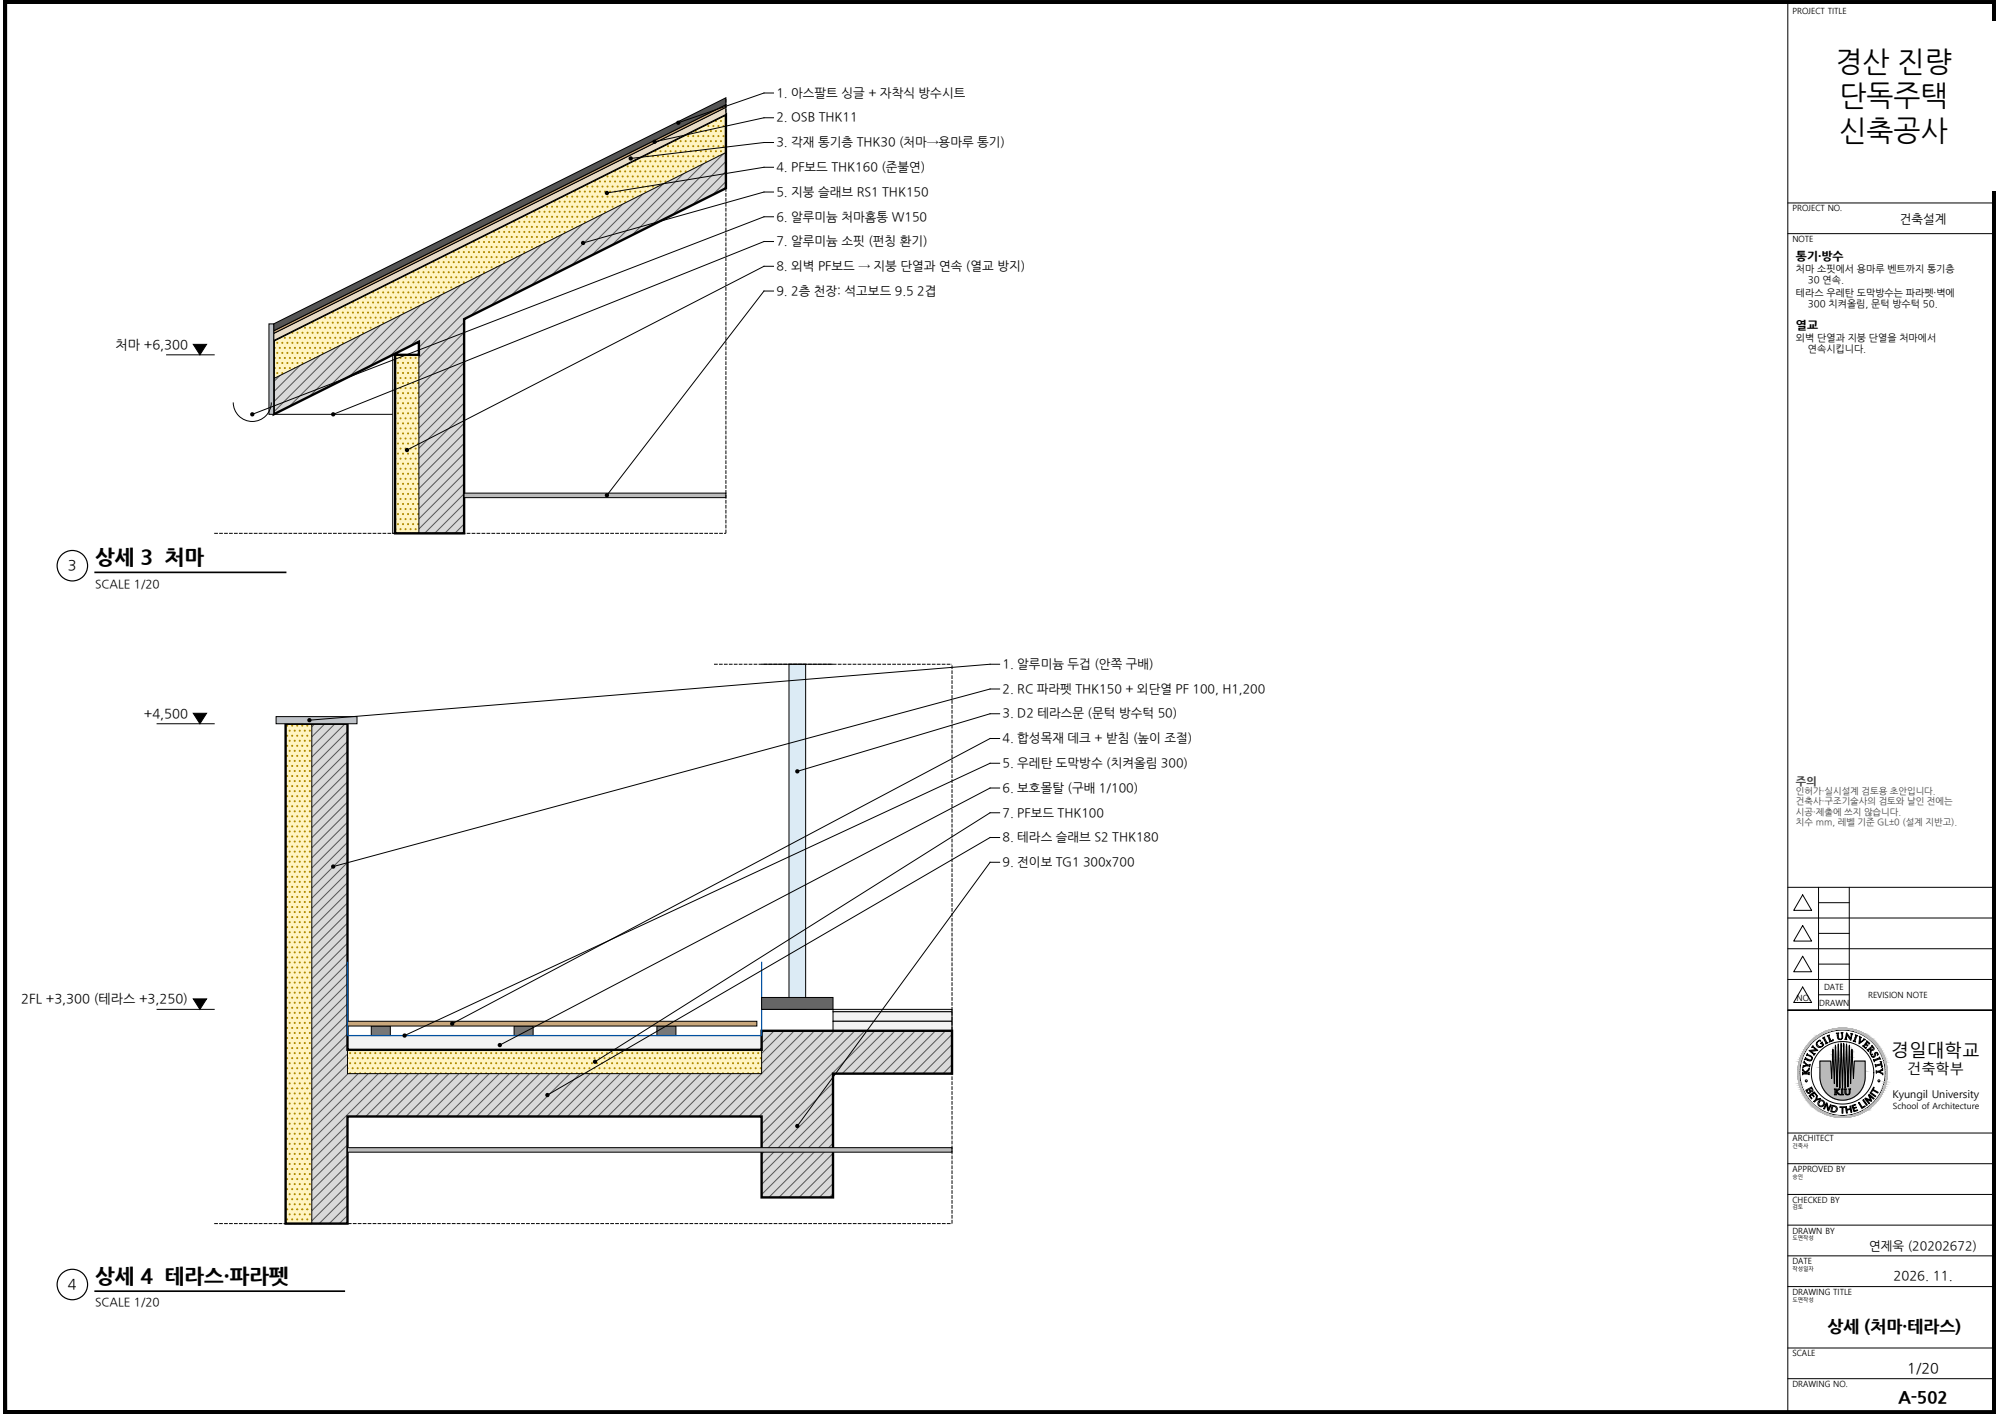
[picture p32: page 12]
ARCHITECT; DATE DRAWN; REVISION NOTE; 경일대학교; 작성일자; 건축사; 건축학부; Kyungil University; 2. OSB THK11; 4. PF보드 THK160 (준불연); 5. 지붕 슬래브 RS1 THK150; 6. 알루미늄 처마홈통 W150; 9. 2층 천장: 석고보드 9.5 2겹; 2FL +3,300 (테라스 +3,250); 6. 보호몰탈 (구배 1/100); 7. PF보드 THK100; 8. 테라스 슬래브 S2 THK180; 9. 전이보 TG1 300x700; 신축공사; 건축설계; 연제욱 (20202672); SCALE 1/20; 상세 4 테라스·파라펫

1. 아스팔트 싱글 + 자착식 방수시트

3. 각재 통기층 THK30 (처마→용마루 통기)

NOTE PROJECT NO.

7. 알루미늄 소핏 (펀칭 환기)

8. 외벽 PF보드 → 지붕 단열과 연속 (열교 방지)

처마 소핏에서 용마루 벤트까지 통기층
테라스 우레탄 도막방수는 파라펫·벽에
300 치켜올림, 문턱 방수턱 50.
외벽 단열과 지붕 단열을 처마에서
연속시킵니다.

1. 알루미늄 두겁 (안쪽 구배)

2. RC 파라펫 THK150 + 외단열 PF 100, H1,200

3. D2 테라스문 (문턱 방수턱 50)

4. 합성목재 데크 + 받침 (높이 조절)

5. 우레탄 도막방수 (치켜올림 300)

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

DRAWN BY DRAWING TITLE DATE APPROVED BY CHECKED BY

School of Architecture 도면작성

상세 (처마·테라스)

# 신축계획안

# 신축공사

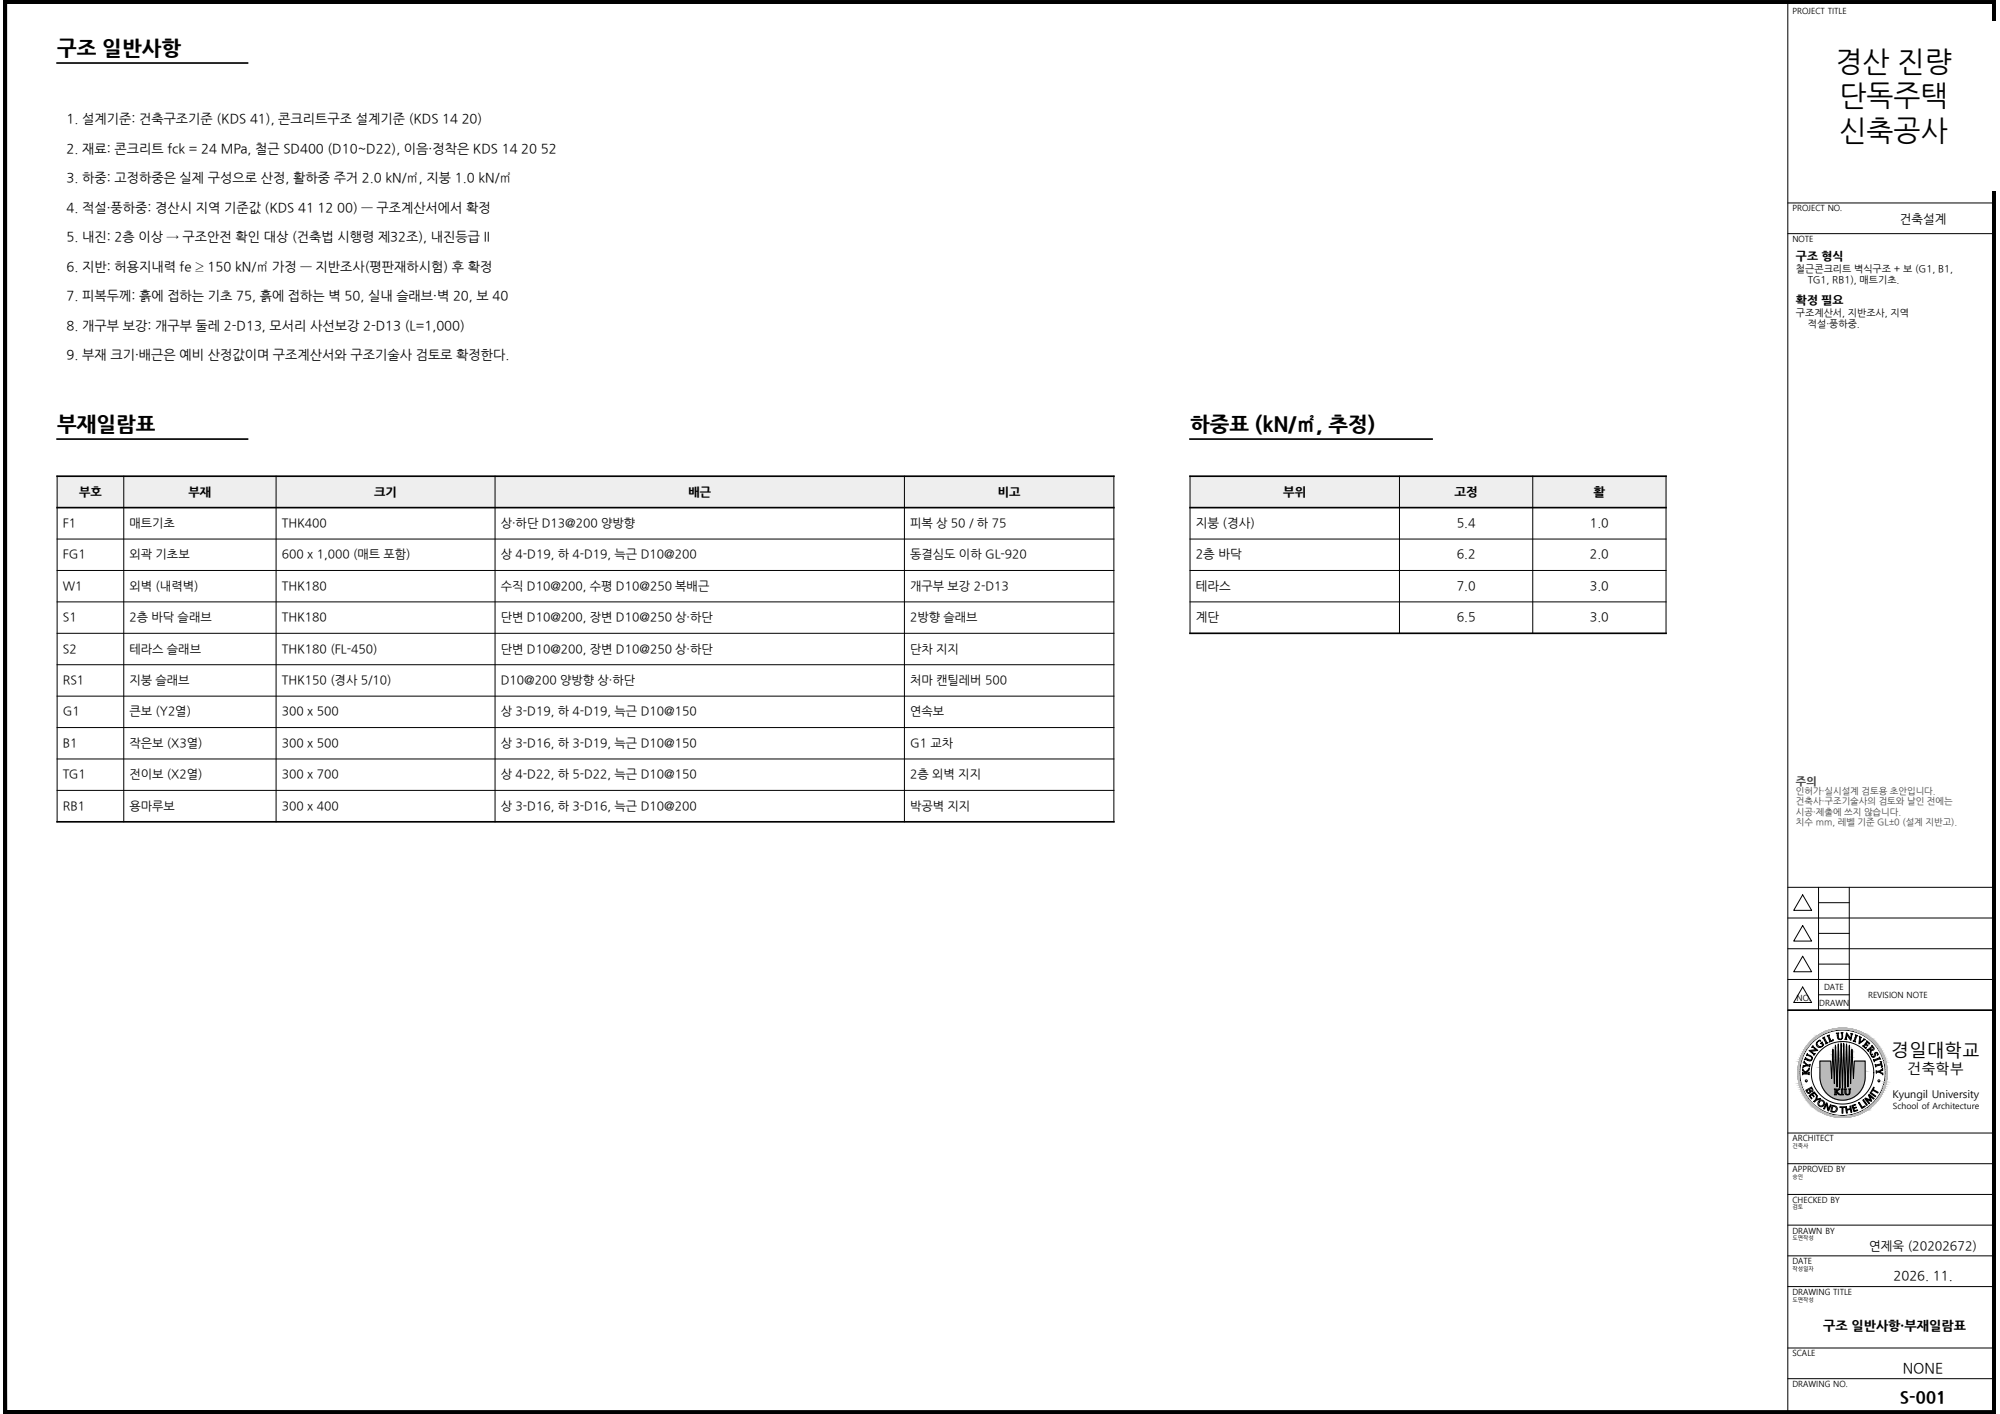
[picture p33: page 13]
ARCHITECT; DATE DRAWN; REVISION NOTE; 경일대학교; 작성일자; 건축사; 건축학부; Kyungil University; 건축설계; 연제욱 (20202672); NONE S-001; 구조 일반사항; 부재일람표; 매트기초; THK400; 상·하단 D13@200 양방향; 외곽 기초보; 동결심도 이하 GL-920; 외벽 (내력벽); THK180; 수직 D10@200, 수평 D10@250 복배근; 개구부 보강 2-D13; 2층 바닥 슬래브; 2방향 슬래브; 테라스

1. 설계기준: 건축구조기준 (KDS 41), 콘크리트구조 설계기준 (KDS 14 20)

2. 재료: 콘크리트 fck = 24 MPa, 철근 SD400 (D10~D22), 이음·정착은 KDS 14 20 52

3. 하중: 고정하중은 실제 구성으로 산정, 활하중 주거 2.0 kN/㎡, 지붕 1.0 kN/㎡

4. 적설·풍하중: 경산시 지역 기준값 (KDS 41 12 00) — 구조계산서에서 확정

NOTE PROJECT NO.

5. 내진: 2층 이상 → 구조안전 확인 대상 (건축법 시행령 제32조), 내진등급 II

6. 지반: 허용지내력 fe ≥ 150 kN/㎡ 가정 — 지반조사(평판재하시험) 후 확정

철근콘크리트 벽식구조 + 보 (G1, B1,
TG1, RB1), 매트기초.
구조계산서, 지반조사, 지역
적설·풍하중.

7. 피복두께: 흙에 접하는 기초 75, 흙에 접하는 벽 50, 실내 슬래브·벽 20, 보 40

8. 개구부 보강: 개구부 둘레 2-D13, 모서리 사선보강 2-D13 (L=1,000)

9. 부재 크기·배근은 예비 산정값이며 구조계산서와 구조기술사 검토로 확정한다.

하중표 (kN/㎡, 추정)

S2 | 테라스 슬래브 | THK180 (FL-450) | 단변 D10@200, 장변 D10@250 상·하단 | 단차 지지

RS1 | 지붕 슬래브 | THK150 (경사 5/10) | D10@200 양방향 상·하단 | 처마 캔틸레버 500

G1 | 큰보 (Y2열) | 300 x 500 | 상 3-D19, 하 4-D19, 늑근 D10@150 | 연속보

B1 | 작은보 (X3열) | 300 x 500 | 상 3-D16, 하 3-D19, 늑근 D10@150 | G1 교차

TG1 | 전이보 (X2열) | 300 x 700 | 상 4-D22, 하 5-D22, 늑근 D10@150 | 2층 외벽 지지

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

RB1 | 용마루보 | 300 x 400 | 상 3-D16, 하 3-D16, 늑근 D10@200 | 박공벽 지지

DRAWN BY DRAWING TITLE DATE APPROVED BY CHECKED BY

School of Architecture 도면작성

구조 일반사항·부재일람표

# 신축계획안

## F1 매트기초 THK400

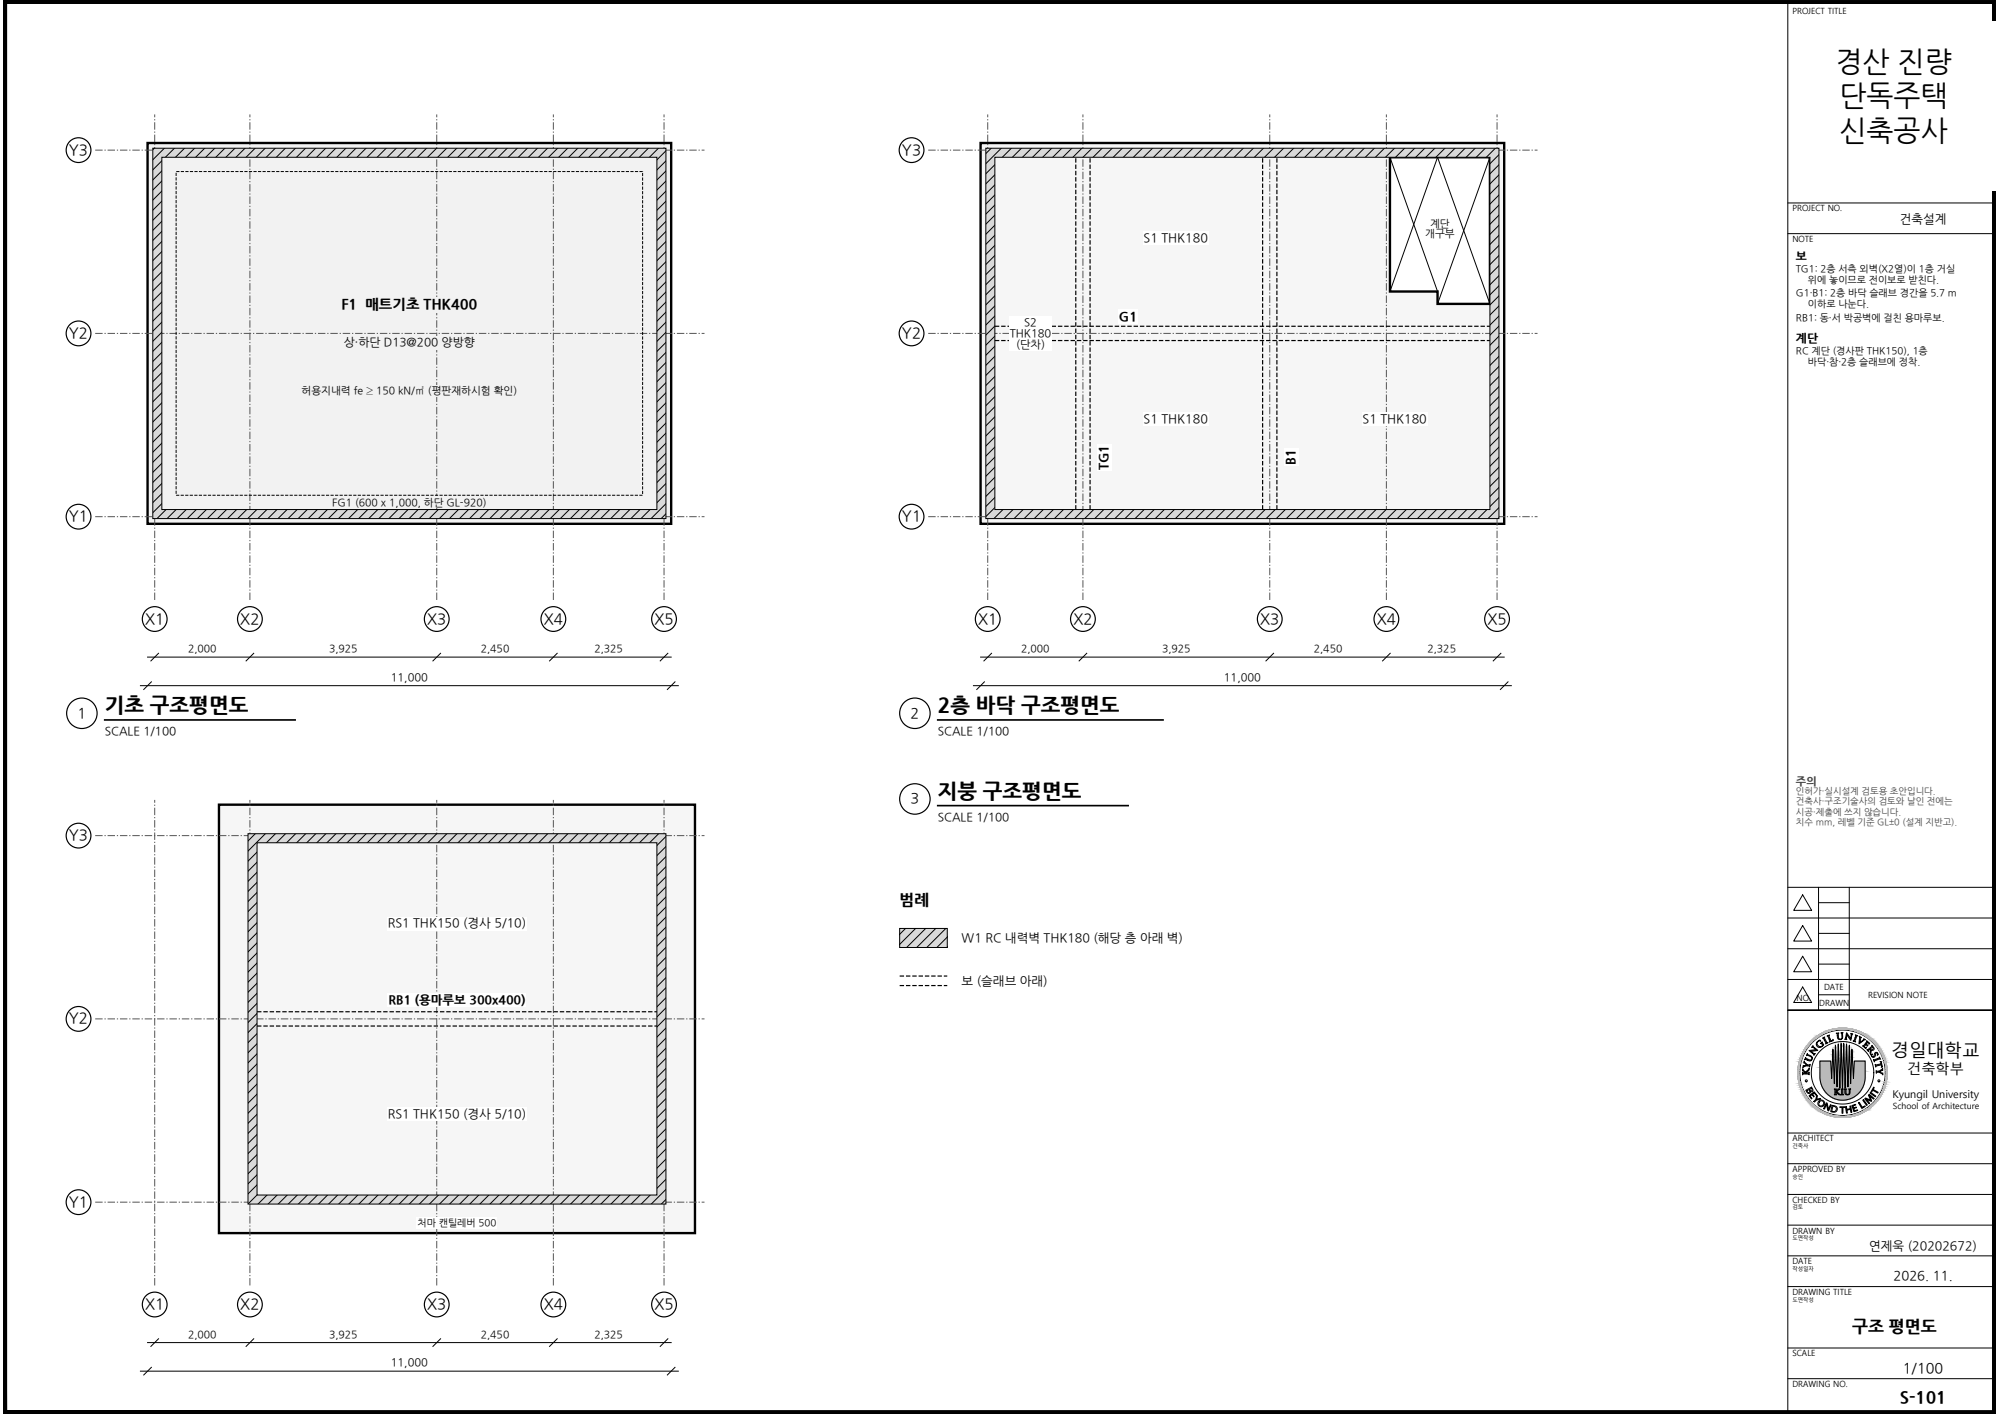
[picture p34: page 14]
ARCHITECT; 경일대학교; 작성일자; 건축사; 건축학부; Kyungil University; 상·하단 D13@200 양방향; 계단 개구부; S1 THK180; RS1 THK150 (경사 5/10); 처마 캔틸레버 500; 신축공사; 건축설계; 연제욱 (20202672); 구조 평면도; 기초 구조평면도; SCALE 1/100; 2층 바닥 구조평면도; 지붕 구조평면도; 보 (슬래브 아래)

NOTE PROJECT NO.

위에 놓이므로 전이보로 받친다.
G1·B1: 2층 바닥 슬래브 경간을 5.7 m
이하로 나눈다.
RB1: 동·서 박공벽에 걸친 용마루보.
RC 계단 (경사판 THK150), 1층
바닥·참·2층 슬래브에 정착.

THK180
(단차) | S1 THK180 | S1 THK180

허용지내력 fe ≥ 150 kN/㎡ (평판재하시험 확인)

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

RS1 THK150 (경사 5/10) RB1 (용마루보 300x400)

W1 RC 내력벽 THK180 (해당 층 아래 벽)

NO. | DATE DRAWN | REVISION NOTE

DRAWN BY DRAWING TITLE DATE APPROVED BY CHECKED BY

School of Architecture 도면작성
