wpdnr3723-a11y/WORKMODE/house/templates/kiu_a3_frame.pdf

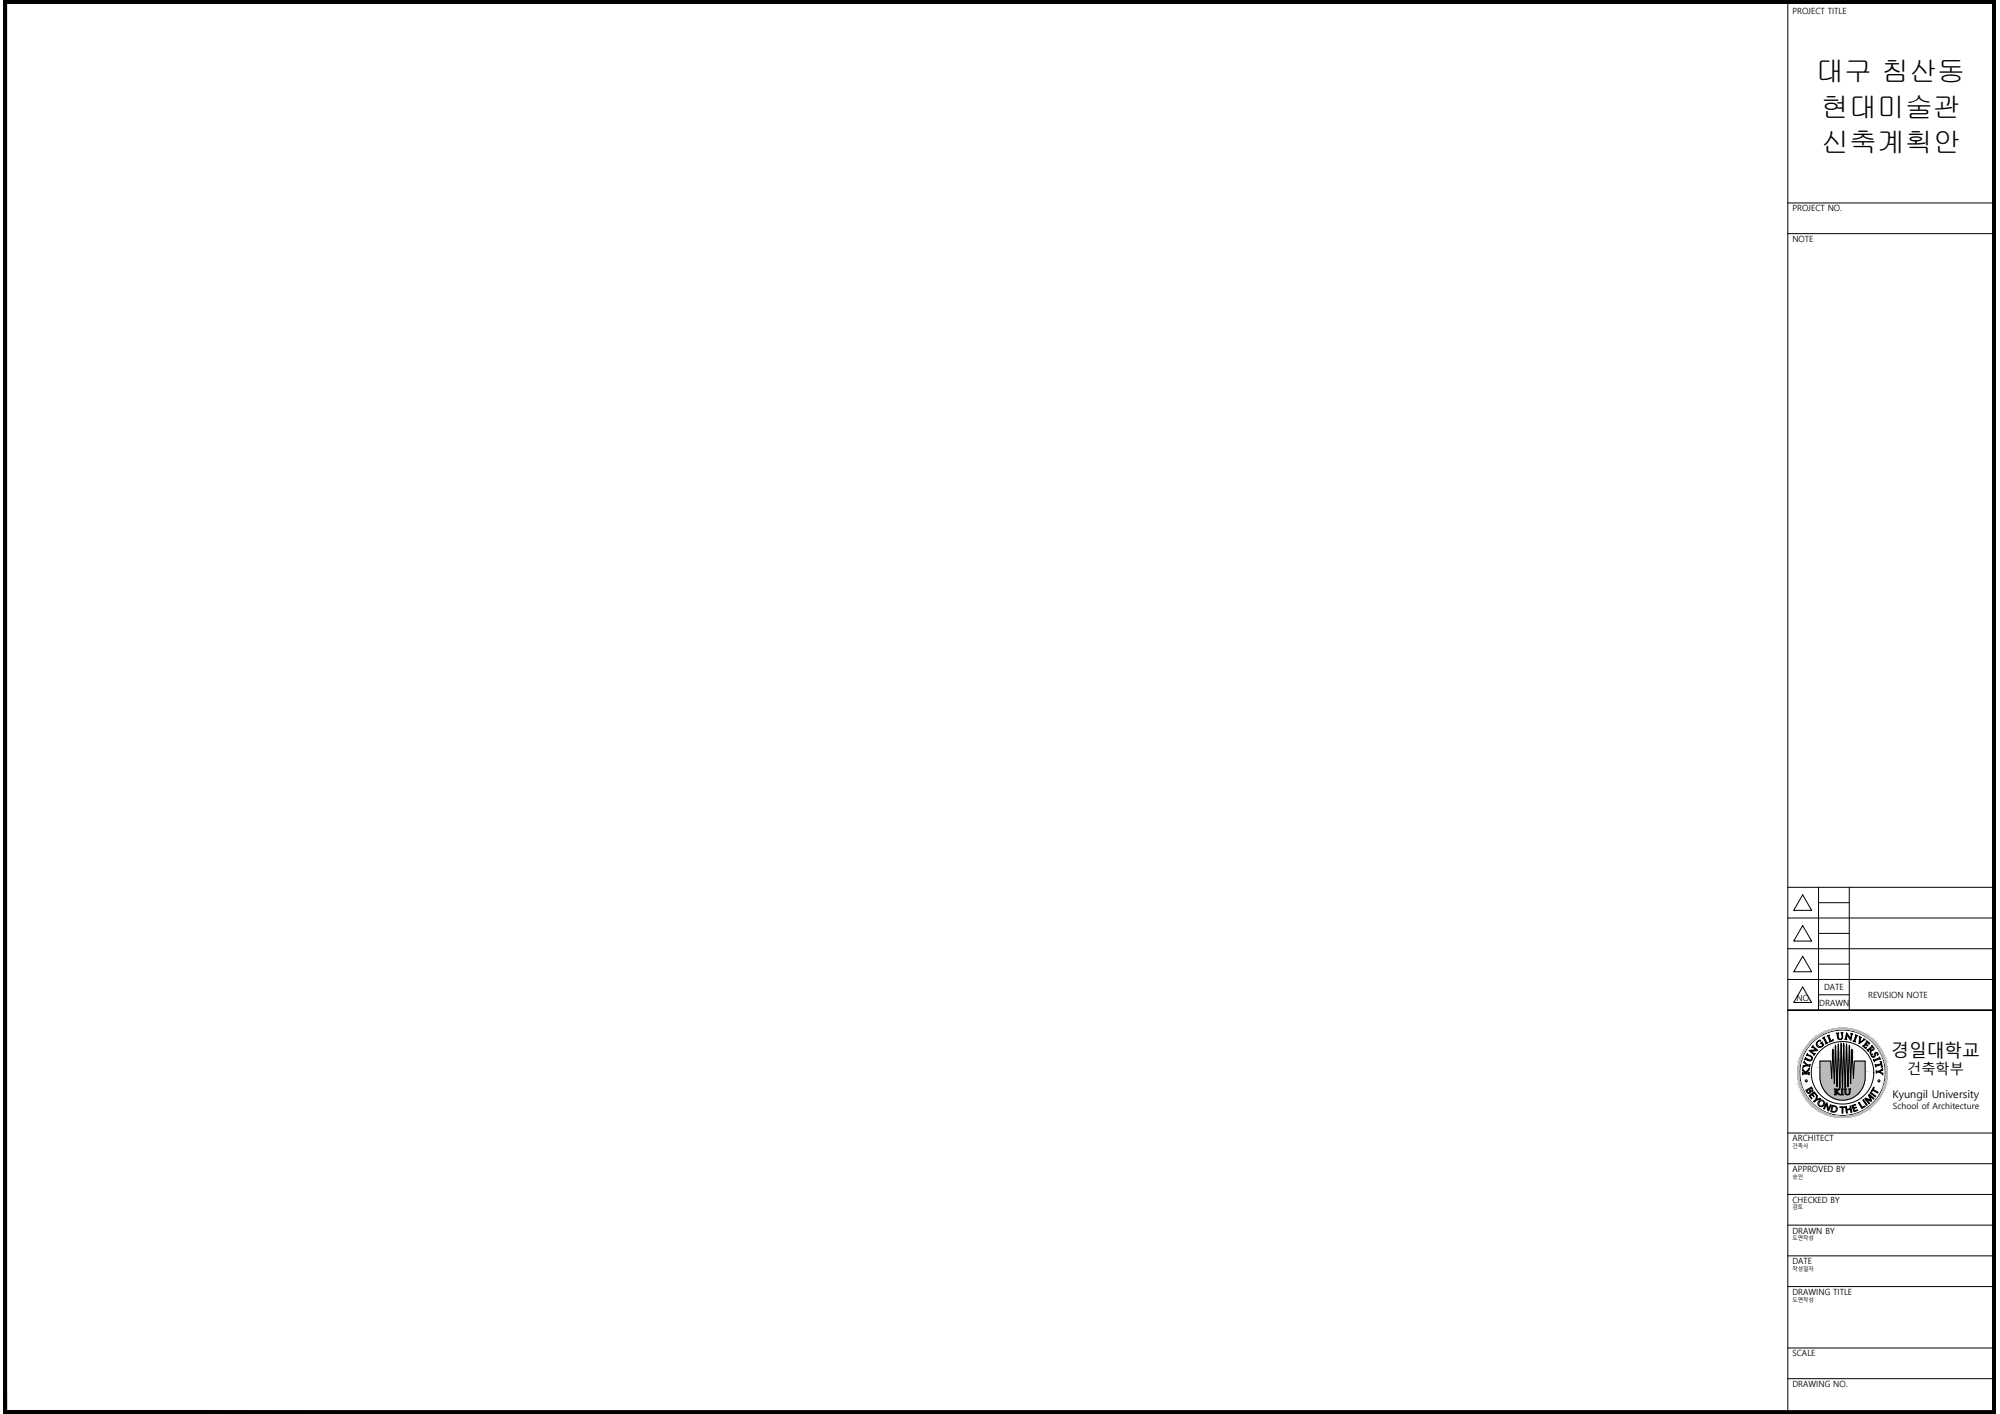
[picture p35: page 1]
대구 침산동; DATE DRAWN; REVISION NOTE; PROJECT TITLE; Kyungil University

NOTE PROJECT NO.

DRAWN BY DRAWING TITLE DATE APPROVED BY CHECKED BY

School of Architecture 도면작성

DRAWING NO. SCALE
