wpdnr3723-a11y/WORKMODE/(commit log)

2026-11-11 Install text-to-cad Claude Code plugin (project scope)
    Adds the earthtojake/text-to-cad marketplace (latest branch) and enables
    text-to-cad@earthtojake in project settings, giving Claude Code the CAD,
    PCB, FEA, drawing, render, 3D-print and robot-simulation skills.
    Claude-Session: https://claude.ai/code/session_01HkcFpm3UNzZLeJr3z9MnjB
2026-11-11 Add two-storey detached house model on a 300 m2 Yongin lot
    build123d model via text-to-cad: site, RC walls with openings, partitions,
    U-shaped stair, gable roof and terrace, plus check.py that tabulates the main
    Korean permit items (coverage, FAR, north sunlight setback, parking, stairs).
    Exports in GLB and STEP, preview images in house/images.
    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
    [house.step]
2026-11-11 Move house site to Unjung-dong, Seongnam (Seopangyo detached-housing district)
    Checks now use Class 1 exclusive residential limits (coverage 50%, FAR 100%,
    2 storeys) and the boundary fence becomes a 1.2 m hedge. The lot number is
    left to be confirmed on eum.go.kr; lot size stays 15 x 20 m as an assumption.
    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
    [house.step]
2026-11-11 Move house site to Gyeongsan 4 industrial complex housing lots near Kyungil Univ.
    Lot becomes an average 14.5 x 20 m (290 m2) parcel in Jillyang-eup,
    Gyeongsan; checks use the complex's detached-housing limits (Class 1 general
    residential, coverage 60%, FAR 180%, 3 storeys). Lot number still to be
    picked from the KICOX lot map.
    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
    [house.step]
2026-11-11 Add permit/construction-level drawing set for the Gyeongsan house
    spec.py now holds every design value (assemblies, openings, partitions with
    doors, rooms, finishes, structural members, areas) and drives the 3D model,
    the permit check and a new drawings.py that writes a 15-sheet A2 PDF: cover
    and code check, schedules, site plan, 1F/2F/roof plans at 1/50, four
    elevations, two sections, wall/eave/terrace details at 1/20, structural
    notes, member schedule and structural plans. The 3D model gains the mat
    foundation, beams, slab openings, door openings and real roof thickness;
    floor areas are now measured to wall centre lines.
    Claude-Sessi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
    [house.step]
